ml3rc/SNA/Software/docs/hardware/README.md

# Hardware (Altium)

4-layer PCB in a milled aluminium case. Altium project: [`Altium/SNA.PrjPcb`](../../../Altium/SNA.PrjPcb) ·
BOM / netlist / STEP: [`Altium/Project Outputs for SNA/`](../../../Altium/Project%20Outputs%20for%20SNA/) ·
pin map: [PINMAP.md](../firmware/protocol/PINMAP.md). Diagrams are draw.io sources in
[`../presentation/diagrams/`](../presentation/diagrams/); animations in
[`../presentation/animations/`](../presentation/README.md#animations).

## System

System overview

## Schematic sheets

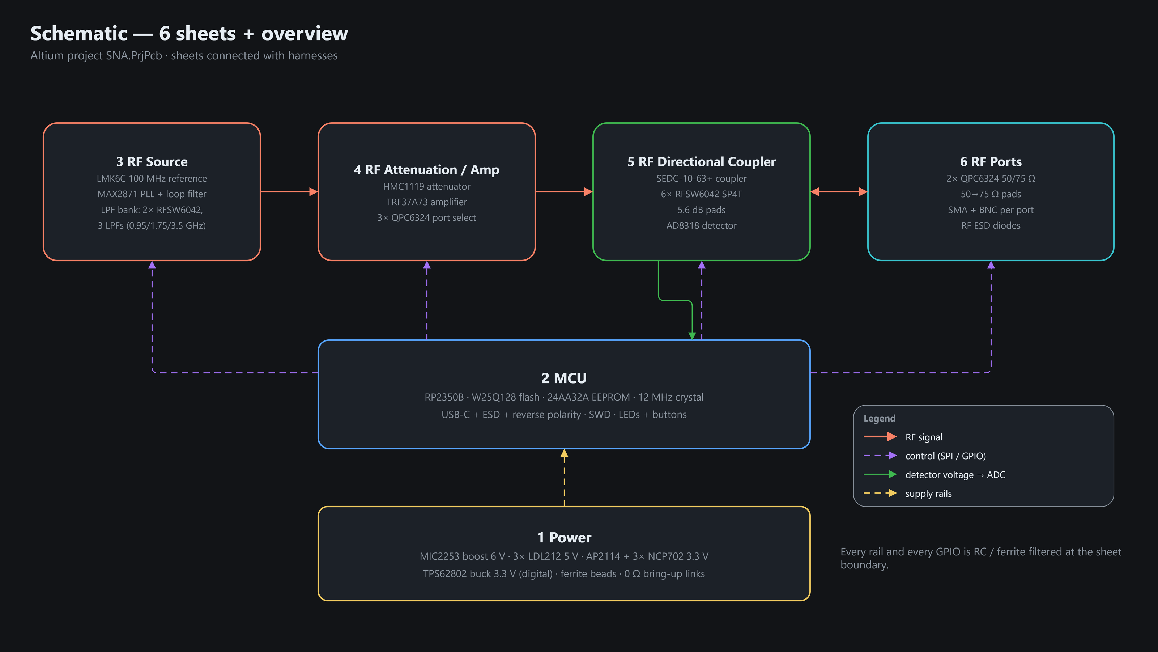
[picture p4: Software/docs/presentation/diagrams/export/hw-09-schematic-sheets.png]
Schematic sheets


| Sheet | Key parts |
|---|---|
| 1 Power | MIC2253 boost 6 V · 3× LDL212 5 V · AP2114 + 3× NCP702 3.3 V · TPS62802 buck 3.3 V |
| 2 MCU | RP2350B · W25Q128 flash · 24AA32A EEPROM · 12 MHz crystal · USB-C · SWD |
| 3 RF Source | LMK6C 100 MHz · MAX2871 · LPF bank (2× RFSW6042, 0.95 / 1.75 / 3.5 GHz LPFs) |
| 4 RF Attenuation / Amp | HMC1119 · TRF37A73 · 3× QPC6324 port select |
| 5 RF Directional Coupler | SEDC-10-63+ · 6× RFSW6042 · 5.6 dB pads · AD8318 |
| 6 RF Ports | 2× QPC6324 50/75 Ω · 50→75 Ω pads · SMA + BNC · RF ESD |

## Power

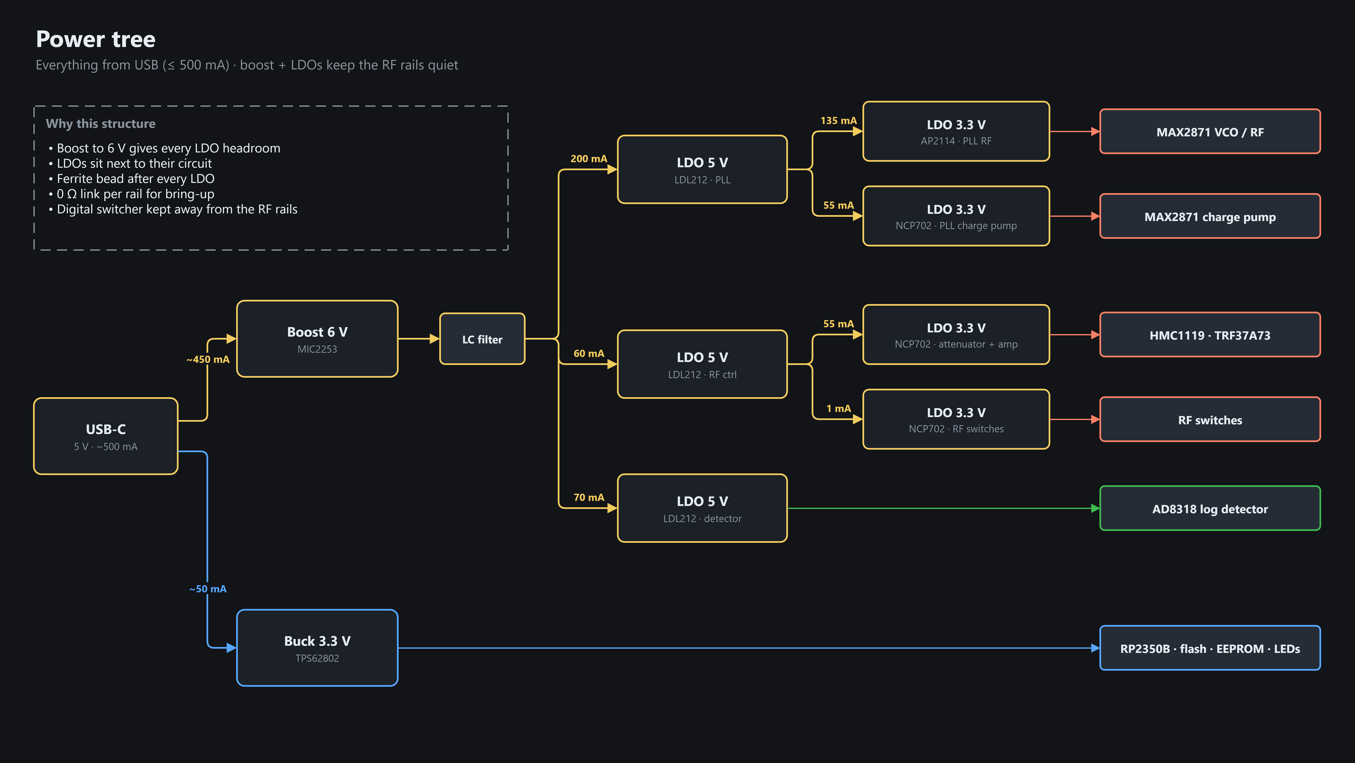
[picture p5: Software/docs/presentation/diagrams/export/hw-02-power-tree.png]
Power tree


## MCU

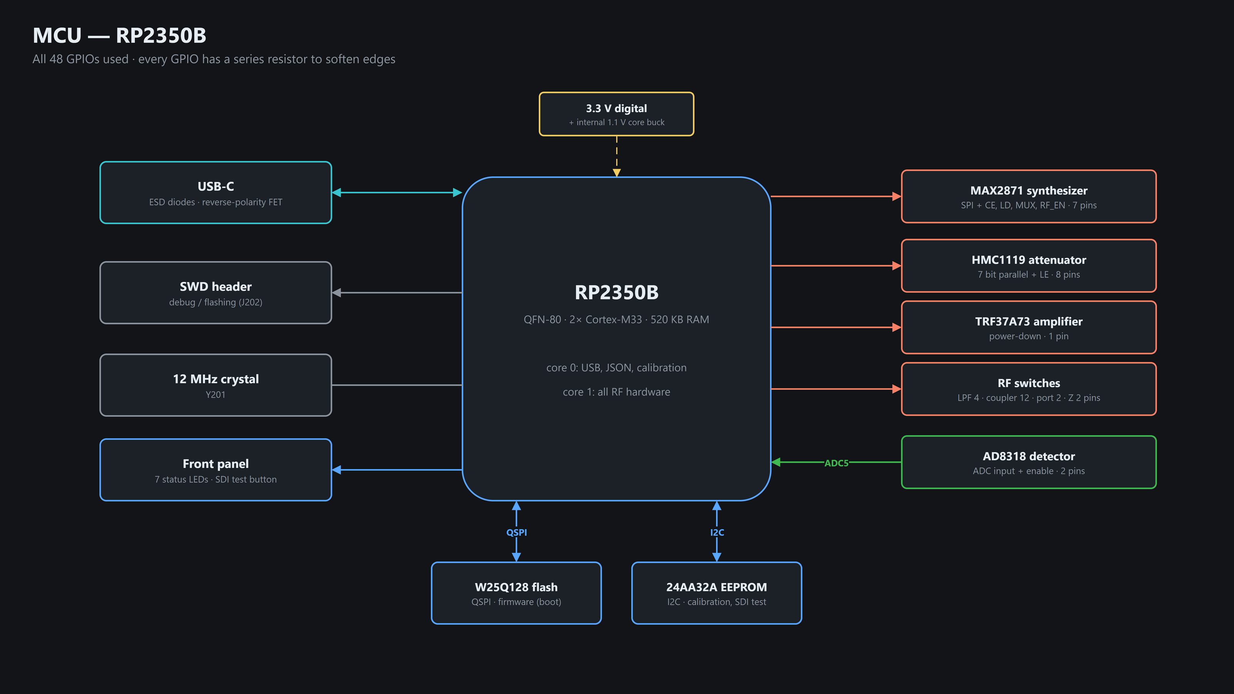
[picture p6: Software/docs/presentation/diagrams/export/hw-03-mcu.png]
MCU


## RF chain

RF chain

### Synthesizer (MAX2871)

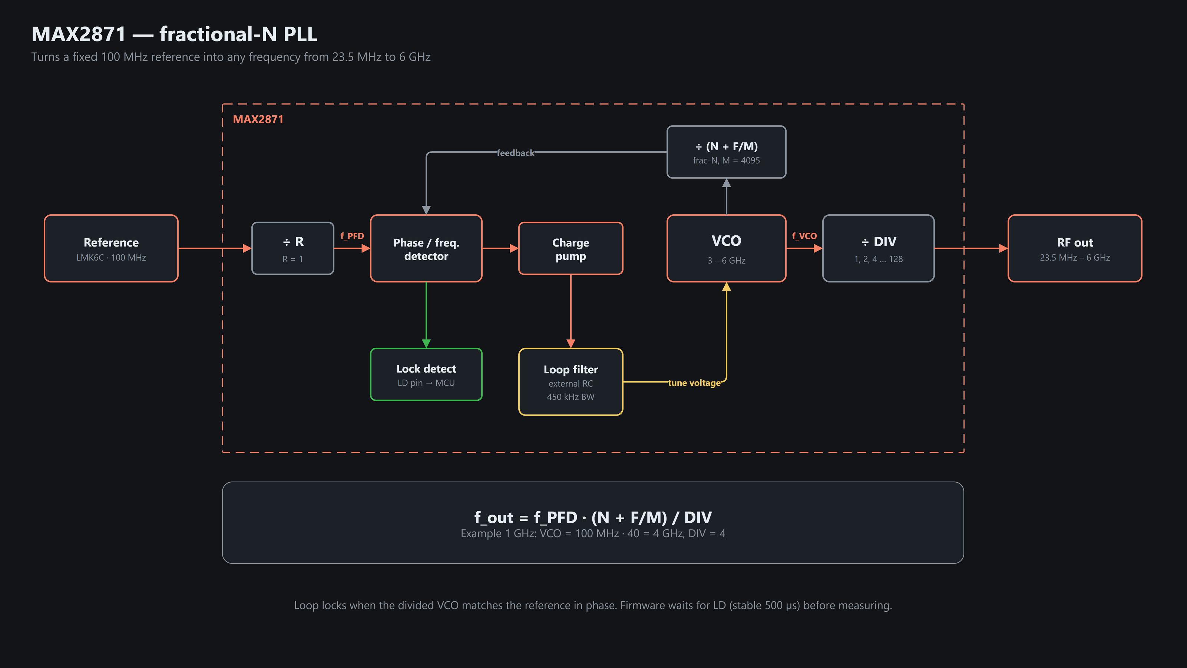
[picture p7: Software/docs/presentation/diagrams/export/hw-05-pll.png]
PLL


### Coupler bank → S-parameters

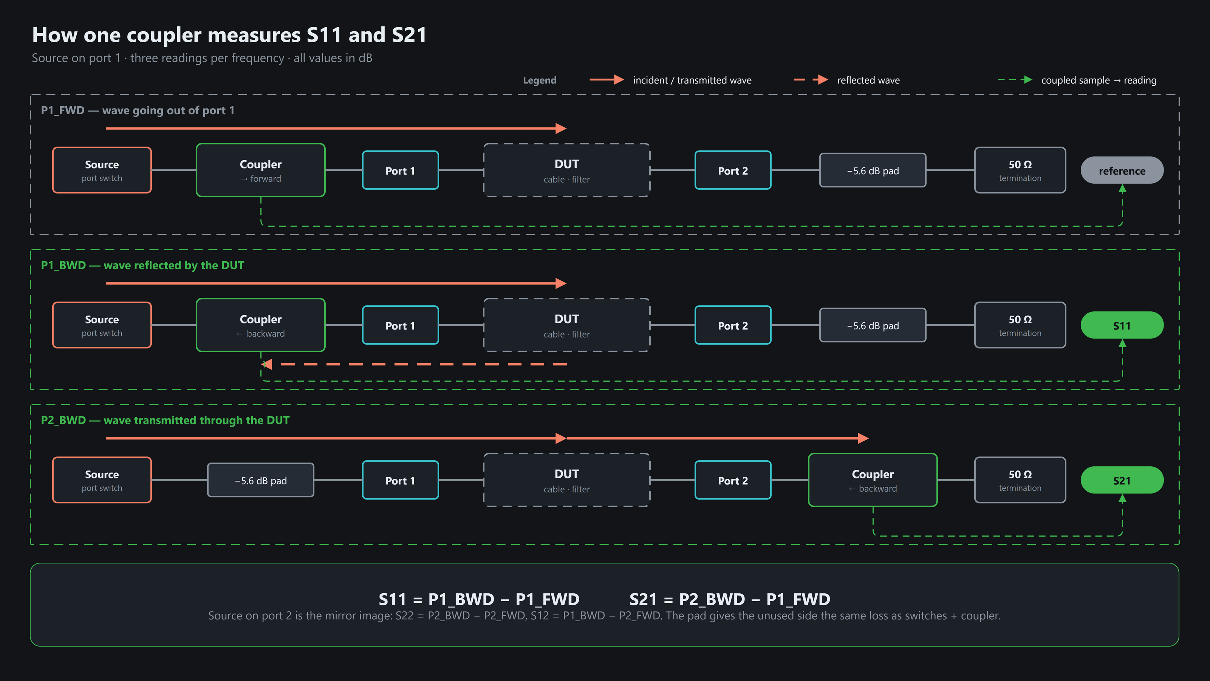
[picture p8: Software/docs/presentation/diagrams/export/hw-06-coupler-paths.png]
Coupler paths


### Pads

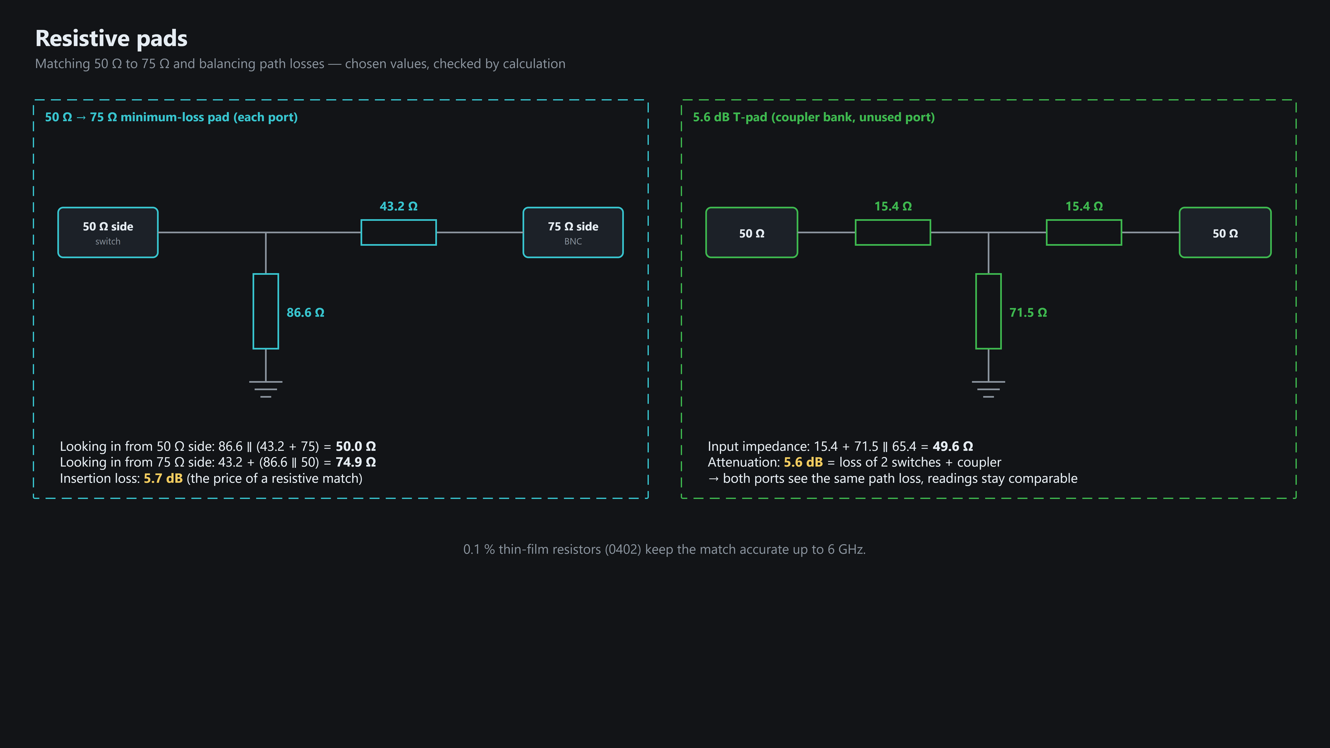
[picture p9: Software/docs/presentation/diagrams/export/hw-07-pads.png]
Pads


## PCB

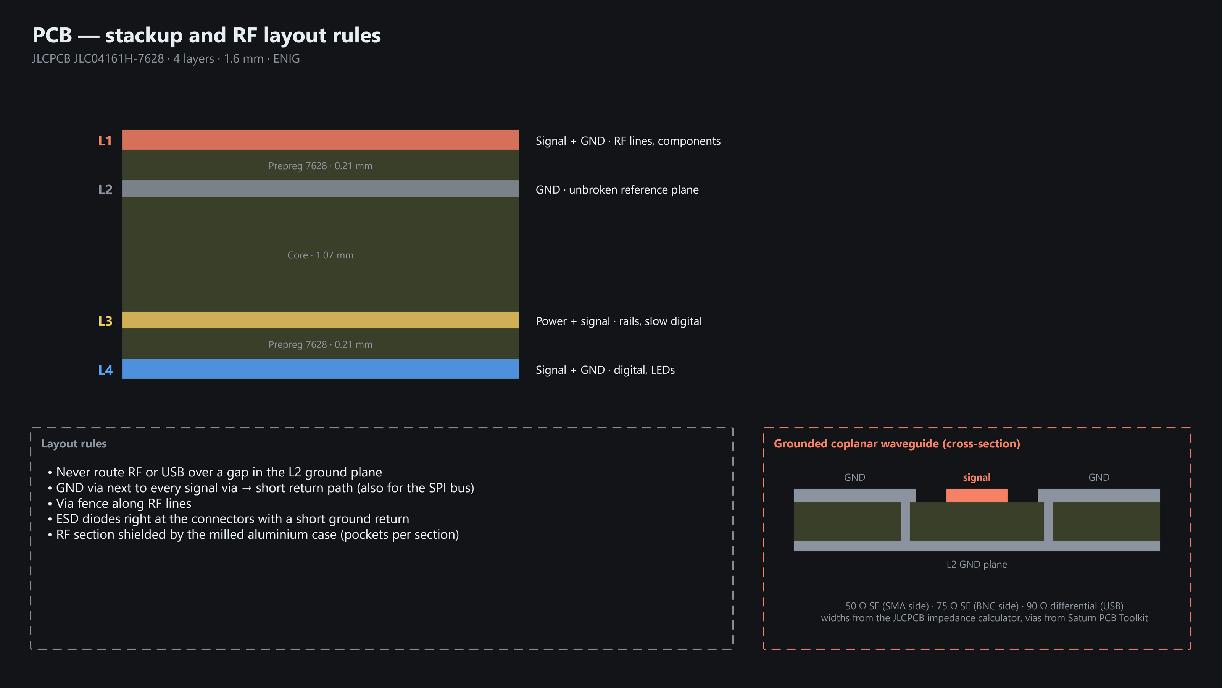
[picture p10: Software/docs/presentation/diagrams/export/hw-08-pcb-stackup.png]
Stackup


## Known erratum

Q202/Q203 (BSS84AK): footprint has drain and source swapped, so the body diode always lights the drain-side LED.
Hardware-only; fixed by rework, documented as a deviation in the report.
