ml3rc/SNA/Software/docs/presentation/README.md

# Presentation material

Dark theme, 16:9 (1600 × 900 canvas). Diagrams are English only; the animations also exist in German (see
[German animations](#german-animations)). Same palette in diagrams and animations:

| Colour | Meaning |
|---|---|
| `#F78166` | RF signal / source chain |
| `#58A6FF` | core 0, USB, digital |
| `#A371F7` | core 1, RF control firmware |
| `#3FB950` | detector, measurement, results |
| `#F2CC60` | power, warnings |
| `#39C5CF` | PC / client, ports |

## Diagrams (draw.io)

Sources: `diagrams/*.drawio` (open in draw.io desktop or diagrams.net). Exports for slides: `diagrams/export/*.png`
(2×) and `*.svg`.

| # | Diagram | Shows |
|---|---|---|
| hw-01 | [System overview](diagrams/export/hw-01-system-overview.png) | PC, board blocks, ports, DUT |
| hw-02 | [Power tree](diagrams/export/hw-02-power-tree.png) | USB → boost → LDOs, currents |
| hw-03 | [MCU](diagrams/export/hw-03-mcu.png) | RP2350B and everything on its pins |
| hw-04 | [RF chain](diagrams/export/hw-04-rf-chain.png) | Source → filters → level → port select → coupler bank → ports, detector |
| hw-05 | [PLL](diagrams/export/hw-05-pll.png) | MAX2871 fractional-N loop, formula |
| hw-06 | [Coupler paths](diagrams/export/hw-06-coupler-paths.png) | How one coupler measures S11 and S21 |
| hw-07 | [Pads](diagrams/export/hw-07-pads.png) | 50→75 Ω minimum-loss pad, 5.6 dB T-pad, with the math |
| hw-08 | [PCB stackup](diagrams/export/hw-08-pcb-stackup.png) | 4 layers, coplanar waveguide, layout rules |
| hw-09 | [Schematic sheets](diagrams/export/hw-09-schematic-sheets.png) | The 6 Altium sheets and how they connect |
| fw-01 | [Dual core](diagrams/export/fw-01-dual-core.png) | Core 0 / core 1 split, queues, cancel |
| fw-02 | [Layers](diagrams/export/fw-02-layers.png) | application → state → blocks → HAL |
| fw-03 | [Modes](diagrams/export/fw-03-modes.png) | IDLE and the four modes |
| fw-04 | [Sweep sequence](diagrams/export/fw-04-sweep-sequence.png) | Host ↔ core 0 ↔ core 1 ↔ RF, per point |
| fw-05 | [Sweep point](diagrams/export/fw-05-sweep-point.png) | Flowchart of one point |
| fw-06 | [Point timing](diagrams/export/fw-06-point-timing.png) | Where the ≈ 2 ms go, pipelining |
| fw-07 | [Source states](diagrams/export/fw-07-source-states.png) | OFF / PARKED / ON and the safe switching order |
| fw-08 | [Calibration](diagrams/export/fw-08-calibration.png) | Wizard steps → curves → EEPROM → subtraction |
| fw-09 | [EEPROM map](diagrams/export/fw-09-eeprom-map.png) | 4 KB layout to scale |
| fw-10 | [Boot](diagrams/export/fw-10-boot.png) | Boot sequence, blink codes, LEDs |
| fw-11 | [Request path](diagrams/export/fw-11-request-path.png) | JSON line → core 0 → core 1 → reply, what is allowed mid-sweep |
| fw-12 | [Raw → dB](diagrams/export/fw-12-raw-to-db.png) | Codes → ratio → calibration, the frequency grid |
| fw-13 | [SDI button + watchdog](diagrams/export/fw-13-sdi-button-watchdog.png) | On-board button test states, watchdog |
| api-01 | [Messages](diagrams/export/api-01-messages.png) | Request / reply / stream / event |
| api-02 | [Command map](diagrams/export/api-02-command-map.png) | Commands per mode |
| api-03 | [Sessions](diagrams/export/api-03-sequences.png) | Sweep session, generator → power meter session |
| api-04 | [Errors](diagrams/export/api-04-errors.png) | Validation order → error codes |
| sw-01 | [Client](diagrams/export/sw-01-client-architecture.png) | Kotlin Multiplatform client layers |

The `.drawio` files are the source: edit them directly in draw.io, then export with
`bash diagrams/src/export.sh [name …]` (needs draw.io desktop, `scoop install extras/draw.io`).
`diagrams/src/build_*.py` (helpers in `dio.py`) only produced the first version; re-running one overwrites hand
edits in the diagrams it builds. When several arrows mean the same thing, give the diagram a legend instead of
labelling one of them.

Electrical symbols are IEC everywhere (diagrams and animations): resistor = rectangle, always 90 × 30 px in the
diagrams (0.8 × 0.27 units in Manim, `resistor()` in `sna_style.py`), ground = three bars, amplifier = triangle.

## Animations (Manim)

1080p60 MP4s in `animations/videos/` (drop straight into PowerPoint / Google Slides). Sources:
`hardware_scenes.py`, `firmware_scenes.py`, shared look in `sna_style.py`.

Each video is also cut into its steps, one clip per caption: `animations/videos/steps/<Scene>/01.mp4, 02.mp4, …`
(German: `de/videos/steps/`). Stack the clips of a scene on one slide and give each one "Appear + Play" on click:
every click plays one step and the last frame stays until the next click. Step boundaries are `self.next_section()`
in the scenes (firmware scenes: every `Captions.show()` starts a step unless `step=False`).

| Video | Length | Shows |
|---|---|---|
| [PllSynthesis](animations/videos/PllSynthesis.mp4) | 30 s | PLL loop builds up, VCO locks to 4 GHz, ÷4 → 1 GHz, LD goes high |
| [DirectionalCoupler](animations/videos/DirectionalCoupler.mp4) | 41 s | Coupler principle, one coupler + 6 SP4T, three readings → S11 / S21 |
| [LogDetector](animations/videos/LogDetector.mp4) | 40 s | AD8318 curve, 16 samples → median, dB as a subtraction |
| [ImpedancePads](animations/videos/ImpedancePads.mp4) | 28 s | 50 / 75 Ω switch, minimum-loss pad, impedances both ways |
| [PowerTree](animations/videos/PowerTree.mp4) | 21 s | Rails light up from USB through boost and LDOs |
| [MeasurementFlow](animations/videos/MeasurementFlow.mp4) | 55 s | One S11 point: JSON → cores → RF → detector → dB → chart |
| [SweepPipeline](animations/videos/SweepPipeline.mp4) | 48 s | Per-point timing, two cores in a pipeline, backpressure, curve drawn |
| [Calibration](animations/videos/Calibration.mp4) | 54 s | Open / Short / Thru → curves → EEPROM → raw − curve |
| [SourceSafety](animations/videos/SourceSafety.mp4) | 46 s | Wrong vs right parking order, double register write |
| [ModesAndCommands](animations/videos/ModesAndCommands.mp4) | 30 s | Mode state machine with a live JSON log, `busy`, `mode_exit` |

Example numbers in the animations (ADC codes, levels, curve shapes) are illustrative, not measurements.

Render (from `animations/`, Python 3.12 venv with `manim==0.19.0`, no LaTeX needed):

```sh
uv venv --python 3.12 .venv && uv pip install --python .venv/Scripts/python.exe manim==0.19.0
bash render.sh                 # all scenes → videos/
bash render.sh PllSynthesis    # one scene
```

## German animations

Same videos with German labels, for the German slides. Exported only: the repo documentation links the English
files. Output: `de/videos/*.mp4` and `de/videos/steps/`. The diagrams have no German version.

All animation labels go through `i18n.py`: `SNA_LANG=de` looks each English string up in `i18n_de.py` (whole label
first, then line by line) and switches decimal points to commas; commands, JSON, part numbers and signal names stay
as they are. A new or changed English label needs its German entry; strings without one stay English and are listed
with `SNA_I18N_REPORT=<file>`.

```sh
cd animations && SNA_LANG=de bash render.sh    # → de/videos/
```
