ml3rc/SNA/Software/docs/firmware/boot-and-leds.md

# Boot, LEDs & SDI button

There is no separate front panel: the LEDs and the SDI test button sit on the PCB, and the milled aluminium case has
vertical holes above them (LEDs show through, the button is pressed through the case).

## Boot and LEDs

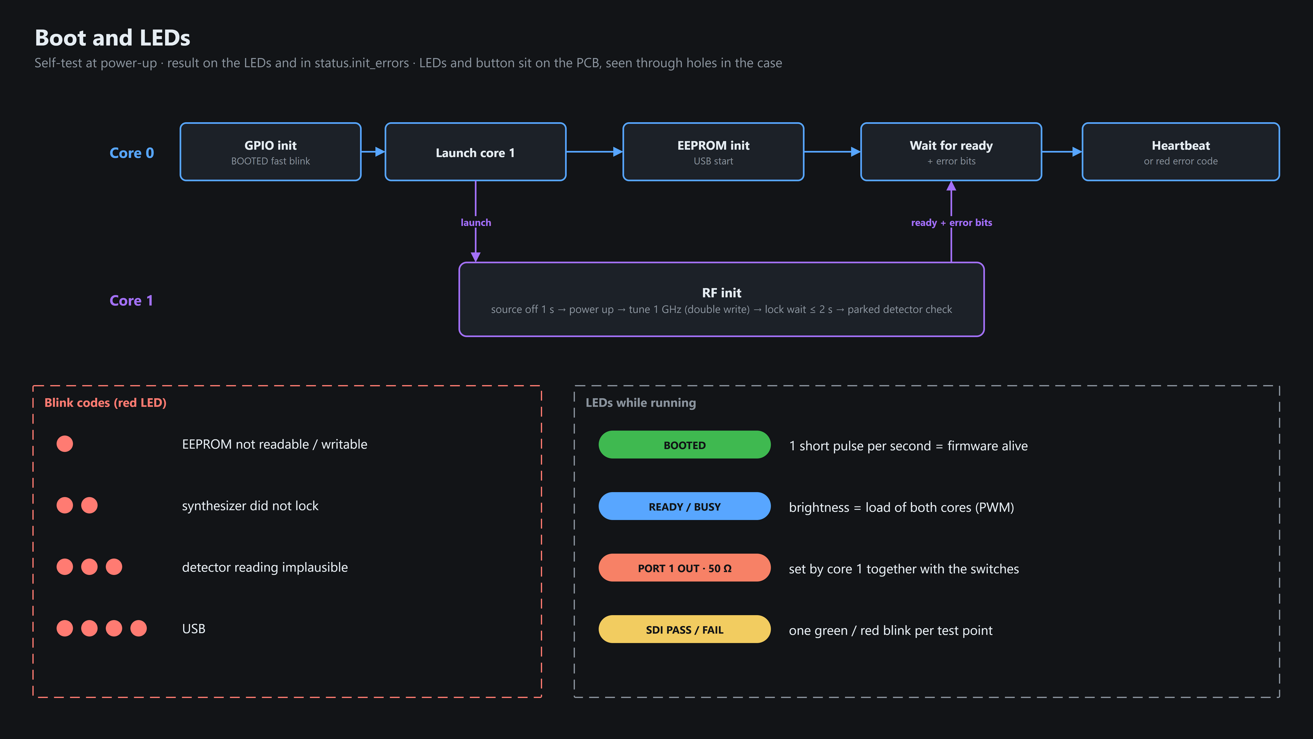
[picture p18: Software/docs/presentation/diagrams/export/fw-10-boot.png]
Boot and LEDs


## SDI test button (works without a PC) and watchdog

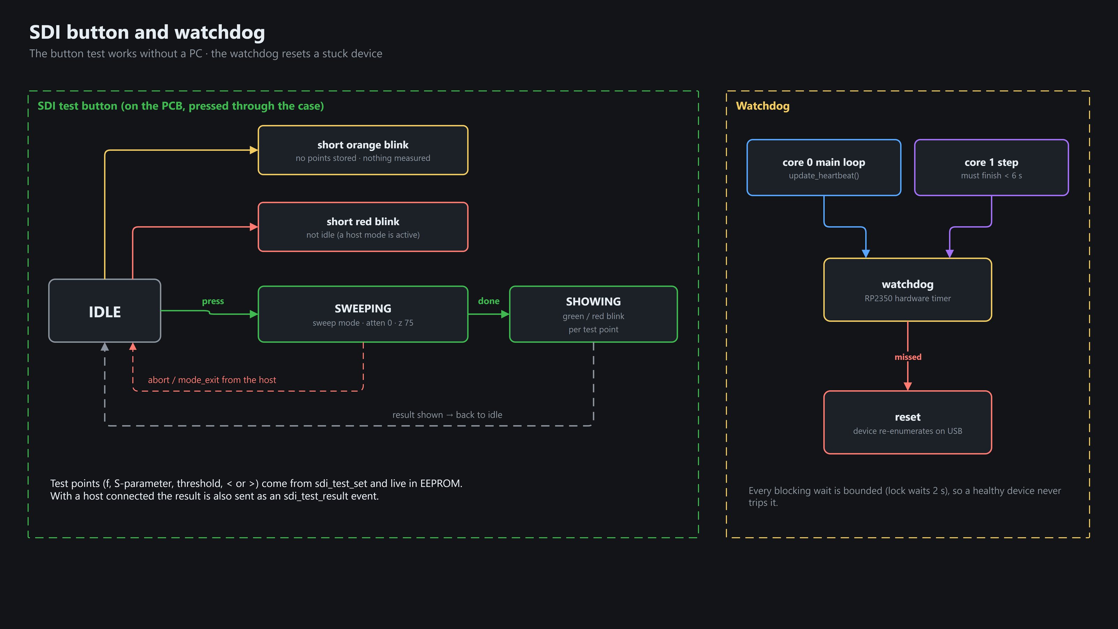
[picture p19: Software/docs/presentation/diagrams/export/fw-13-sdi-button-watchdog.png]
SDI button and watchdog
