ml3rc/SNA/Software/docs/firmware/modes.md

# Modes

One mode owns the RF hardware at a time. The host enters it, uses it, leaves it.

Modes

| Mode | Does | Output |
|---|---|---|
| IDLE | nothing | parked |
| SWEEP | S-parameter / raw-path sweeps (also entered by the SDI button) | routed per point |
| GENERATOR | CW signal at port 1/2 | on |
| PWR_DETECTOR | measure external power at a port | terminated |
| MANUAL | drive single blocks (bench diagnostics) | as set |

Settings (`set` z / atten) work in every mode, even mid-sweep. Only requests that endanger hardware are refused.

## Request path

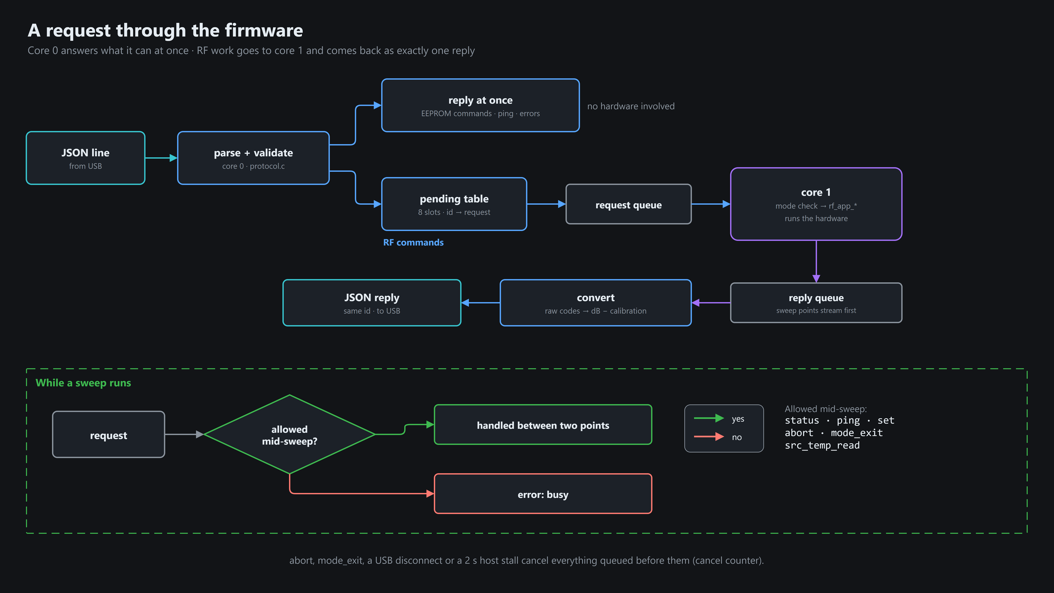
[picture p20: Software/docs/presentation/diagrams/export/fw-11-request-path.png]
Request path
