ml3rc/SNA/Software/docs/firmware/sweep.md

# Sweep

## End to end

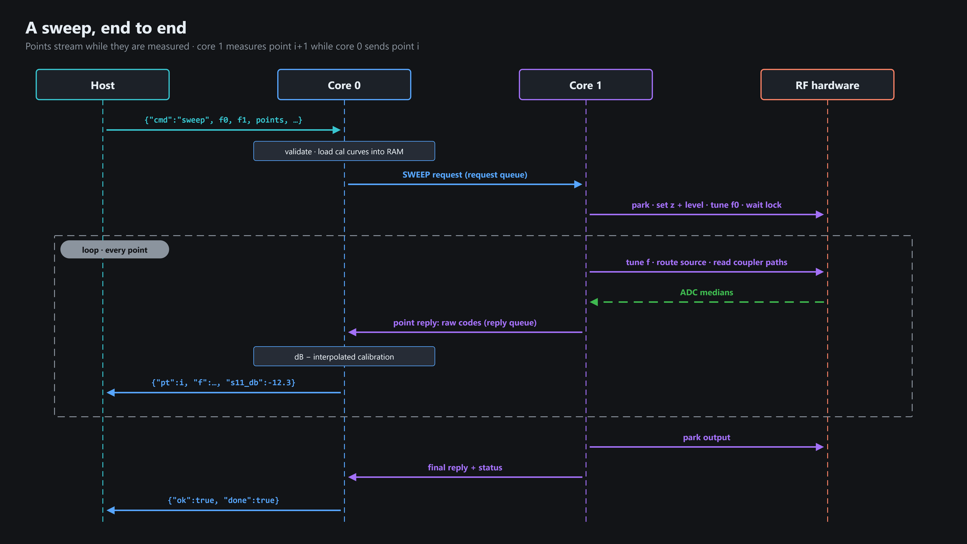
[picture p23: Software/docs/presentation/diagrams/export/fw-04-sweep-sequence.png]
Sweep sequence


Points are pipelined: core 1 measures point N+1 while core 0 sends point N.

## One point (core 1)

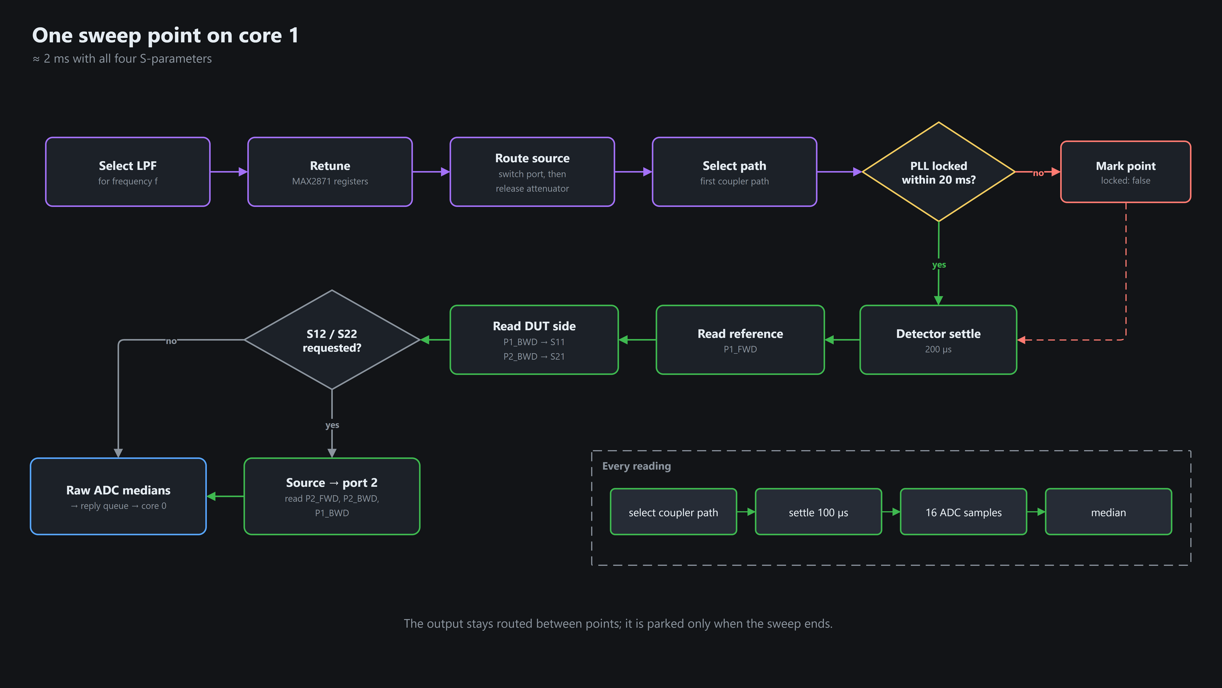
[picture p24: Software/docs/presentation/diagrams/export/fw-05-sweep-point.png]
Sweep point


## Time per point (all 4 S-parameters, ≈ 2 ms)

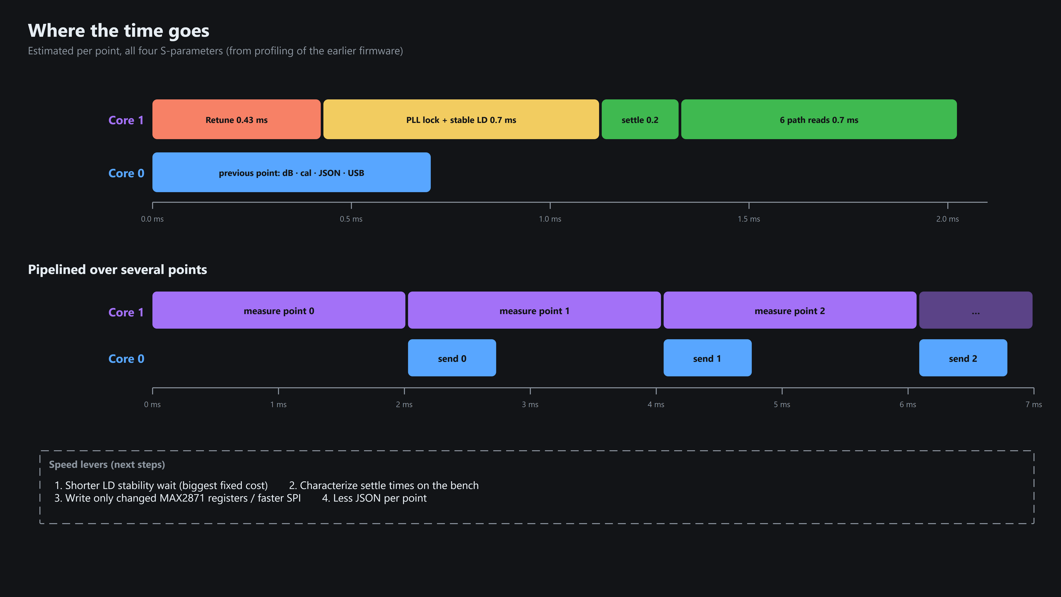
[picture p25: Software/docs/presentation/diagrams/export/fw-06-point-timing.png]
Point timing


## Raw codes → calibrated dB (core 0) and the frequency grid

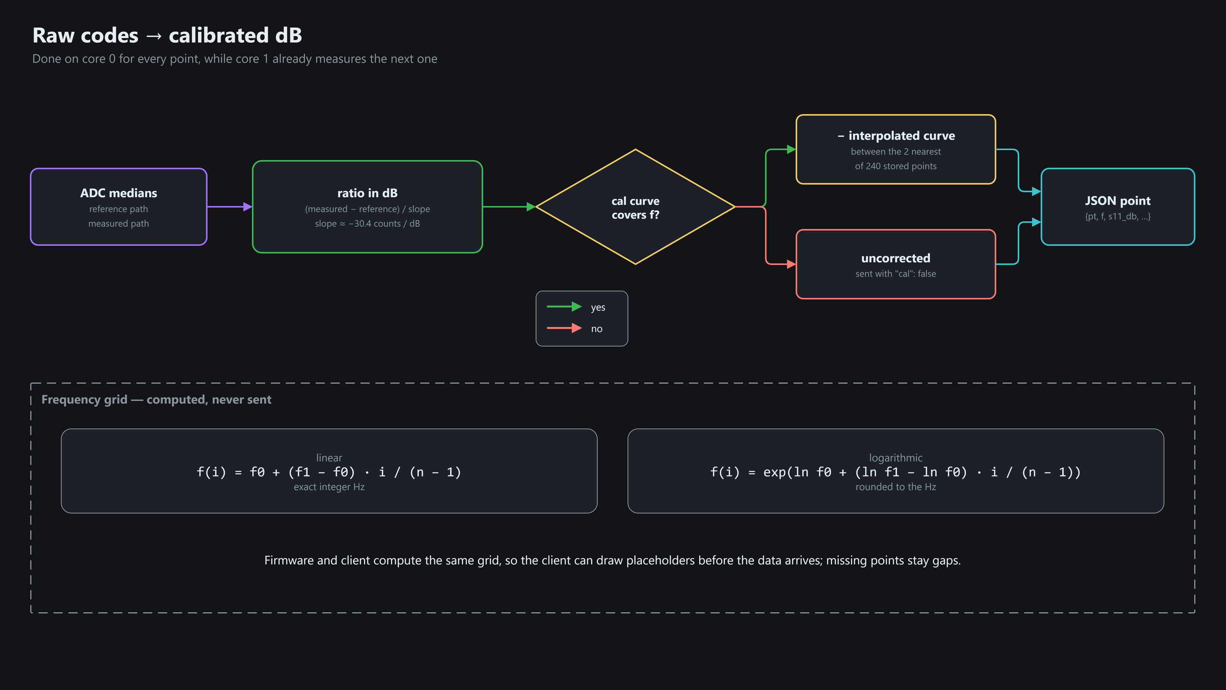
[picture p26: Software/docs/presentation/diagrams/export/fw-12-raw-to-db.png]
Raw to dB
