ml3rc/SNA/Software/docs/presentation/de/diagrams/api-01-messages.png

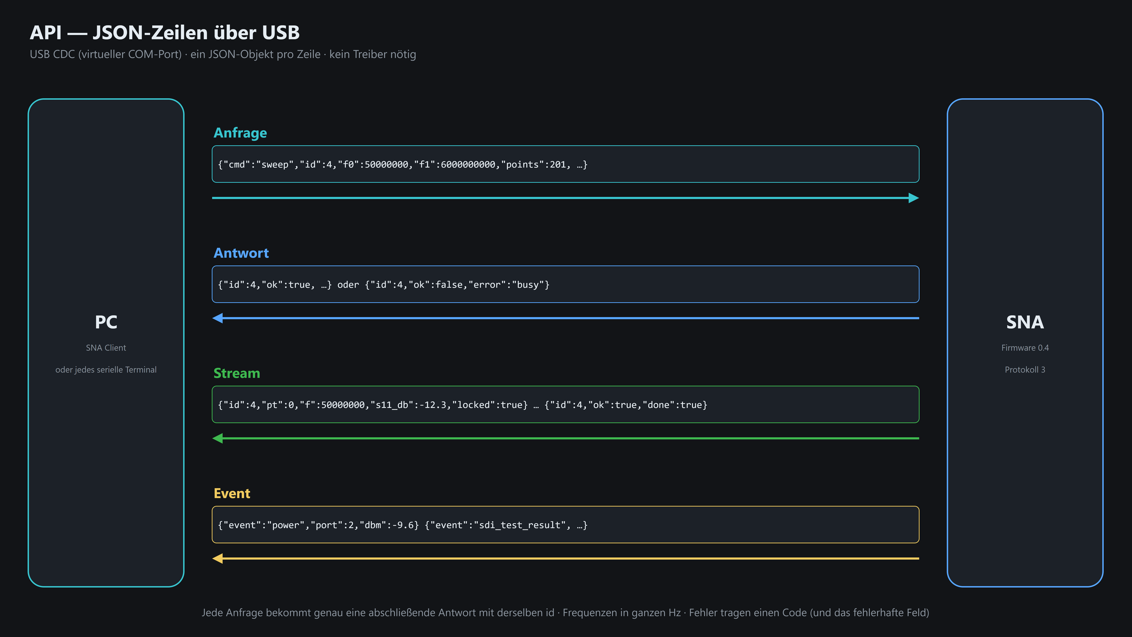
Software/docs/presentation/de/diagrams/api-01-messages.png
