ml3rc/SNA/Software/docs/presentation/de/diagrams/api-04-errors.png

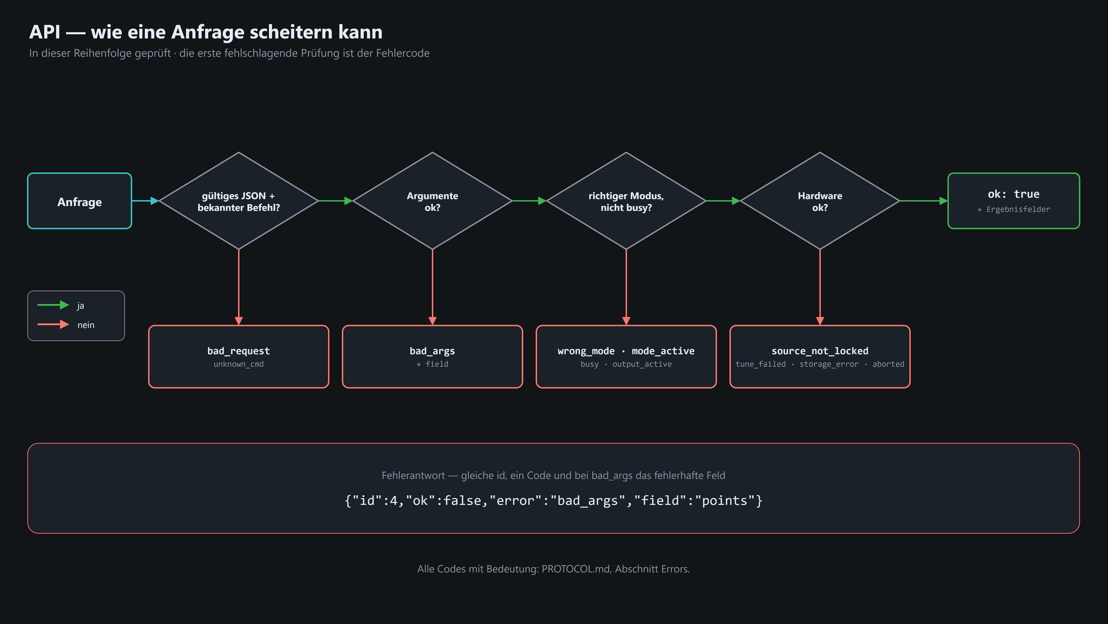
Software/docs/presentation/de/diagrams/api-04-errors.png
