ml3rc/SNA/Software/docs/presentation/de/diagrams/fw-03-modes.png

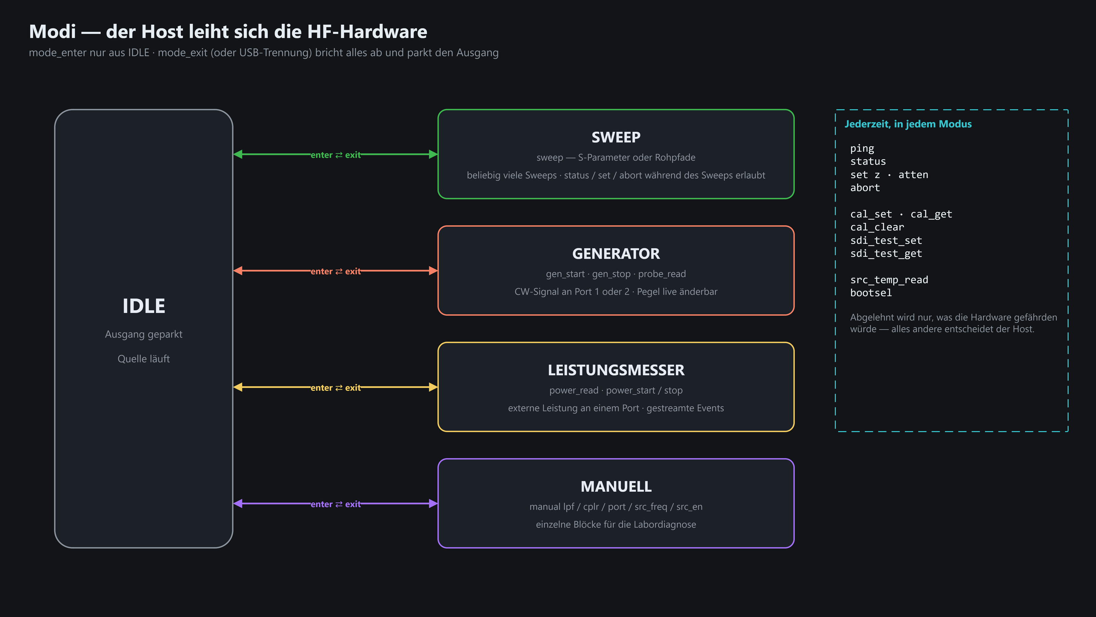
Software/docs/presentation/de/diagrams/fw-03-modes.png
