ml3rc/SNA/Software/docs/presentation/de/diagrams/fw-09-eeprom-map.png

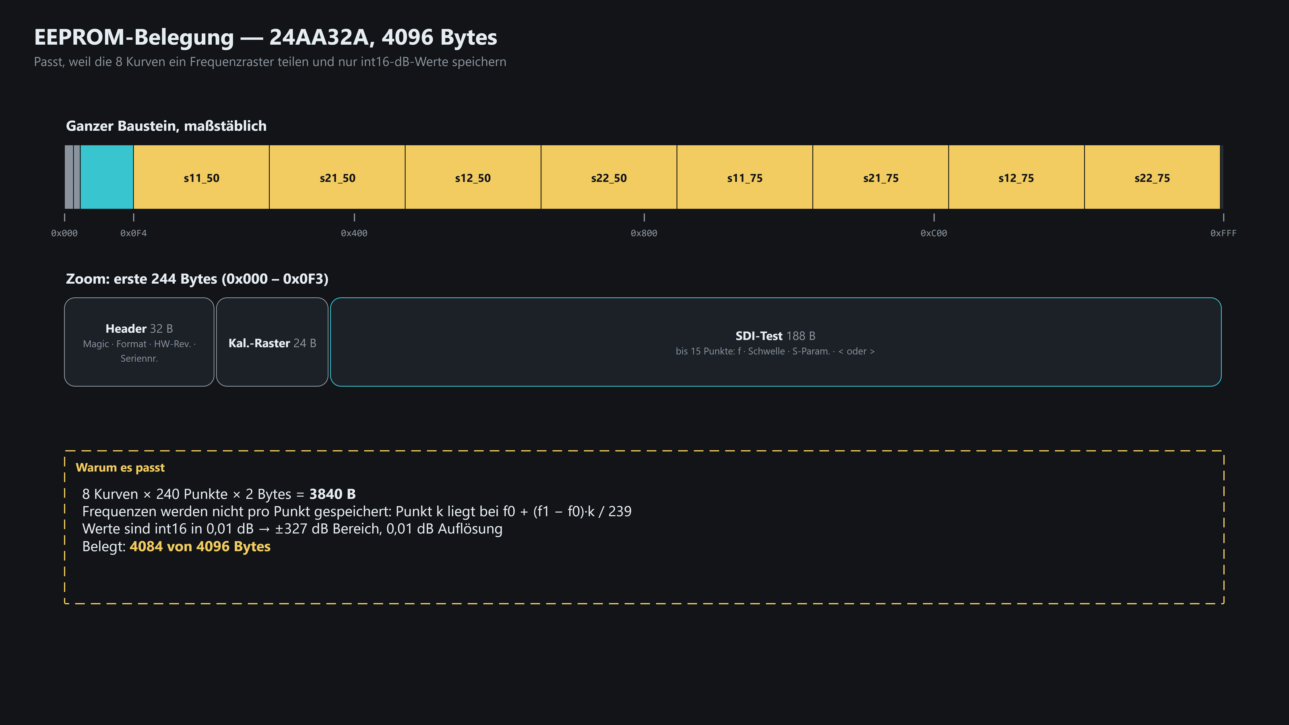
Software/docs/presentation/de/diagrams/fw-09-eeprom-map.png
