ml3rc/SNA/Altium/SNAPCBVersion-INT/BOM/SNAPCBVersion_SNA-Var_EMS_BOM_Rev.PCBVersion1.0.pdf

Name | Description | Designator | Quantity | Manufacturer 1 | Manufacturer Part Number 1
4.7u | Capacitor ceramic 4.7u 25V 10% X7R SMD--0805 | C101, C102, C103, C113, C114, C115, C122, C126 | 8 | Samsung Electro-Mechanics | CL21B475KAFNNNE
10n | Capacitor ceramic 10n 50V 5% C0G/NPO SMD--0603 | C104 | 1 | Murata | GRM1885C1H103JA01D
100p | Capacitor ceramic 100p 50V 5% C0G AEC-Q200 SMD--0402 | C105, C301, C302, C303, C305, C323, C324, C326, C327, C330, C331, C401, C402, C403, C404, C405, C406, C407, C408, C409, C410, C411, C412, C413, C414, C415, C416, C419, C421, C423, C424, C427, C428, C432, C433, C503, C504, C507, C508, C510, C511, C512, C513, C515, C516, C517, C518, C523, C524, C527, C528, C603, C604, C605, C606, C607, C608 | 57 | Samsung Electro-Mechanics | CL05C101JB51PND
10u | Capacitor ceramic 10u 25V 20% X5R SMD--0603 | C106 | 1 | Murata | GRM188R61E106MA73D
22u | Capacitor ceramic 22u 25V 20% X5R SMD--0805 | C107, C108, C109 | 3 | TAIYO YUDEN | MSAST21GBB5226MTNC12
1u | CAP CER 1UF 35V X7R 0603 10% | C110, C111, C112, C116, C117, C118, C119, C120, C121, C123, C124, C125, C312, C313, C316 | 15 | TDK | C1608X7R1V105K080AC
100n | Capacitor ceramic 100n 16V 10% X7R SMD--0402 | C127, C128, C129, C130, C131, C203, C209, C210, C211, C212, C213, C214, C215, C216, C217, C218, C219, C222, C306, C307, C308, C309, C310, C311, C315, C319, C322, C325, C328, C417, C420, C422, C425, C429, C434, C435, C505, C506, C509, C514, C519, C520, C525, C526, C529, C530, C609, C610 | 48 | Samsung Electro-Mechanics | CL05B104KO5NNNC
15p | Capacitor ceramic 15p 50V 1% C0G SMD--0402 | C201, C202 | 2 | Yageo Group | CQ0402FRNPO9BN150
10n | Capacitor ceramic 10n 35V 2% C0G SMD--0402 | C204, C531, C532 | 3 | Murata | GRM1555CYA103GE01D
4.7u | Capacitor ceramic 4.7u 6.3V 20% X5R SMD--0402 | C205, C206, C207, C208 | 4 | Murata | GRM155R60J475ME47D
470p | Capacitor ceramic 470p 50V 5% C0G SMD--0402 | C304, C314, C320, C329, C418, C426, C501, C502, C521, C522, C533, C534, C611, C612, C613, C614 | 16 | TDK | CGA2B2C0G1H471J050BA
180p | Capacitor ceramic 180p 50V 5% C0G SMD--0402 | C317 | 1 | Samsung Electro-Mechanics | CL05C181JB5NNNC
3.3n | Capacitor ceramic 3.3n 50V 10% X7R AEC-Q200 SMD--0402 | C318 | 1 | Samsung Electro-Mechanics | CL05B332KB5VPNC
18p | Capacitor ceramic 18p 50V 5% C0G SMD--0402 | C321 | 1 | Samsung Electro-Mechanics | CL05C180JB5NNNC
SSA24-E3/61T | Schottky Diode SSA24-E3/61T 40V 2A | D101 | 1 | Vishay | SSA24-E3/61T
ESD9R3.3S | TVS Diode ESD9R3.3ST5G 3V3 0.5pF, 1nA SMD--SOD-923 | D201, D202, D203, D204, D205 | 5 | onsemi | ESD9R3.3ST5G
150060RS75000 | LED 150060RS75000 2V 30mA Red 630nm 250mcd 140° SMD--0603 | D206 | 1 | Wuert Elektronik | 150060RS75000
150060GS75000 | LED 150060GS75000 3.2V 30mA Green 515nm 430 mcd 140° SMD--0603D207, D208, D209, D210, D211, D212, D213, D214, D215 | | 9 | Wuert Elektronik | 150060GS75000
SESD0402X1BN-0010-098 | TVS Diode, 7V, 0.1pF | D216, D601, D602, D603, D604 | 5 | Littelfuse | RF2945-000
LP0805A3500AWTR | Low Pass Filter 3500MHz 50 Ohms | FL301 | 1 | KYOCERA AVX | LP0805A3500AWTR
LP0603A1747ANTR | Low Pass Filter 1747MHz 50 Ohms | FL302 | 1 | KYOCERA AVX | LP0603A1747ANTR
LP0603A0947ANTR | Low Pass Filter 947MHz 50 Ohms | FL303 | 1 | KYOCERA AVX | LP0603A0947ANTR
SEDC-10-63+ | Directional Coupler, 50 MHz to 6 GHz, 50 Ohms, SMD | FL501 | 1 | Mini-Circuits | SEDC-10-63+
Type C f | Connector USB 2171790001 Type C f MOL--CO--2171790001 | J201 | 1 | Molex | 217179-0001
SM03B-SRSS-TB | Connector SM03B-SRSS-TB SMD, 90°, Raspberry JST Debug | J202 | 1 | JST | SM03B-SRSS-TB(LF)(SN)
SMA f | Connector Coaxial 142-0701-871 SMA f Edge--142-0701-871 | J601, J603 | 2 | Chinch Connectivity Solutions Johnson 142-0701-871
BNC jack | Connector Coaxial BNC7T-J-P-GN-RA-BM1D BNC jack right angle 75OhmJ602, J604 | | 2 | Samtec | BNC7T-J-P-GN-RA-BM1D
2.2u | Inductor SRP4020FA-2R2M 2.2u 3.1A 21.35mR 38MHz SMD--SRP4020FAL101, L103, L104 | | 3 | Bourns | SRP4020FA-2R2M
470n | Inductor DFE252012F-R47M=P2 470n 7.4A 17mR SMD--2520 | L102 | 1 | Murata | DFE252012F-R47M=P2
33E | Ferrit Bead MPZ1005S330HT000 33E 3A 22mE SMD--0402 | L105, L106, L107, L108, L109, L110, L111, L201, L202, L205, L301, L302, L303, L304, L305, L306, L401, L402, L404, L405, L406, L407, L501, L502, L503, L504, L505, L506, L507, L508, L601, L602 | 32 | TDK Group | MPZ1005S330HT000
3.3u | Inductor AOTA-B201610S3R3-101-T 3.3u 2.1A 140mOhm | L203 | 1 | Abracon | AOTA-B201610S3R3-101-T
100nH | Inductor 100nH 290mA AEC-Q200 SMD--0603 | L403 | 1 | Coilcraft | 0603DC-R10XJRW
DMP6050SFG | MOSFET, P-channel, 60 V, -4.8 A | Q201 | 1 | Diodes Inc. | DMP6050SFG-13
BSS84AK,215 | MOSFET P-CH 50V 180MA TO236AB | Q202, Q203 | 2 | Nexperia | BSS84AK,215
249k | Resistor 249k 75V 0.1W 0.1% SMD--0603 | R101 | 1 | Yageo Group | RT0603BRD07249KL
620E | Resistor 620E 75V 0.1W 0.1% ±25ppm/°C SMD--0603 | R102 | 1 | Yageo Group | RT0603FRE07620RL
10k | Resistor 10k 75V 0.1W 0.1% 25ppm SMD--0603 | R103, R105 | 2 | Susumu | RG1608P-103-B-T5
38.3k | Resistor 38.3k 75V 0.1W 0.1% SMD--0603 | R104 | 1 | Yageo Group | RT0603BRD0738K3L
4.7k | Resistor 4.7k 75V 0.1W 1% SMD--0603 | R106 | 1 | Yageo Group | RC0603FR-074K7L
0E | Resistor 0E 75V 0.125W SMD--0603 | R107, R108, R109, R110, R111, R112, R113, R114, R115 | 9 | Vishay | MCT06030Z0000ZP500
1k | Resistor 1k 50V 0.063W 1% SMD--0402 | R201, R202, R203, R260, R263, R537, R538 | 7 | Panasonic | ERJ2RKF1001X

Name | Description | Designator | Quantity | Manufacturer 1 | Manufacturer Part Number 1
10k | Resistor 10k 50V 0.063W 1% SMD--0402 | R204, R206, R228, R261, R264, R301, R302, R303, R304, R312, R313, R315, R316, R317, R318, R319, R320, R401, R402, R403, R404, R405, R406, R407, R408, R409, R410, R411, R412, R413, R501, R502, R503, R504, R505, R506, R507, R508, R511, R512, R513, R514, R517, R518, R521, R522, R525, R526, R527, R528, R531, R532, R533, R534, R536, R601, R602, R603, R604 | 59 | Panasonic | ERJ-2RKF1002X
5.1k | Resistor 5.1k 50V 0.063W 1% SMD--0402 | R205, R207, R305 | 3 | Panasonic | ERJ-2RKF5101X
33E | Resistor 33E 50V 0.063W 0.5% SMD--0402 | R208 | 1 | Panasonic | ERA-2AKD330X
71.5E | Resistor 71.5E 50V 0.0625W 0.1% SMD--0402 | R209, R223, R224, R225, R226, R227, R258, R259, R262, R519, R520 | 11 | Panasonic | ERA-2AEB71R5X
100E | Resistor 100E 50V 0.063W 0.01 SMD--0402 | R210, R211, R212, R213, R214, R215, R216, R217, R218, R219, R220, R221, R231, R232, R233, R234, R235, R236, R237, R238, R239, R240, R241, R242, R243, R244, R245, R246, R247, R248, R249, R250, R251, R252, R253, R254, R255, R265, R266, R314 | 40 | Vishay | CRCW0402100RFKEDC
200E | Resistor 200E 50V 0.063W 1% SMD--0402 | R222 | 1 | Panasonic | ERJ-2RKF2000X
4.7k | Resistor 4.7k 50V 0.063W 1% SMD--0402 | R229, R230 | 2 | Panasonic | ERJ-2RKF4701X
27E | Resistor 27E 50V 0.063W 1% SMD--0402 | R256, R257 | 2 | Vishay | CRCW040227R0FKED
49.9E | Resistor 49.9E 50V 0.1W 1% SMD--0402 | R306, R307, R308, R509, R510, R529, R530 | 7 | Stackpole Electronics | RNCP0402FTD49R9
1.8k | Resistor 1.8k 50V 0.063W 1% SMD--0402 | R309 | 1 | Stackpole Electronics | RMCF0402FT1K80
82E | Resistor 85E 25V 0.063W 0.5% SMD--0402 | R310 | 1 | Susumu | RR0510R-820-D
330E | Resistor 330E 50V 0.063W 1% SMD--0402 | R311 | 1 | Panasonic | ERJ-2RKF3300X
15.4E | Resistor 15.4E 50V 0.1W 0.1% SMD--0402 | R515, R516, R523, R524 | 4 | TE Connectivity / AMP | 1-2176309-9
52.3E | Resistor 52.3E 50V 0.1W 0.1% SMD--0402 | R535 | 1 | TE Connectivity / AMP | 7-2176304-0
499E | Resistor 499E 50V 0.063W 1% SMD--0402 | R539 | 1 | Yageo Group | RC0402FR-07499RL
86.6E | Resistor 86.6E 50V 0.1W 0.1% SMD--0402 | R605, R606 | 2 | TE Connectivity | RP73PF1E86R6BTD
43.2E | Resistor 43.2E 50V 0.1W 0.1% SMD--0402 | R607, R608 | 2 | TE Connectivity / AMP | 6-2176304-2
PTS845 | Pushbutton PTS845 90° SMD | S201, S202 | 2 | C&K Components | PTS845VM20PSMTR4 LFS
FSMRA4JH | Pushbutton 1-1825027-1 24V 50mA 90° THT-4pin | S203 | 1 | TE Connectivity | 1-1825027-1
TPS62802YKA | DCDC Buck Converter 1.75-V to 5.5-V input 1-A ultra-low IQ | U101 | 1 | Texas Instruments | TPS62802YKAT
MIC2253-06YML | Switching Voltage Regulators 3.5A 1MHz High Efficiency Boost Regulator with OVP & Softstart U102 | | 1 | Microchip | MIC2253-06YML-TR
LDL212PU50R | LDO 1.2A Low Drop Linear Regulator IC | U103, U104, U105 | 3 | STMicroelectronics | LDL212PU50R
AP2114H-3.3TRG1 | LDO 3.3V Fixed 1A Low Noise CMOS LDO Regulator With Enable | U106 | 1 | Diodes Inc. | AP2114H-3.3TRG1
NCP702SN33T1G | LDO 3.3V Fixed 200 mA | U107, U108, U109 | 3 | onsemi | NCP702SN33T1G
W25Q128JVSIQ TR | NOR-Flash Memory W25Q128JVSIQ TR SPI SMD--SOIC8 | U201 | 1 | Winbond | W25Q128JVSIQ TR
SC1510(13)-A4 | MCU RP2350B 150MHz clock Dual Arm Cortex-M33 cores 520KB RAM 8KB on-chip QFN-80 U202 | | 1 | Raspberry Pi | SC1510(13)-A4
24AA32A-I/MC | EEPROM 24AA32AT 32K SMD--DFN | U203 | 1 | Microchip | 24AA32AT-I/MC
MAX2871ETJ+T | MAX2871ETJ+T PLL 23.5MHz to 6000MHz | U301 | 1 | Analog Devices | MAX2871ETJ+T
LMK6CE10000CDLFR | LMK6CE10000CDLFR low jitter 100MHz 3.3V LVCMOS, no load max.: 62mAU302 | | 1 | Texas Instruments | LMK6CE10000CDLFR
RFSW6042TR7 | RF Switch RFSW6042TR7 5-6000MHz SP4T Iso 36dB @925MHz | U303, U304, U501, U502, U503, U504, U505, U506 | 8 | Qorvo | RFSW6042TR7
HMC1119LP4ME | Attenuator HMC1119LP4ME, -2...-32dBm, 0.1-6Ghz | U401 | 1 | Analog Devices | HMC1119LP4METR
TRF37A73IDSGR | Amp TRF37A73IDSGR, +12dB, 0.1-6Ghz | U402 | 1 | Texas Instruments | TRF37A73IDSGR
QPC6324TR13 | RF Switch QPC6324TR13 5-6000MHz SPDT | U403, U404, U405, U601, U602 | 5 | Qorvo | QPC6324TR13
AD8318SCPZ-EP-RL7 | HF-Detector 1MHz to 8GHz | U507 | 1 | Analog Devices | AD8318SCPZ-EP-RL7
ABM8-272-T3 | Crystal ABM8-272-T3 12.0000MHZ 10PF SMD--ABSL2 | Y201 | 1 | Abracon | ABM8-272-T3
