ml3rc/SNA/Altium/SNAPCBVersion-INT/BOM/SNAPCBVersion_SNA-Var_EMS_BOM_Rev.PCBVersion1.0.xlsx

Name | Description | Designator | Footprint | LibRef | Quantity | Manufacturer 1 | Manufacturer Part Number 1 | Supplier 1 | Supplier Part Number 1 | Supplier Unit Price 1 | Remark | Value
4.7u | Capacitor ceramic 4.7u 25V 10% X7R SMD--0805 | C101, C102, C103, C113, C114, C115, C122, C126 | STT--CC--0805 | 200017-1 | 8 | Samsung Electro-Mechanics | CL21B475KAFNNNE | DigiKey | 1276-2969-1-ND | 0.40477 |  | 4.7u
10n | Capacitor ceramic 10n 50V 5% C0G/NPO SMD--0603 | C104 | STT--CC--0603 | CMP-010-000027-1 | 1 | Murata | GRM1885C1H103JA01D | RS | 1449032 |  |  | 10n
100p | Capacitor ceramic 100p 50V 5% C0G AEC-Q200 SMD--0402 | C105, C301, C302, C303, C305, C323, C324, C326, C327, C330, C331, C401, C402, C403, C404, C405, C406, C407, C408, C409, C410, C411, C412, C413, C414, C415, C416, C419, C421, C423, C424, C427, C428, C432, C433, C503, C504, C507, C508, C510, C511, C512, C513, C515, C516, C517, C518, C523, C524, C527, C528, C603, C604, C605, C606, C607, C608 | STT--CC--0402 | CMP-010-000109-1 | 57 | Samsung Electro-Mechanics | CL05C101JB51PND | DigiKey | 1276-CL05C101JB51PNDCT-ND | 0.08472 |  | 100p
10u | Capacitor ceramic 10u 25V 20% X5R SMD--0603 | C106 | STT--CC--0603 | CMP-010-000008-3 | 1 | Murata | GRM188R61E106MA73D | RS | 1449030 |  |  | 10u
22u | Capacitor ceramic 22u 25V 20% X5R SMD--0805 | C107, C108, C109 | STT--CC--0805 | CMP-010-000114-1 | 3 | TAIYO YUDEN | MSAST21GBB5226MTNC12 | DigiKey | 587-MSAST21GBB5226MTNC12CT-ND | 0.58362 |  | 22u
1u | CAP CER 1UF 35V X7R 0603 10% | C110, C111, C112, C116, C117, C118, C119, C120, C121, C123, C124, C125, C312, C313, C316 | STT--CC--0603 | CMP-010-000042-2 | 15 | TDK | C1608X7R1V105K080AC | RS | 2427383 |  |  | 1u
100n | Capacitor ceramic 100n 16V 10% X7R SMD--0402 | C127, C128, C129, C130, C131, C203, C209, C210, C211, C212, C213, C214, C215, C216, C217, C218, C219, C222, C306, C307, C308, C309, C310, C311, C315, C319, C322, C325, C328, C417, C420, C422, C425, C429, C434, C435, C505, C506, C509, C514, C519, C520, C525, C526, C529, C530, C609, C610 | STT--CC--0402 | 200032-3 | 48 | Samsung Electro-Mechanics | CL05B104KO5NNNC | DigiKey | 1276-1001-1-ND | 0.01694 |  | 100n
15p | Capacitor ceramic 15p 50V 1% C0G SMD--0402 | C201, C202 | STT--CC--0402 | CMP-010-000103-1 | 2 | Yageo Group | CQ0402FRNPO9BN150 | DigiKey | 13-CQ0402FRNPO9BN150CT-ND | 0.19768 |  | 15p
10n | Capacitor ceramic 10n 35V 2% C0G SMD--0402 | C204, C531, C532 | STT--CC--0402 | CMP-010-000007-3 | 3 | Murata | GRM1555CYA103GE01D | RS | 2763734 |  |  | 10n
4.7u | Capacitor ceramic 4.7u 6.3V 20% X5R SMD--0402 | C205, C206, C207, C208 | STT--CC--0402 | 200037-1 | 4 | Murata | GRM155R60J475ME47D | RS | 1448528 |  |  | 4.7u
470p | Capacitor ceramic 470p 50V 5% C0G SMD--0402 | C304, C314, C320, C329, C418, C426, C501, C502, C521, C522, C533, C534, C611, C612, C613, C614 | STT--CC--0402 | CMP-010-000105-1 | 16 | TDK | CGA2B2C0G1H471J050BA | DigiKey | 445-5604-1-ND | 0.03859 |  | 470p
180p | Capacitor ceramic 180p 50V 5% C0G SMD--0402 | C317 | STT--CC--0402 | CMP-010-000104-2 | 1 | Samsung Electro-Mechanics | CL05C181JB5NNNC | DigiKey | 1276-1651-1-ND | 0.08472 |  | 180p
3.3n | Capacitor ceramic 3.3n 50V 10% X7R AEC-Q200 SMD--0402 | C318 | STT--CC--0402 | CMP-010-000108-1 | 1 | Samsung Electro-Mechanics | CL05B332KB5VPNC | DigiKey | 1276-6718-1-ND | 0.08472 |  | 3.3n
18p | Capacitor ceramic 18p 50V 5% C0G SMD--0402 | C321 | STT--CC--0402 | 200042-1 | 1 | Samsung Electro-Mechanics | CL05C180JB5NNNC | DigiKey | 1276-1140-1-ND | 0.08472 |  | 18p
SSA24-E3/61T | Schottky Diode SSA24-E3/61T 40V 2A | D101 | STT--SD--SMA-DO-214AC | CMP-039-000054-1 | 1 | Vishay | SSA24-E3/61T | RS | 1777544 |  |  | SSA24-E3/61T
ESD9R3.3S | TVS Diode ESD9R3.3ST5G 3V3 0.5pF, 1nA SMD--SOD-923 | D201, D202, D203, D204, D205 | ONS--SD--SOD-923 | 400052-1 | 5 | onsemi | ESD9R3.3ST5G | RS | 1216448 |  |  | ESD9R3.3S
150060RS75000 | LED 150060RS75000 2V 30mA Red 630nm 250mcd 140° SMD--0603 | D206 | STT--LD--0603-red | 400015-1 | 1 | Wuert Elektronik | 150060RS75000 |  |  |  |  | 150060RS75000
150060GS75000 | LED 150060GS75000 3.2V 30mA Green 515nm 430 mcd 140° SMD--0603 | D207, D208, D209, D210, D211, D212, D213, D214, D215 | STT--LD--0603-green | 400014-1 | 9 | Wuert Elektronik | 150060GS75000 |  |  |  |  | 150060GS75000
SESD0402X1BN-0010-098 | TVS Diode, 7V, 0.1pF | D216, D601, D602, D603, D604 | LF--SD--0402R | CMP-039-000055-1 | 5 | Littelfuse | RF2945-000 | Mouser | 650-SESD0402X1BN0010 | 0.67216 |  | SESD0402X1BN-0010-098
LP0805A3500AWTR | Low Pass Filter 3500MHz 50 Ohms | FL301 | KA--LP0805A | CMP-011-000006-1 | 1 | KYOCERA AVX | LP0805A3500AWTR | Mouser | 581-LP0805A3500AWTR | 1.73 |  | LP0805A3500AWTR
LP0603A1747ANTR | Low Pass Filter 1747MHz 50 Ohms | FL302 | KA--LP0603A | CMP-011-000005-2 | 1 | KYOCERA AVX | LP0603A1747ANTR | DigiKey | 478-2910-2-ND |  |  | LP0603A1747ANTR
LP0603A0947ANTR | Low Pass Filter 947MHz 50 Ohms | FL303 | KA--LP0603A | CMP-011-000007-1 | 1 | KYOCERA AVX | LP0603A0947ANTR | DigiKey | 478-2909-1-ND | 0.86602 |  | LP0603A0947ANTR
SEDC-10-63+ | Directional Coupler, 50 MHz to 6 GHz, 50 Ohms, SMD | FL501 | MC--SEDC-10-63+ | CMP-042-000029-3 | 1 | Mini-Circuits | SEDC-10-63+ | Mouser | 139-SEDC-10-63 | 74.5 |  | SEDC-10-63+
Type C f | Connector USB 2171790001 Type C f MOL--CO--2171790001 | J201 | MOL--CO--2171790001 | CMP-205-000000-4 | 1 | Molex | 217179-0001 | Farnell | 217179-0001 | 0.84719 |  | Type C f
SM03B-SRSS-TB | Connector SM03B-SRSS-TB SMD, 90°, Raspberry JST Debug | J202 | JST--CO--SM03B-SRSS-TB | CMP-023-000161-3 | 1 | JST | SM03B-SRSS-TB(LF)(SN) | Mouser | 306-SM03BSRSSTBLFSNP | 0.36442 |  | SM03B-SRSS-TB
SMA f | Connector Coaxial 142-0701-871 SMA f Edge--142-0701-871 | J601, J603 | STT--CO--142-0701-871 | 600000-2 | 2 | Chinch Connectivity Solutions Johnson | 142-0701-871 |  |  |  |  | SMA f
BNC jack | Connector Coaxial BNC7T-J-P-GN-RA-BM1D BNC jack right angle 75Ohm | J602, J604 | SAM--CO--BNC7T-J-P-GN-RA-BM1D | CMP-023-000176-1 | 2 | Samtec | BNC7T-J-P-GN-RA-BM1D | Mouser | 200-BNC7T-JPGNRABM1D | 8.64 |  | BNC jack
2.2u | Inductor SRP4020FA-2R2M 2.2u 3.1A 21.35mR 38MHz SMD--SRP4020FA | L101, L103, L104 | BOU--LF--SRP4020FA | 300008-1 | 3 | Bourns | SRP4020FA-2R2M | RS | 466262 | 0.96485 |  | 2.2u
470n | Inductor DFE252012F-R47M=P2 470n 7.4A 17mR SMD--2520 | L102 | MUR--FB--DFE252012F | 300013-1 | 1 | Murata | DFE252012F-R47M=P2 | DigiKey | 490-13049-1-ND | 0.2165 |  | 470n
33E | Ferrit Bead MPZ1005S330HT000 33E 3A 22mE SMD--0402 | L105, L106, L107, L108, L109, L110, L111, L201, L202, L205, L301, L302, L303, L304, L305, L306, L401, L402, L404, L405, L406, L407, L501, L502, L503, L504, L505, L506, L507, L508, L601, L602 | STT--FB--0402 | 300015-1 | 32 | TDK Group | MPZ1005S330HT000 |  |  |  |  | 33E
3.3u | Inductor AOTA-B201610S3R3-101-T 3.3u 2.1A 140mOhm | L203 | ABR--LF--0806 | CMP-012-000029-1 | 1 | Abracon | AOTA-B201610S3R3-101-T | DigiKey | 535-AOTA-B201610S3R3-101-TCT-ND | 0.16944 |  | 3.3u
100nH | Inductor 100nH 290mA AEC-Q200 SMD--0603 | L403 | STT--RC--0603 | CMP-012-000031-2 | 1 | Coilcraft | 0603DC-R10XJRW | Farnell | 0603DC-R10XJRW |  |  | 100nH
DMP6050SFG | MOSFET, P-channel, 60 V, -4.8 A | Q201 | DIO--TR--POWERDI3333-8 | CMP-054-000007-3 | 1 | Diodes Inc. | DMP6050SFG-13 | Mouser | 621-DMP6050SFG-13 | 1.17 |  | DMP6050SFG
BSS84AK,215 | MOSFET P-CH 50V 180MA TO236AB | Q202, Q203 | ONS--IC--SOT-23 | CMP-054-000009-3 | 2 | Nexperia | BSS84AK,215 | DigiKey | 1727-1144-1-ND | 0.1412 |  | BSS84AK
249k | Resistor 249k 75V 0.1W 0.1% SMD--0603 | R101 | STT--RC--0603 | CMP-009-000253-1 | 1 | Yageo Group | RT0603BRD07249KL | Mouser | 603-RT0603BRD07249KL | 0.09718 |  | 249k
620E | Resistor 620E 75V 0.1W 0.1% ±25ppm/°C SMD--0603 | R102 | STT--RC--0603 | CMP-009-000254-1 | 1 | Yageo Group | RT0603FRE07620RL | DigiKey | 13-RT0603FRE07620RLCT-ND | 0.08472 |  | 620E
10k | Resistor 10k 75V 0.1W 0.1% 25ppm SMD--0603 | R103, R105 | STT--RC--0603 | 100072-3 | 2 | Susumu | RG1608P-103-B-T5 | Mouser | 754-RG1608P-103-B-T5 | 0.08098 |  | 10k
38.3k | Resistor 38.3k 75V 0.1W 0.1% SMD--0603 | R104 | STT--RC--0603 | CMP-009-000255-1 | 1 | Yageo Group | RT0603BRD0738K3L | RS | 1991516 |  |  | 38.3k
4.7k | Resistor 4.7k 75V 0.1W 1% SMD--0603 | R106 | STT--RC--0603 | 100023-3 | 1 | Yageo Group | RC0603FR-074K7L | RS | 1995593 |  |  | 4.7k
0E | Resistor 0E 75V 0.125W SMD--0603 | R107, R108, R109, R110, R111, R112, R113, R114, R115 | STT--RC--0603 | 100055-3 | 9 | Vishay | MCT06030Z0000ZP500 | RS | 1885956 |  |  | 0E
1k | Resistor 1k 50V 0.063W 1% SMD--0402 | R201, R202, R203, R260, R263, R537, R538 | STT--RC--0402 | 100077-2 | 7 | Panasonic | ERJ2RKF1001X | RS | 287582 |  |  | 1k
10k | Resistor 10k 50V 0.063W 1% SMD--0402 | R204, R206, R228, R261, R264, R301, R302, R303, R304, R312, R313, R315, R316, R317, R318, R319, R320, R401, R402, R403, R404, R405, R406, R407, R408, R409, R410, R411, R412, R413, R501, R502, R503, R504, R505, R506, R507, R508, R511, R512, R513, R514, R517, R518, R521, R522, R525, R526, R527, R528, R531, R532, R533, R534, R536, R601, R602, R603, R604 | STT--RC--0402 | 100086-1 | 59 | Panasonic | ERJ-2RKF1002X | RS | 287583 | 0.00659 |  | 10k
5.1k | Resistor 5.1k 50V 0.063W 1% SMD--0402 | R205, R207, R305 | STT--RC--0402 | CMP-009-000042-2 | 3 | Panasonic | ERJ-2RKF5101X |  |  |  |  | 5.1k
33E | Resistor 33E 50V 0.063W 0.5% SMD--0402 | R208 | STT--RC--0402 | 100061-1 | 1 | Panasonic | ERA-2AKD330X | Mouser | 667-ERA-2AKD330X | 0.08098 |  | 33E
71.5E | Resistor 71.5E 50V 0.0625W 0.1% SMD--0402 | R209, R223, R224, R225, R226, R227, R258, R259, R262, R519, R520 | STT--RC--0402 | CMP-009-000263-1 | 11 | Panasonic | ERA-2AEB71R5X | Mouser | 667-ERA-2AEB71R5X | 0.06641 |  | 71.5E
100E | Resistor 100E 50V 0.063W 0.01 SMD--0402 | R210, R211, R212, R213, R214, R215, R216, R217, R218, R219, R220, R221, R231, R232, R233, R234, R235, R236, R237, R238, R239, R240, R241, R242, R243, R244, R245, R246, R247, R248, R249, R250, R251, R252, R253, R254, R255, R265, R266, R314 | STT--RC--0402 | 100068-1 | 40 | Vishay | CRCW0402100RFKEDC | DigiKey | 541-3962-1-ND | 0.08472 |  | 100E
200E | Resistor 200E 50V 0.063W 1% SMD--0402 | R222 | STT--RC--0402 | 100075-2 | 1 | Panasonic | ERJ-2RKF2000X |  |  |  |  | 200E
4.7k | Resistor 4.7k 50V 0.063W 1% SMD--0402 | R229, R230 | STT--RC--0402 | 100078-1 | 2 | Panasonic | ERJ-2RKF4701X | RS | 277912 |  |  | 4.7k
27E | Resistor 27E 50V 0.063W 1% SMD--0402 | R256, R257 | STT--RC--0402 | 100092-3 | 2 | Vishay | CRCW040227R0FKED | RS | 1819287 |  |  | 27E
49.9E | Resistor 49.9E 50V 0.1W 1% SMD--0402 | R306, R307, R308, R509, R510, R529, R530 | STT--RC--0402 | CMP-009-000262-1 | 7 | Stackpole Electronics | RNCP0402FTD49R9 | Mouser | 708-RNCP0402FTD49R9 | 0.09718 |  | 49.9E
1.8k | Resistor 1.8k 50V 0.063W 1% SMD--0402 | R309 | STT--RC--0402 | CMP-009-000258-1 | 1 | Stackpole Electronics | RMCF0402FT1K80 | Mouser | 708-RMCF0402FT1K80 | 0.08098 |  | 1.8k
82E | Resistor 85E 25V 0.063W 0.5% SMD--0402 | R310 | STT--RC--0402 | CMP-009-000257-1 | 1 | Susumu | RR0510R-820-D | Mouser | 754-RR0510R-820D | 0.08098 |  | 82E
330E | Resistor 330E 50V 0.063W 1% SMD--0402 | R311 | STT--RC--0402 | 100076-2 | 1 | Panasonic | ERJ-2RKF3300X |  |  |  |  | 330E
15.4E | Resistor 15.4E 50V 0.1W 0.1% SMD--0402 | R515, R516, R523, R524 | STT--RC--0402 | CMP-009-000261-1 | 4 | TE Connectivity / AMP | 1-2176309-9 | Mouser | 279-RP73PF1E15R4BTDF | 0.35632 |  | 15.4E
52.3E | Resistor 52.3E 50V 0.1W 0.1% SMD--0402 | R535 | STT--RC--0402 | CMP-009-000265-1 | 1 | TE Connectivity / AMP | 7-2176304-0 | Mouser | 279-RP73PF1E52R3BTD | 0.17006 |  | 52.3E
499E | Resistor 499E 50V 0.063W 1% SMD--0402 | R539 | STT--RC--0402 | 100089-1 | 1 | Yageo Group | RC0402FR-07499RL | DigiKey | 311-499LRCT-ND | 0.08472 |  | 499E
86.6E | Resistor 86.6E 50V 0.1W 0.1% SMD--0402 | R605, R606 | STT--RC--0402 | CMP-009-000267-1 | 2 | TE Connectivity | RP73PF1E86R6BTD | Mouser | 279-RP73PF1E86R6BTD | 0.17006 |  | 86.6E
43.2E | Resistor 43.2E 50V 0.1W 0.1% SMD--0402 | R607, R608 | STT--RC--0402 | CMP-009-000266-1 | 2 | TE Connectivity / AMP | 6-2176304-2 | Mouser | 279-RP73PF1E43R2BTD | 0.17006 |  | 43.2E
PTS845 | Pushbutton PTS845 90° SMD | S201, S202 | CAK--PB--PTS485 | CMP-033-000000-2 | 2 | C&K Components | PTS845VM20PSMTR4 LFS | DigiKey | 108-PTS845VM20PSMTR4LFSCT-ND | 0.50831 |  | PTS845
FSMRA4JH | Pushbutton 1-1825027-1 24V 50mA 90° THT-4pin | S203 | TEC--PB--1-1825027-1 | 700081-1 | 1 | TE Connectivity | 1-1825027-1 | Future Electronics | 1-1825027-1 |  |  | FSMRA4JH
TPS62802YKA | DCDC Buck Converter 1.75-V to 5.5-V input 1-A ultra-low IQ | U101 | TEI--IC--BGA6 | CMP-091-000047-3 | 1 | Texas Instruments | TPS62802YKAT | DigiKey | 296-TPS62802YKATCT-ND | 1.69 |  | TPS62802YKA
MIC2253-06YML | Switching Voltage Regulators 3.5A 1MHz High Efficiency Boost Regulator with OVP & Softstart | U102 | MC--IC--SON50P300X300X90-13N-D | CMP-091-000046-2 | 1 | Microchip | MIC2253-06YML-TR | RS | 333030 |  |  | MIC2253-06YML
LDL212PU50R | LDO 1.2A Low Drop Linear Regulator IC | U103, U104, U105 | STM--IC--DFN-6 | CMP-091-000048-1 | 3 | STMicroelectronics | LDL212PU50R | RS | 1920660 |  |  | LDL212PU50R
AP2114H-3.3TRG1 | LDO 3.3V Fixed 1A Low Noise CMOS LDO Regulator With Enable | U106 | DI--IC--SOT-223-3 | CMP-091-000049-1 | 1 | Diodes Inc. | AP2114H-3.3TRG1 | RS | 1223351 |  |  | AP2114H-3.3TRG1
NCP702SN33T1G | LDO 3.3V Fixed 200 mA | U107, U108, U109 | ON--IC--SOT-23-5 | CMP-091-000050-1 | 3 | onsemi | NCP702SN33T1G | Mouser | 863-NCP702SN33T1G | 0.38062 |  | NCP702SN33T1G
W25Q128JVSIQ TR | NOR-Flash Memory W25Q128JVSIQ TR SPI SMD--SOIC8 | U201 | WIB--IC--SOIC8 | CMP-117-000001-2 | 1 | Winbond | W25Q128JVSIQ TR | DigiKey | 256-W25Q128JVSIQTR-ND |  |  | W25Q128JVSIQ TR
SC1510(13)-A4 | MCU RP2350B 150MHz clock Dual Arm Cortex-M33 cores 520KB RAM 8KB on-chip QFN-80 | U202 | IC--RASPI--QFN-80 | CMP-023-000160-3 | 1 | Raspberry Pi | SC1510(13)-A4 | Mouser | 358-SC151013 | 0.72885 |  | SC1510(13)-A4
24AA32A-I/MC | EEPROM 24AA32AT 32K SMD--DFN | U203 | MIC--IC--QFN50P200X300X100_HS-9N-8 | CMP-117-000000-2 | 1 | Microchip | 24AA32AT-I/MC | Farnell | 24AA32AT-I/MC | 0.72988 |  | 24AA32A
MAX2871ETJ+T | MAX2871ETJ+T PLL 23.5MHz to 6000MHz | U301 | AD-IC-MAX2871ETJ+T | CMP-038-000007-2 | 1 | Analog Devices | MAX2871ETJ+T | Mouser | 700-MAX2871ETJ+T | 14.6 |  | 23.5MHz to 6000MHz
LMK6CE10000CDLFR | LMK6CE10000CDLFR low jitter 100MHz 3.3V LVCMOS, no load max.: 62mA | U302 | TXI-IC-LMK6CE10000CDLFR | CMP-038-000005-2 | 1 | Texas Instruments | LMK6CE10000CDLFR | DigiKey | 296-LMK6CE10000CDLFRCT-ND | 2.69 |  | 100 MHz
RFSW6042TR7 | RF Switch RFSW6042TR7 5-6000MHz SP4T Iso 36dB @925MHz | U303, U304, U501, U502, U503, U504, U505, U506 | QV--IC--QFN-12 | CMP-081-000011-1 | 8 | Qorvo | RFSW6042TR7 | DigiKey | 2312-RFSW6042TR7CT-ND | 1.84 |  | RFSW6042TR7
HMC1119LP4ME | Attenuator HMC1119LP4ME, -2...-32dBm, 0.1-6Ghz | U401 | ADI--IC--LFCSP-24 | CMP-153-000013-1 | 1 | Analog Devices | HMC1119LP4METR | DigiKey | 1127-3659-1-ND | 12.47 |  | HMC1119LP4ME
TRF37A73IDSGR | Amp TRF37A73IDSGR, +12dB, 0.1-6Ghz | U402 | TI--IC--WSON-8 | CMP-153-000014-1 | 1 | Texas Instruments | TRF37A73IDSGR | DigiKey | 296-48786-1-ND | 1.23 |  | TRF37A73IDSGR
QPC6324TR13 | RF Switch QPC6324TR13 5-6000MHz SPDT | U403, U404, U405, U601, U602 | QV--IC--QFN-20 | CMP-081-000012-1 | 5 | Qorvo | QPC6324TR13 | DigiKey | 2312-QPC6324TR13CT-ND | 2.44 |  | QPC6324TR13
AD8318SCPZ-EP-RL7 | HF-Detector 1MHz to 8GHz | U507 | ADI--AD8318SCPZ-EP-RL7 | CMP-042-000030-1 | 1 | Analog Devices | AD8318SCPZ-EP-RL7 | DigiKey | 505-AD8318SCPZ-EP-RL7CT-ND | 22.01 |  | AD8318SCPZ-EP-RL7
ABM8-272-T3 | Crystal ABM8-272-T3 12.0000MHZ 10PF SMD--ABSL2 | Y201 | ABR--CR--ABM8 | CMP-038-000006-1 | 1 | Abracon | ABM8-272-T3 | DigiKey | 535-ABM8-272-T3CT-ND | 0.57421 |  | ABM8-272-T3
