ml3rc/SNA/Altium/SNAPCBVersion-FAB/Gerber_Seperate-RF-Solder-Mask/SNAPCBVersion_SNA-SNA_Gerber_Rev.PCBVersion.GBT_iso.dxf

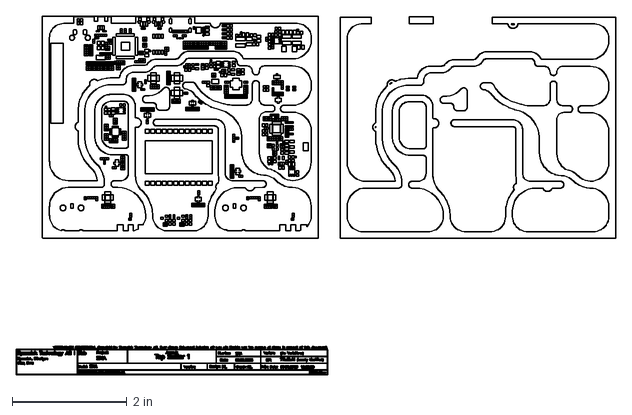
[picture p31: CAD file, 2026-09-03]
Altium/SNAPCBVersion-FAB/Gerber_Seperate-RF-Solder-Mask/SNAPCBVersion_SNA-SNA_Gerber_Rev.PCBVersion.GBT_iso.dxf
10.5 x 6.25 in
