ml3rc/SNA/Fusion360/exp/Laser Print.dxf

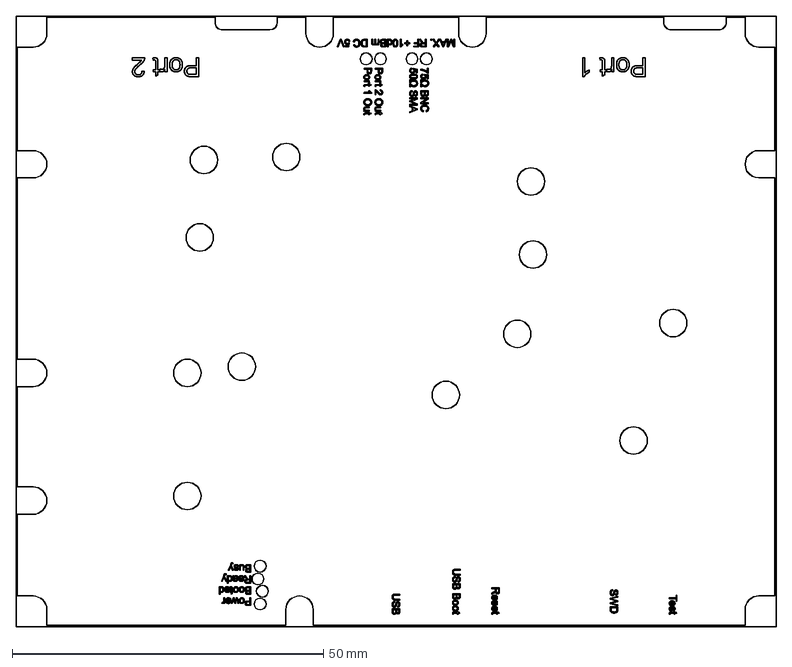
[picture p32: CAD file, 2026-09-05]
Fusion360/exp/Laser Print.dxf
122.0 x 98.0 mm
