ml3rc/SNA/Altium/SNAPCBVersion-FAB/Gerber_Seperate-RF-Solder-Mask/SNAPCBVersion_SNA-SNA_Gerber_Rev.PCBVersion.GBT_Fusion_FINAL_122x98_arcs.dxf

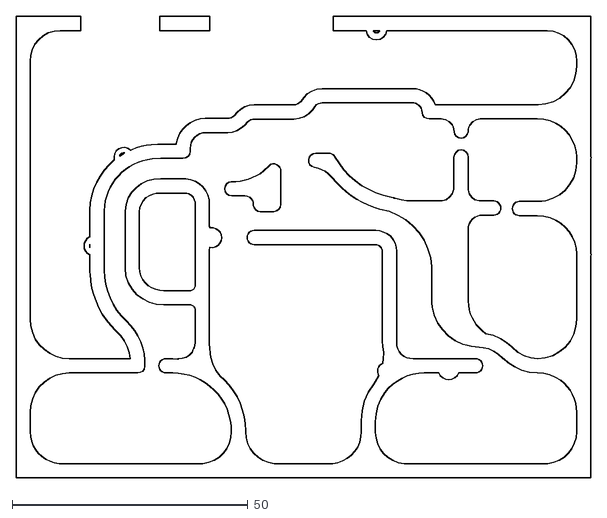
[picture p33: CAD file, 2026-09-03]
Altium/SNAPCBVersion-FAB/Gerber_Seperate-RF-Solder-Mask/SNAPCBVersion_SNA-SNA_Gerber_Rev.PCBVersion.GBT_Fusion_FINAL_122x98_arcs.dxf
122.0 x 98.0
