ml3rc/SNA/Fusion360/exp/SNA_Top.step

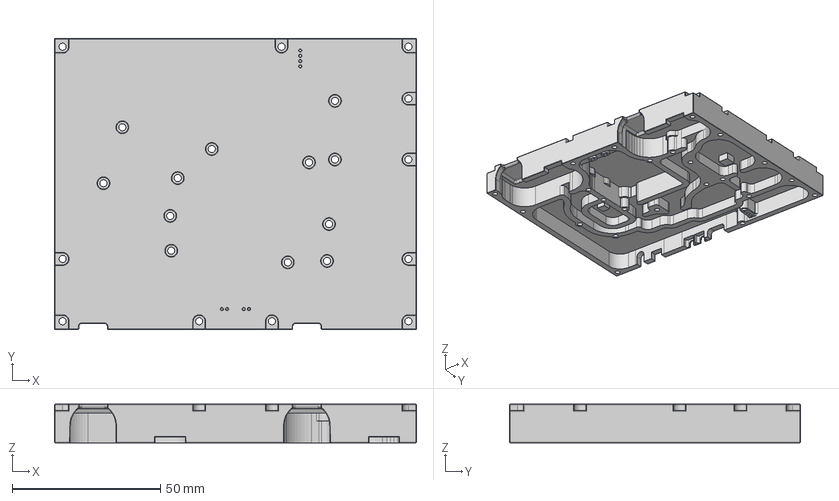
[picture p34: CAD file, 2026-09-04]
Fusion360/exp/SNA_Top.step
122.0 x 98.0 x 13.0 mm
