ml3rc/SNA/Fusion360/exp/SNA_Bottom.step

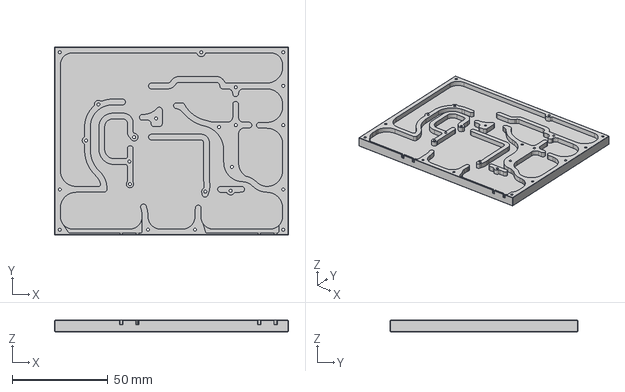
[picture p35: CAD file, 2026-09-04]
Fusion360/exp/SNA_Bottom.step
122.0 x 98.0 x 6.00 mm
