ml3rc/SNA/(list of files, cad)

Other CAD files:
Fusion360/exp/SNA.f3z
