ml3rc/SNA/Measurements/LibreVNA Comparison/LibreVNA LPF 1G.jpeg

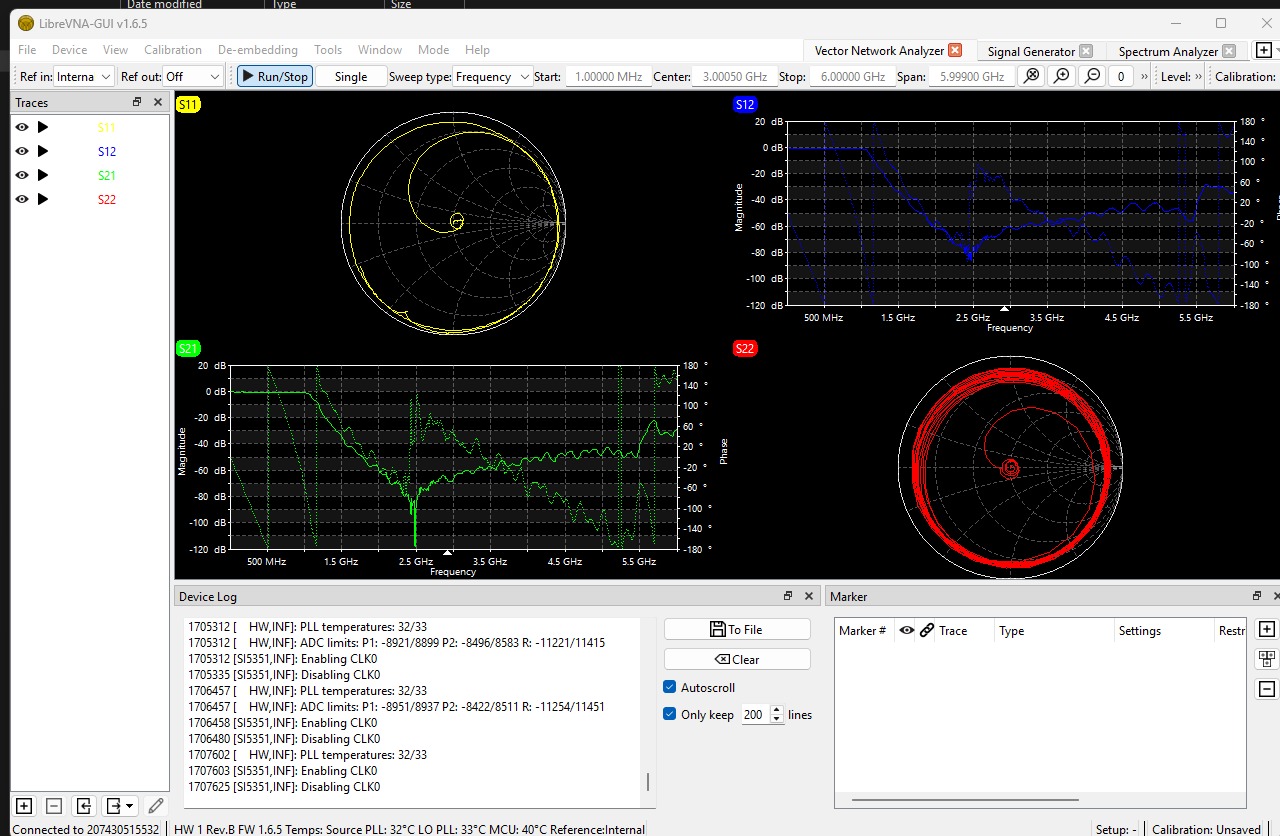
Measurements/LibreVNA Comparison/LibreVNA LPF 1G.jpeg
