ml3rc/SNA/Measurements/LibreVNA Comparison/LibreVNA THRU (NON Reference cable).jpeg

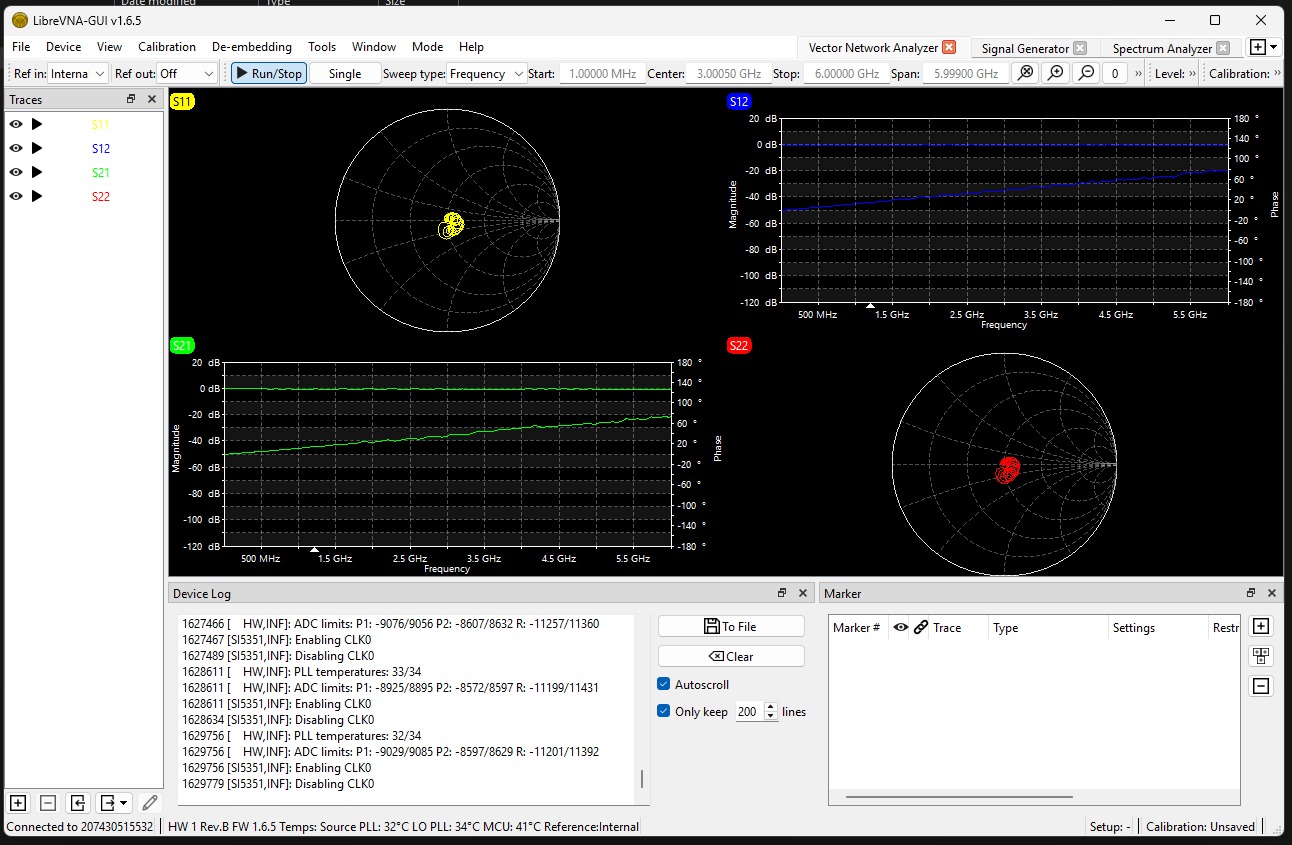
Measurements/LibreVNA Comparison/LibreVNA THRU (NON Reference cable).jpeg
