ml3rc/SNA/Measurements/LibreVNA Comparison/SNA COLD BPF 175-237M.png

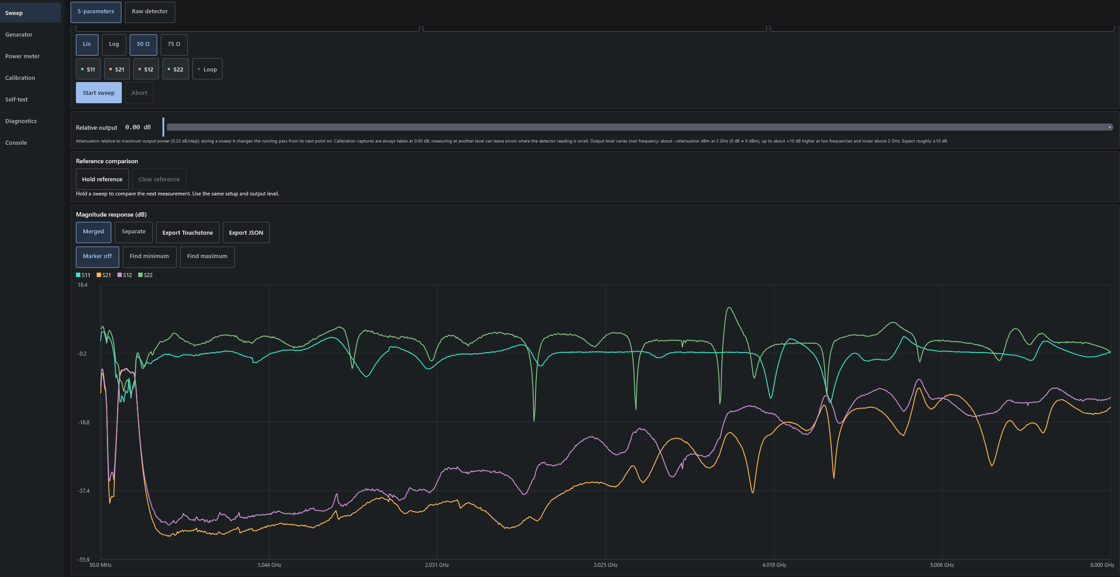
Measurements/LibreVNA Comparison/SNA COLD BPF 175-237M.png
