ml3rc/SNA/Measurements/LibreVNA Comparison/SNA COLD LPF 1G.png

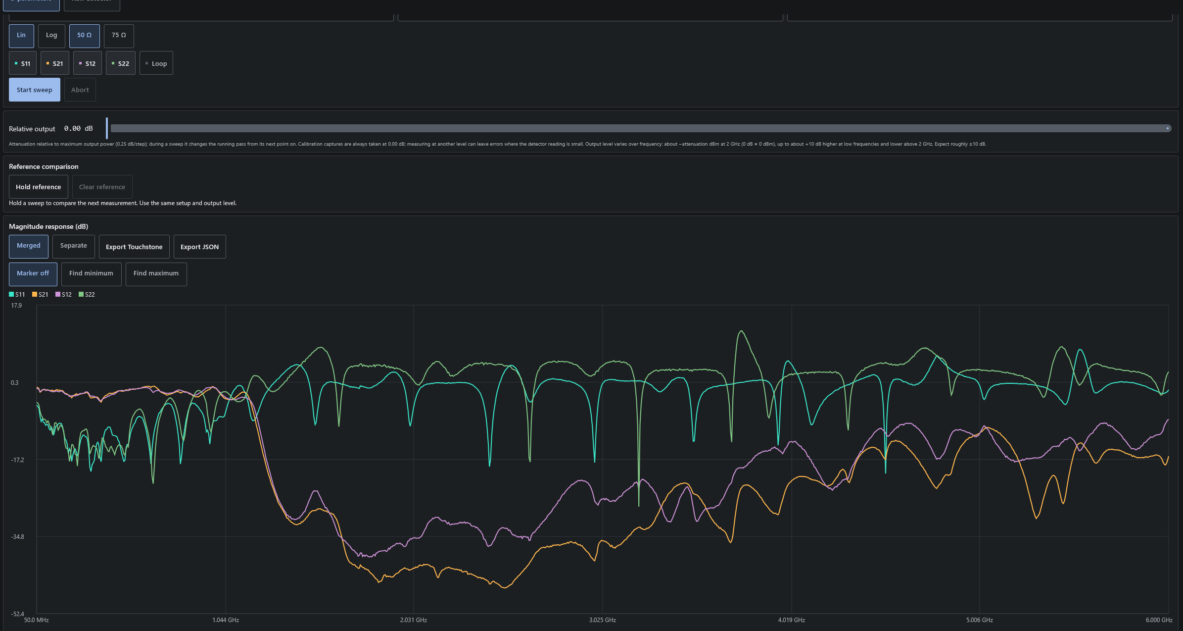
Measurements/LibreVNA Comparison/SNA COLD LPF 1G.png
