ml3rc/SNA/Measurements/LibreVNA Comparison/SNA COLD OPEN.png

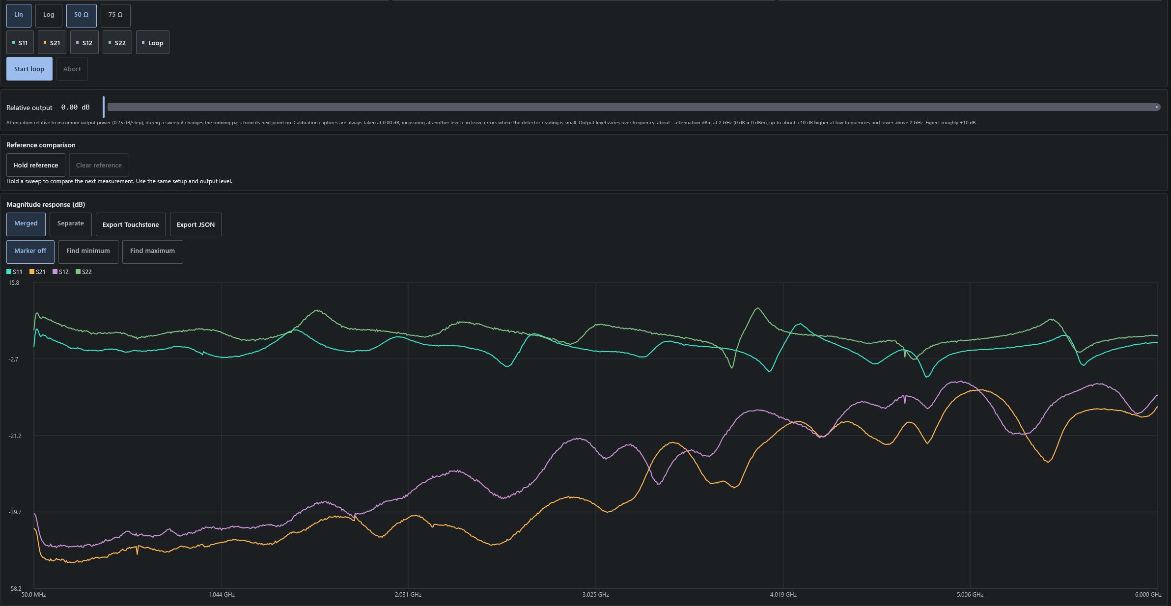
Measurements/LibreVNA Comparison/SNA COLD OPEN.png
