ml3rc/SNA/Measurements/LibreVNA Comparison/SNA COLD THRU (NON Reference cable).png

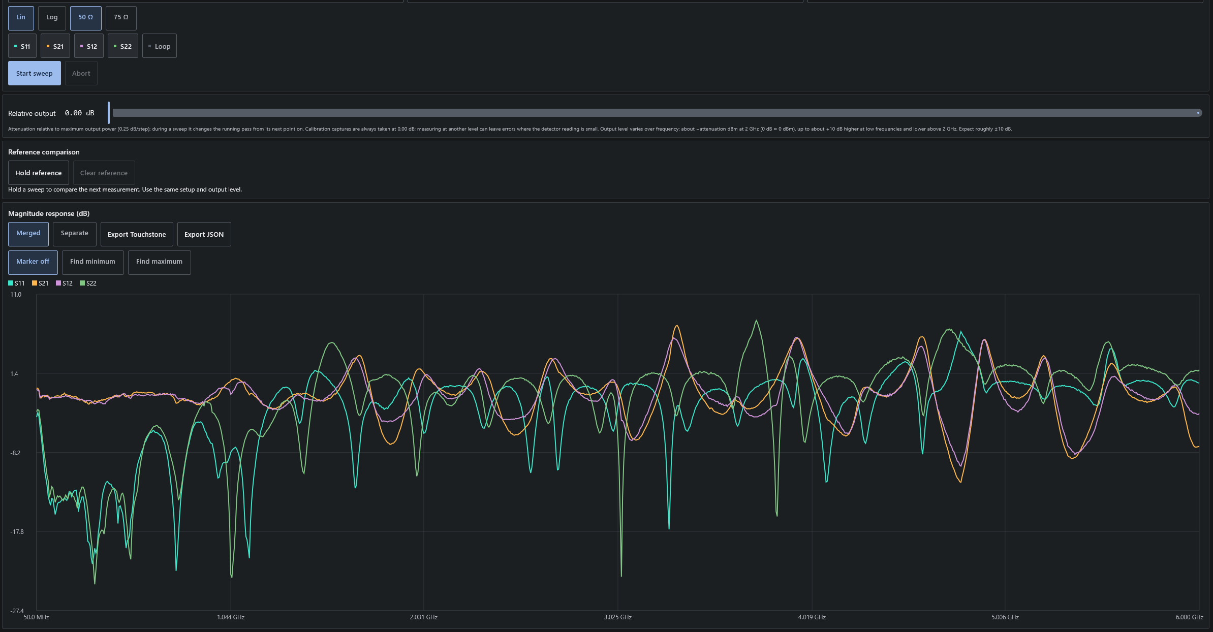
Measurements/LibreVNA Comparison/SNA COLD THRU (NON Reference cable).png
