ml3rc/SNA/Measurements/LibreVNA Comparison/SNA COLD THRU.png

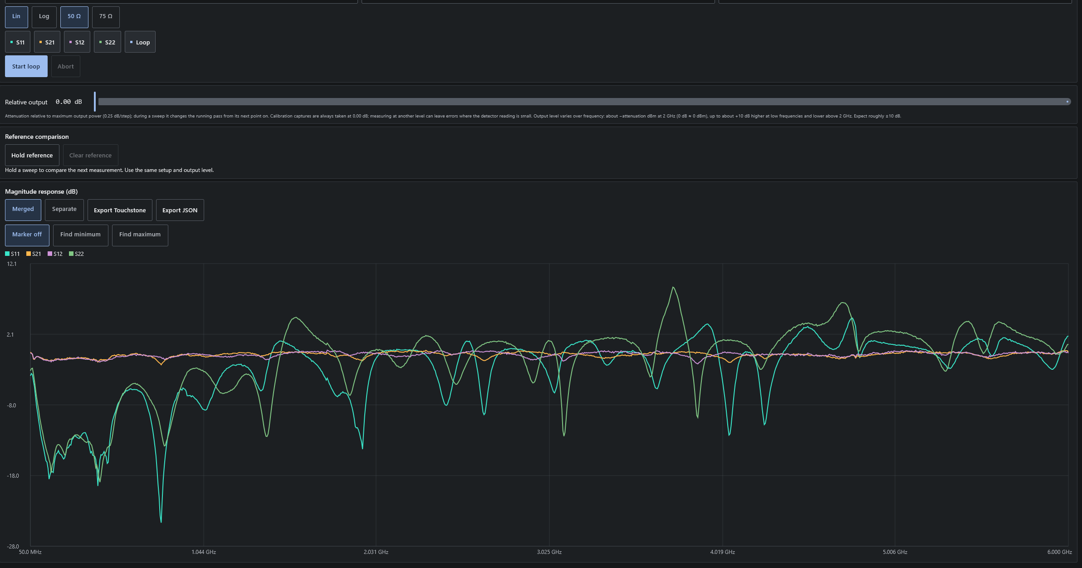
Measurements/LibreVNA Comparison/SNA COLD THRU.png
