ml3rc/SNA/Measurements/LibreVNA Comparison/SNA WARM BPF 175-237M.png

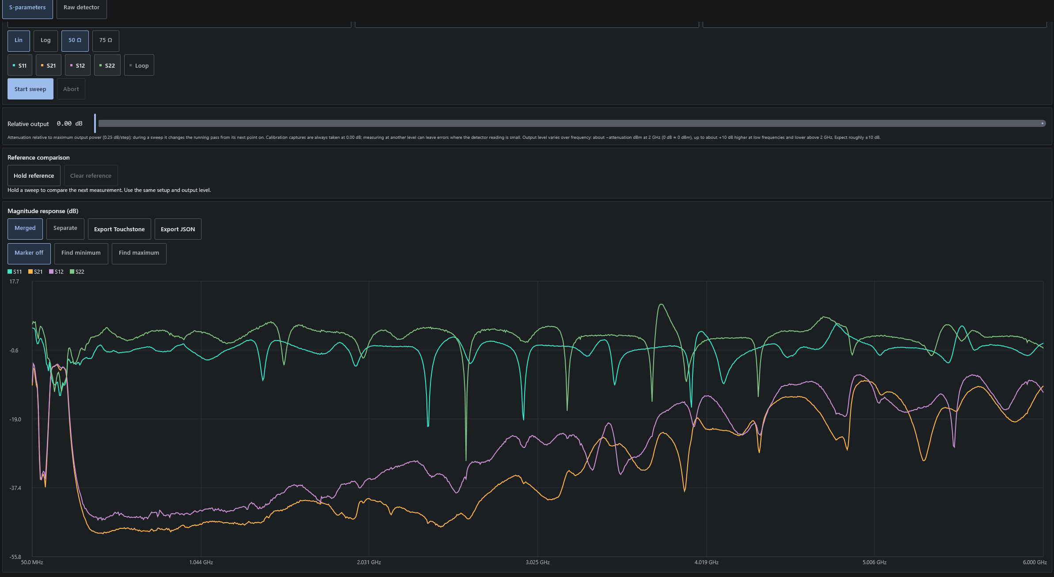
Measurements/LibreVNA Comparison/SNA WARM BPF 175-237M.png
