ml3rc/SNA/Measurements/LibreVNA Comparison/SNA WARM OPEN.png

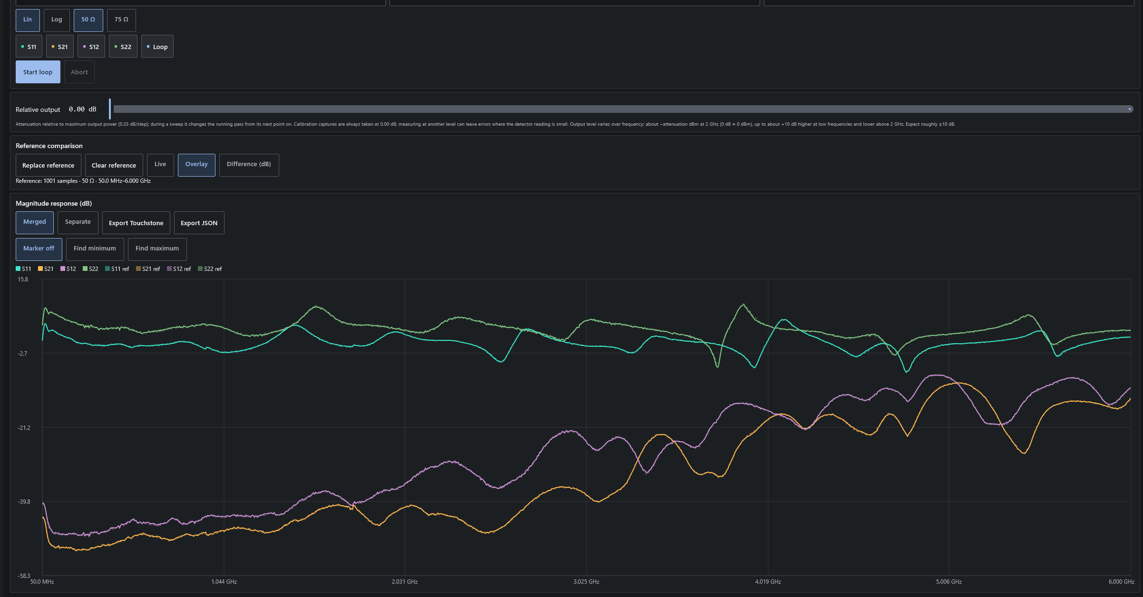
Measurements/LibreVNA Comparison/SNA WARM OPEN.png
