ml3rc/SNA/Measurements/LibreVNA Comperason/LibreVNA BPF 175-237M.jpeg

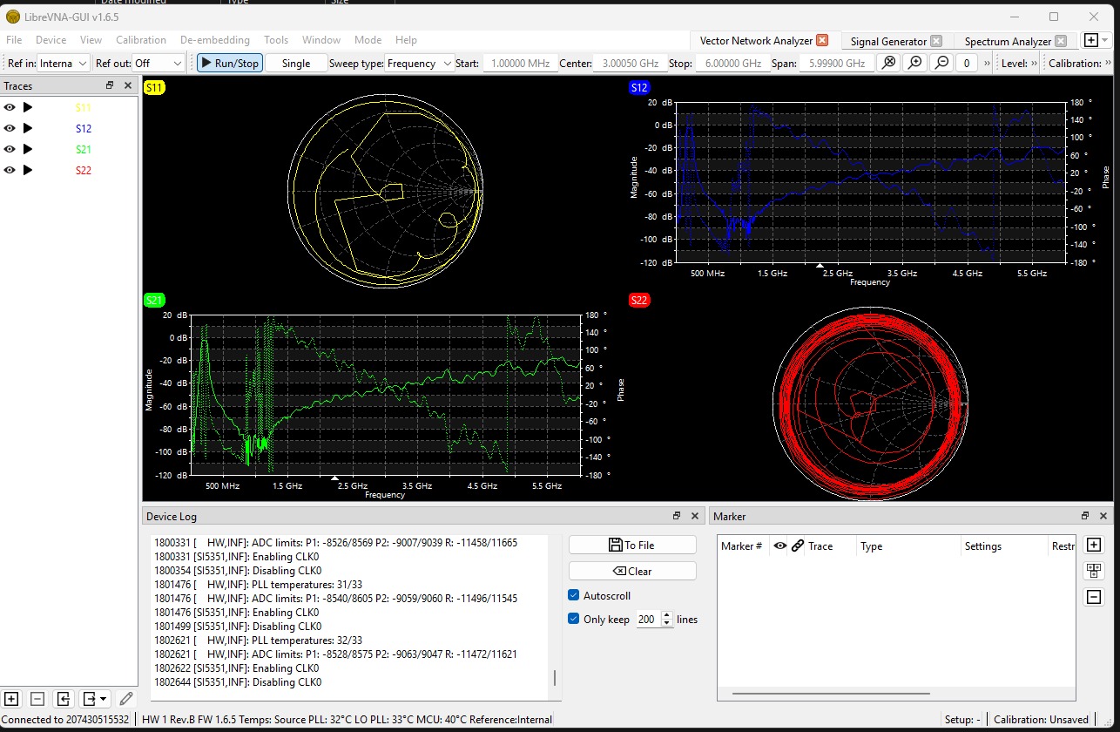
Measurements/LibreVNA Comperason/LibreVNA BPF 175-237M.jpeg
