ml3rc/SNA/Measurements/LibreVNA Comperason/SNA WARM THRU.png

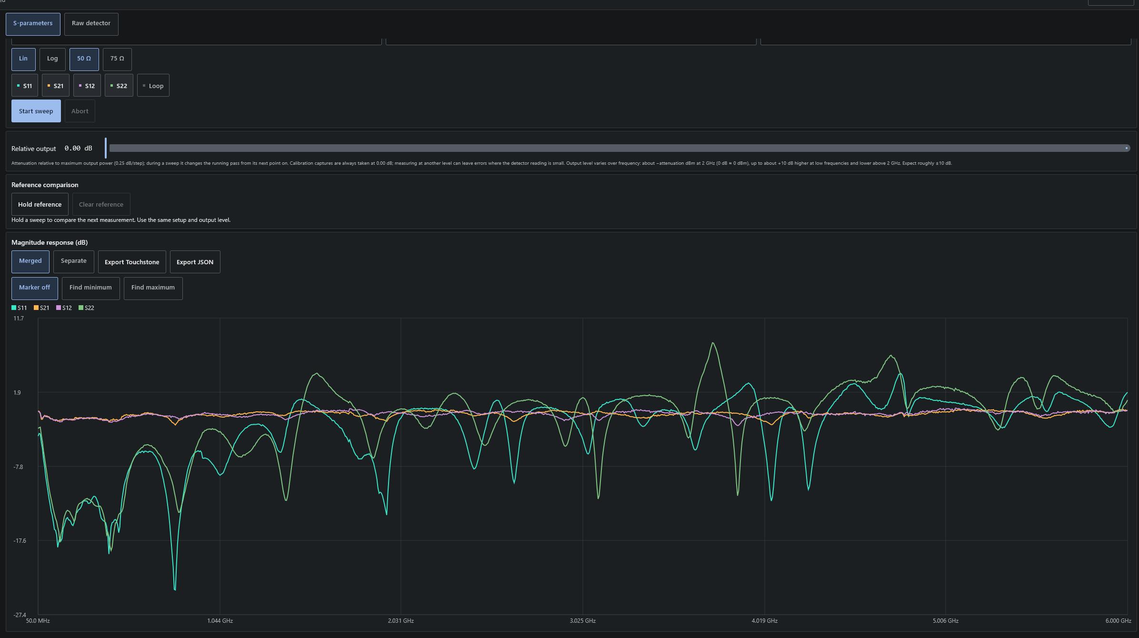
Measurements/LibreVNA Comperason/SNA WARM THRU.png
