ml3rc/SNA/Measurements/Output Signals/PORT1_50M_0dB.jpeg

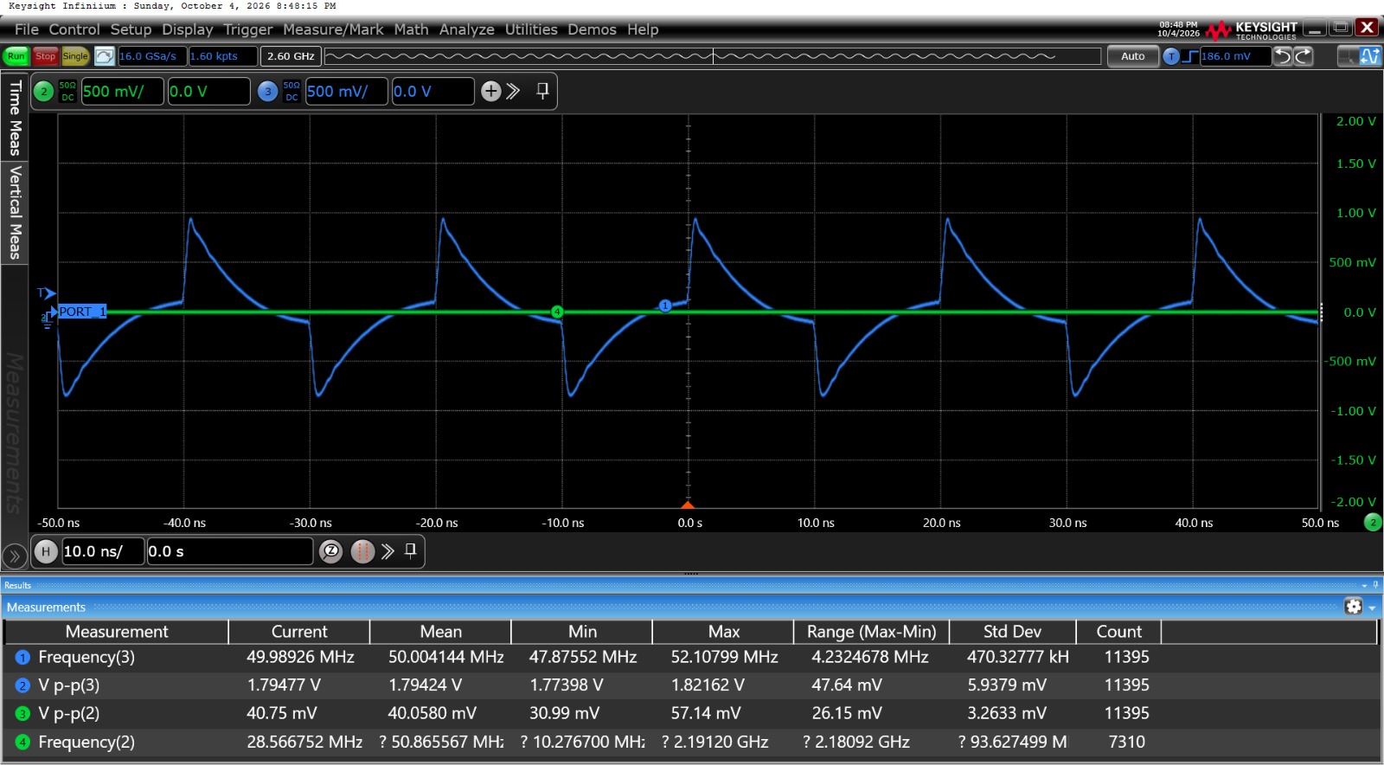
Measurements/Output Signals/PORT1_50M_0dB.jpeg
