ml3rc/SNA/Measurements/Output Signals/PORT1_2000M_0dB.jpeg

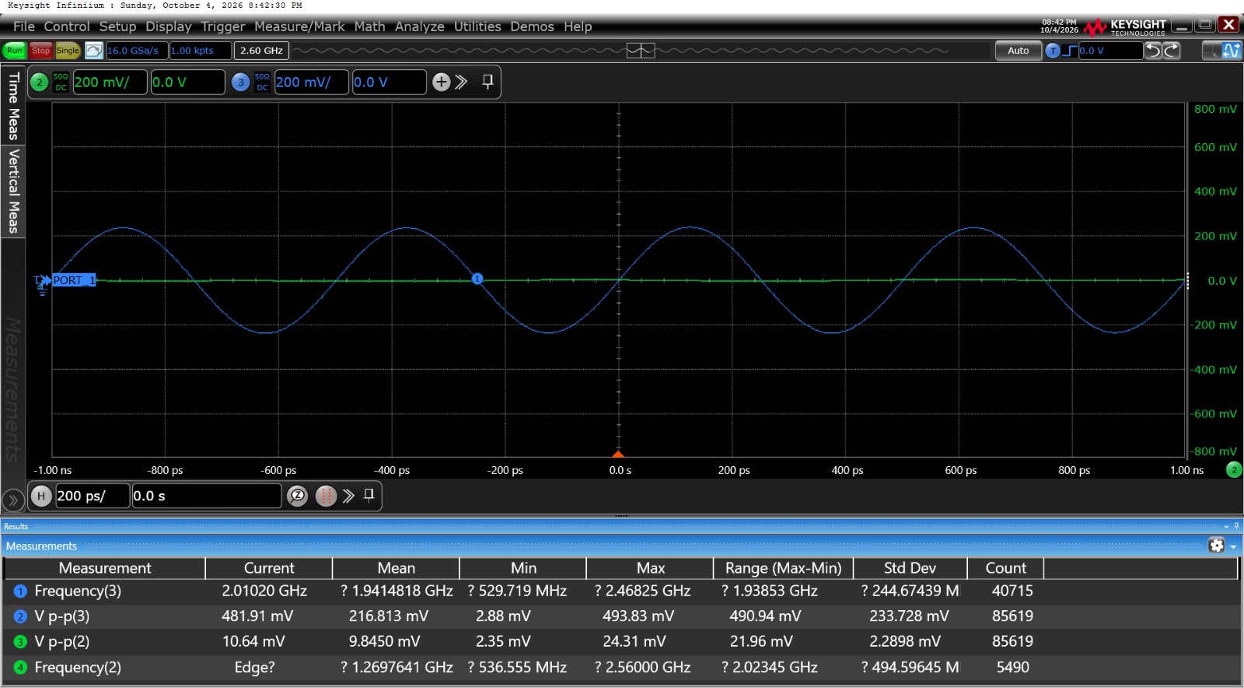
Measurements/Output Signals/PORT1_2000M_0dB.jpeg
