ml3rc/SNA/Measurements/Output Signals/PORT1_2000M_-31-75dB.jpeg

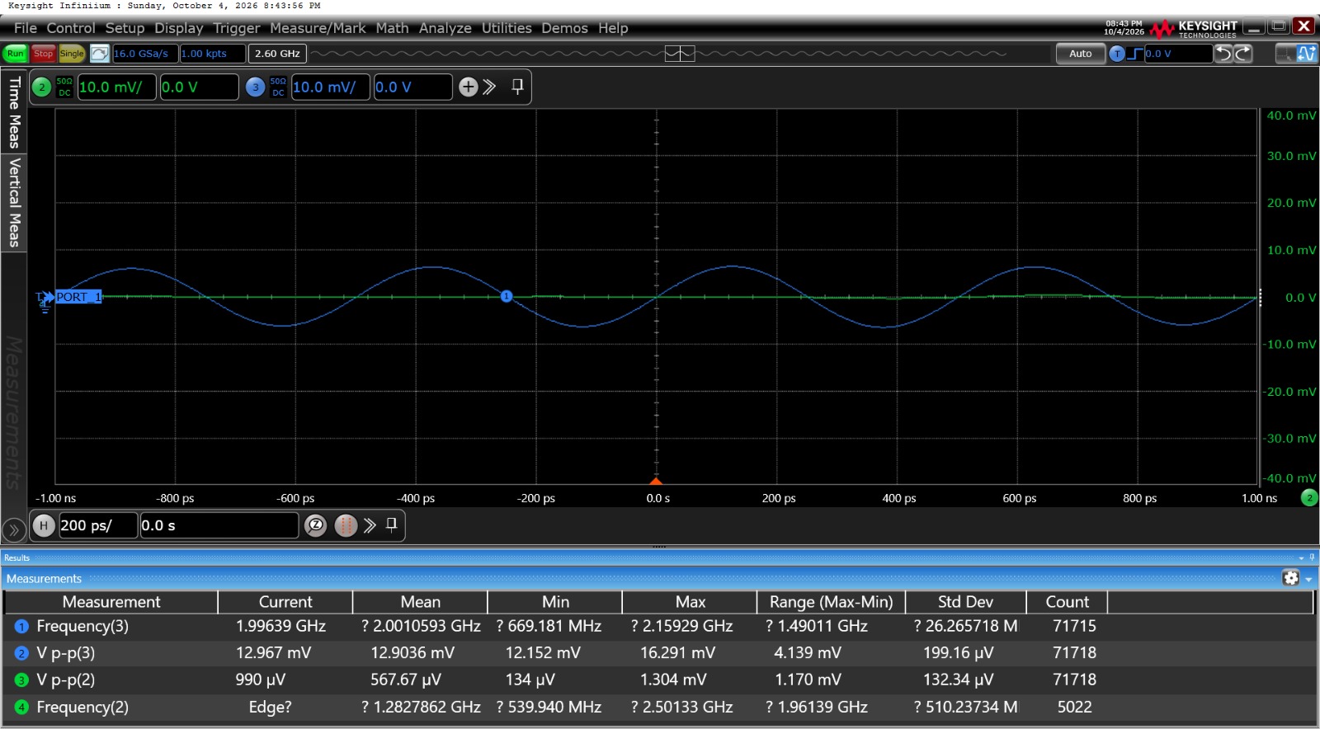
Measurements/Output Signals/PORT1_2000M_-31-75dB.jpeg
