ml3rc/SNA/Measurements/Output Signals/PORT2_500M_0dB.jpeg

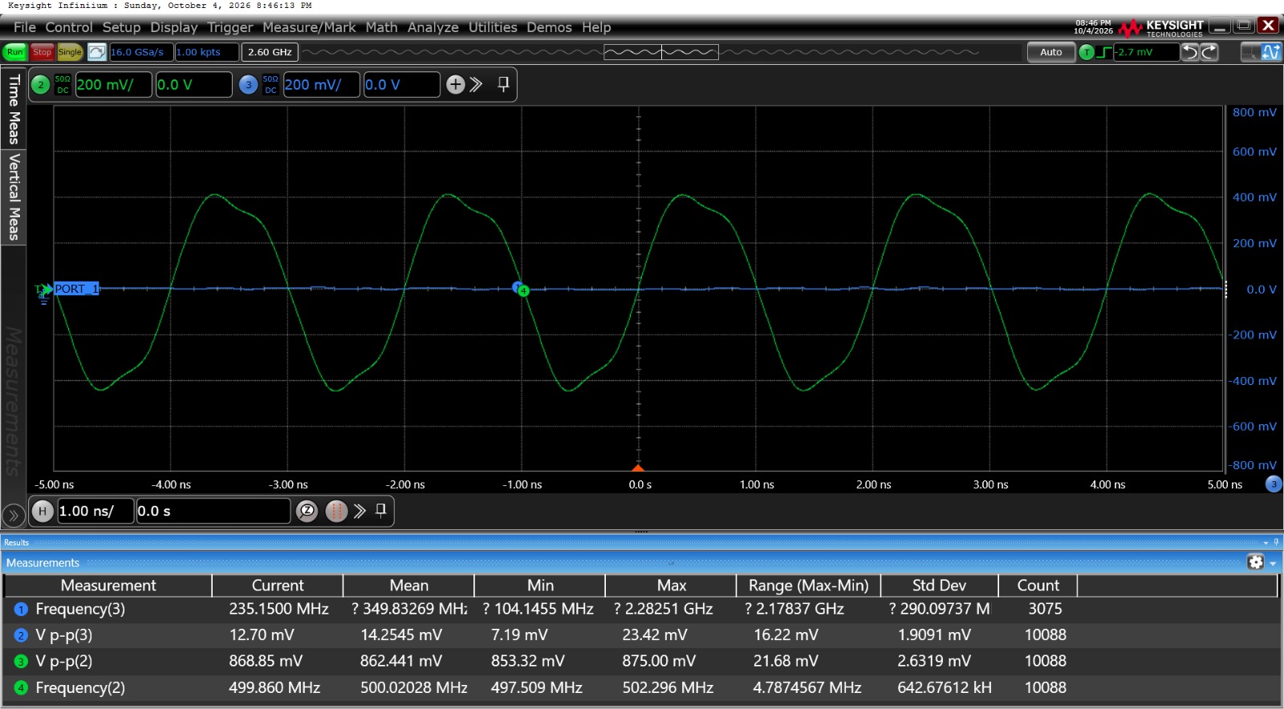
Measurements/Output Signals/PORT2_500M_0dB.jpeg
