ml3rc/SNA/Measurements/Output Signals/PORT2_2000M_0dB.jpeg

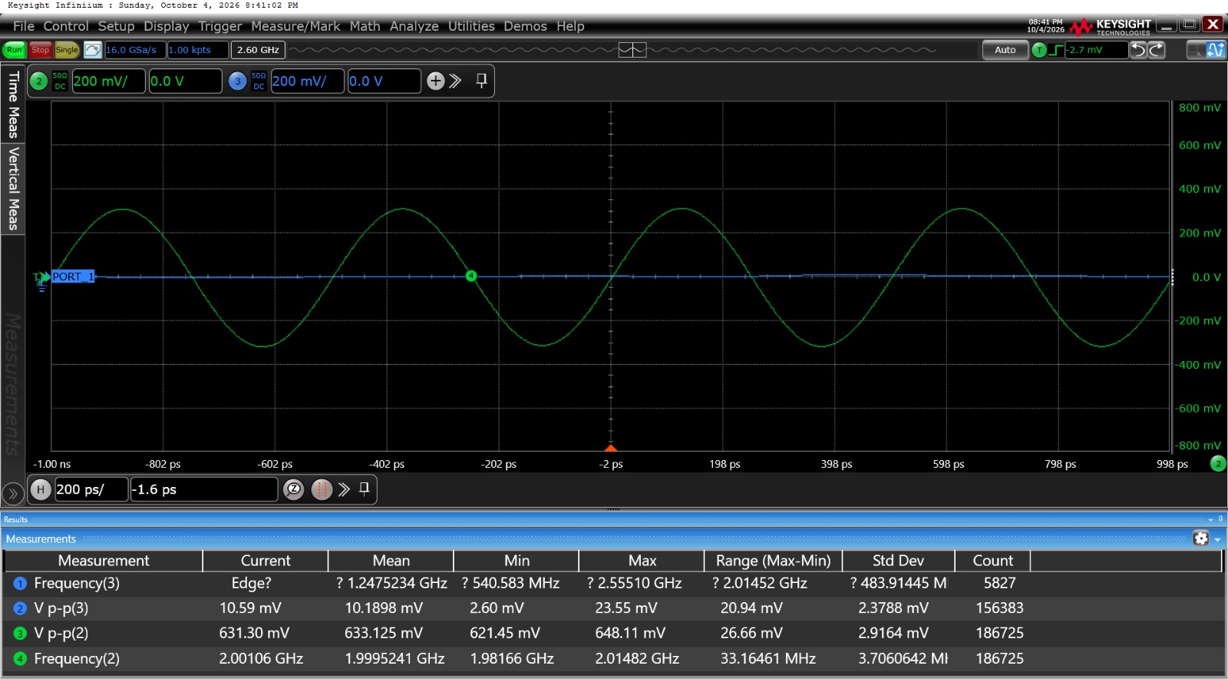
Measurements/Output Signals/PORT2_2000M_0dB.jpeg
