ml3rc/SNA/Measurements/Output Signals/PORT2_2000M_-31-75dB.jpeg

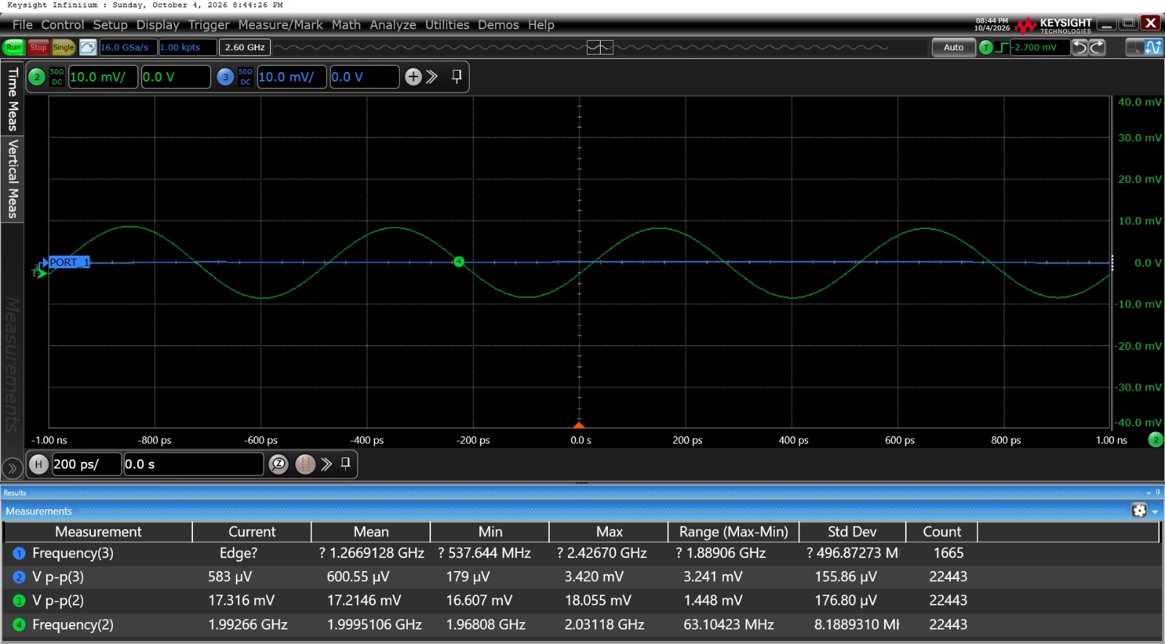
Measurements/Output Signals/PORT2_2000M_-31-75dB.jpeg
