ml3rc/SNA/Altium/SNAPCBVersion-INT/SNAPCBVersion_SNA-Var_EMS_Schematic_Rev.PCBVersion1.0.PDF

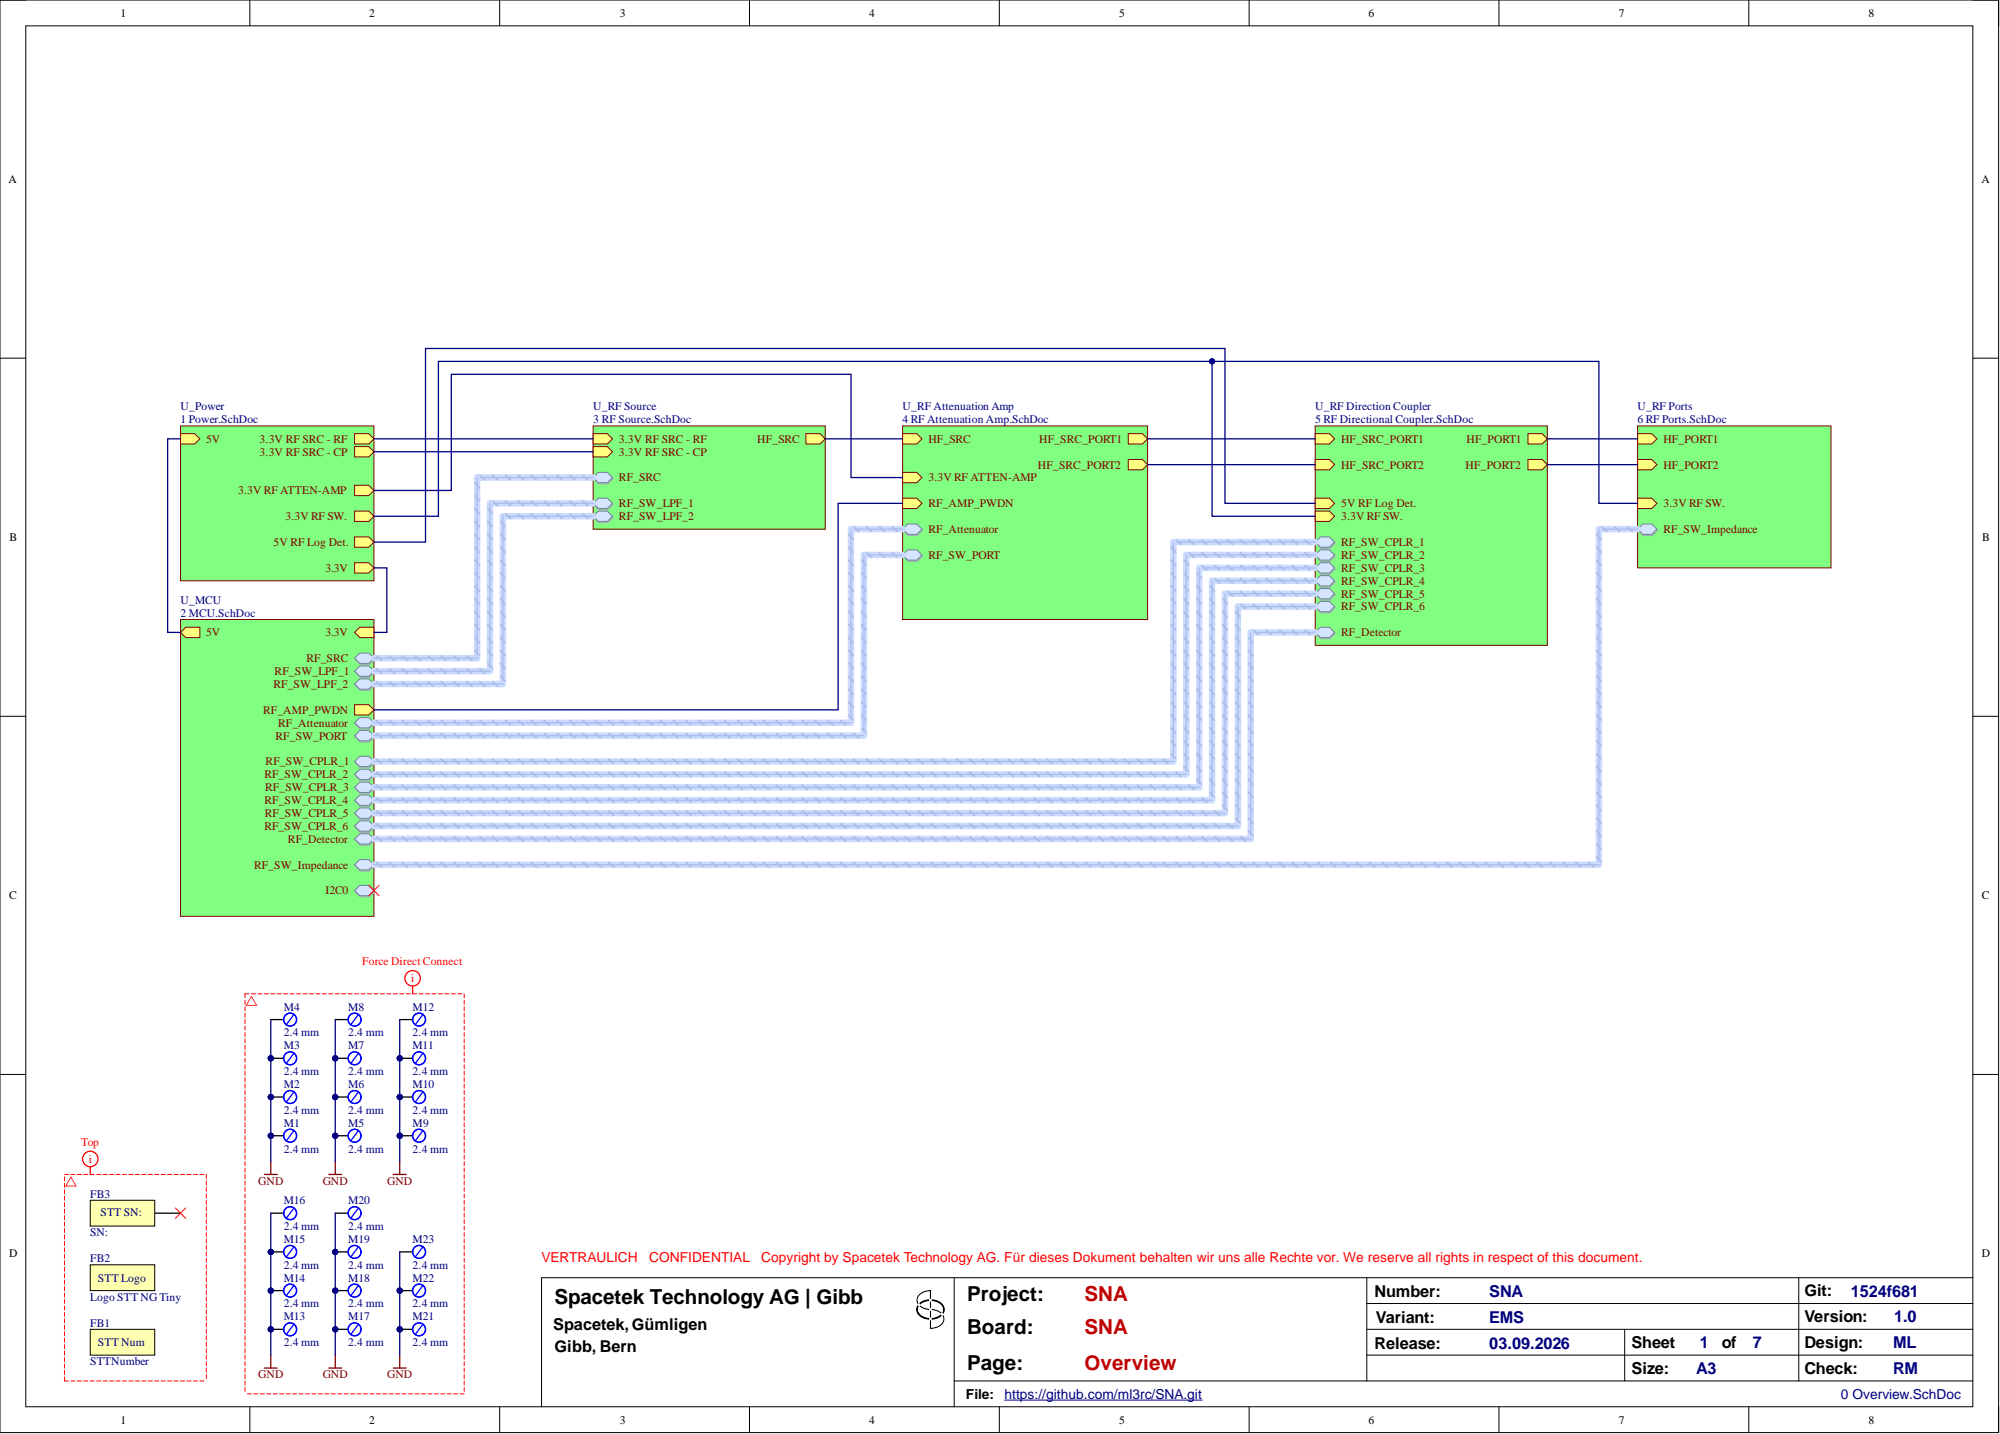
[picture p59: page 1]

U_RF Attenuation Amp
4 RF Attenuation Amp.SchDoc
HF_SRC

U_RF Direction Coupler
5 RF Directional Coupler.SchDoc
HF_SRC_PORT1

STT Logo
Logo STT NG Tiny

VERTRAULICH CONFIDENTIAL Copyright by Spacetek Technology AG. Für dieses Dokument behalten wir uns alle Rechte vor. We reserve all rights in respect of this document.

Spacetek Technology AG | Gibb
Spacetek, Gümligen

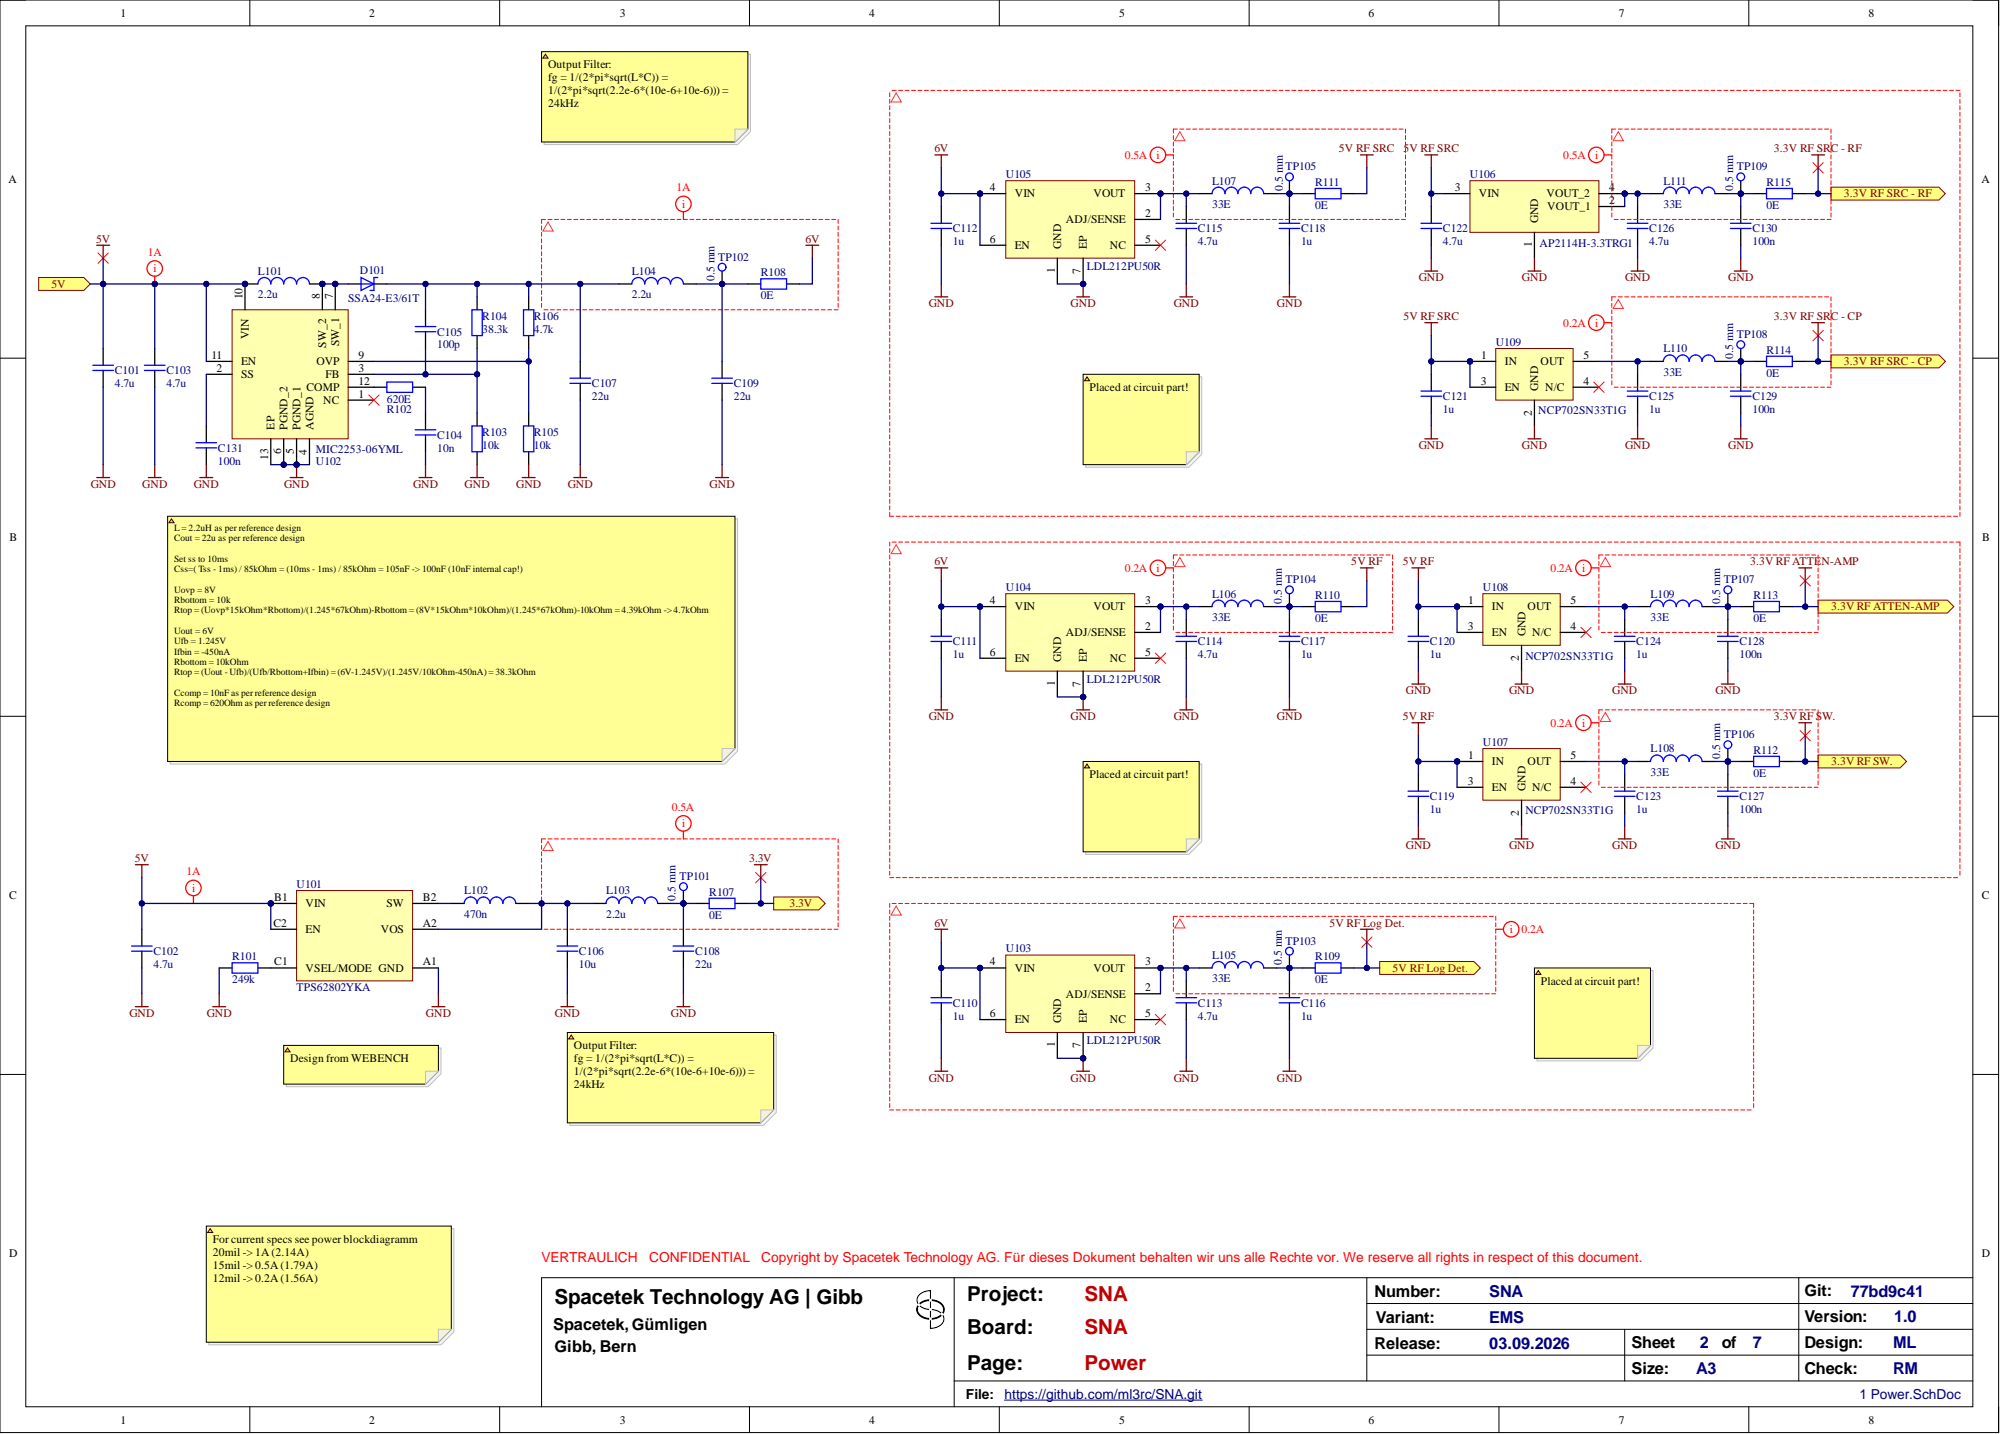
[picture p60: page 2]

5V RF SRC

EN 11 | FB
SS 2 | 3

Placed at circuit part!

L = 2.2uH as per reference design
Cout = 22u as per reference design

Set ss to 10ms
Css=( Tss - 1ms) / 85kOhm = (10ms - 1ms) / 85kOhm = 105nF -> 100nF (10nF internal cap!)

Uovp = 8V
Rbottom = 10k
Rtop = (Uovp*15kOhm*Rbottom)/(1.245*67kOhm)-Rbottom = (8V*15kOhm*10kOhm)/(1.245*67kOhm)-10kOhm = 4.39kOhm -> 4.7kOhm

Uout = 6V
Ufb = 1.245V
Ifbin = -450nA
Rbottom = 10kOhm
Rtop = (Uout - Ufb)/(Ufb/Rbottom+Ifbin) = (6V-1.245V)/(1.245V/10kOhm-450nA) = 38.3kOhm

Ccomp = 10nF as per reference design
Rcomp = 620Ohm as per reference design

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

Spacetek Technology AG | Gibb

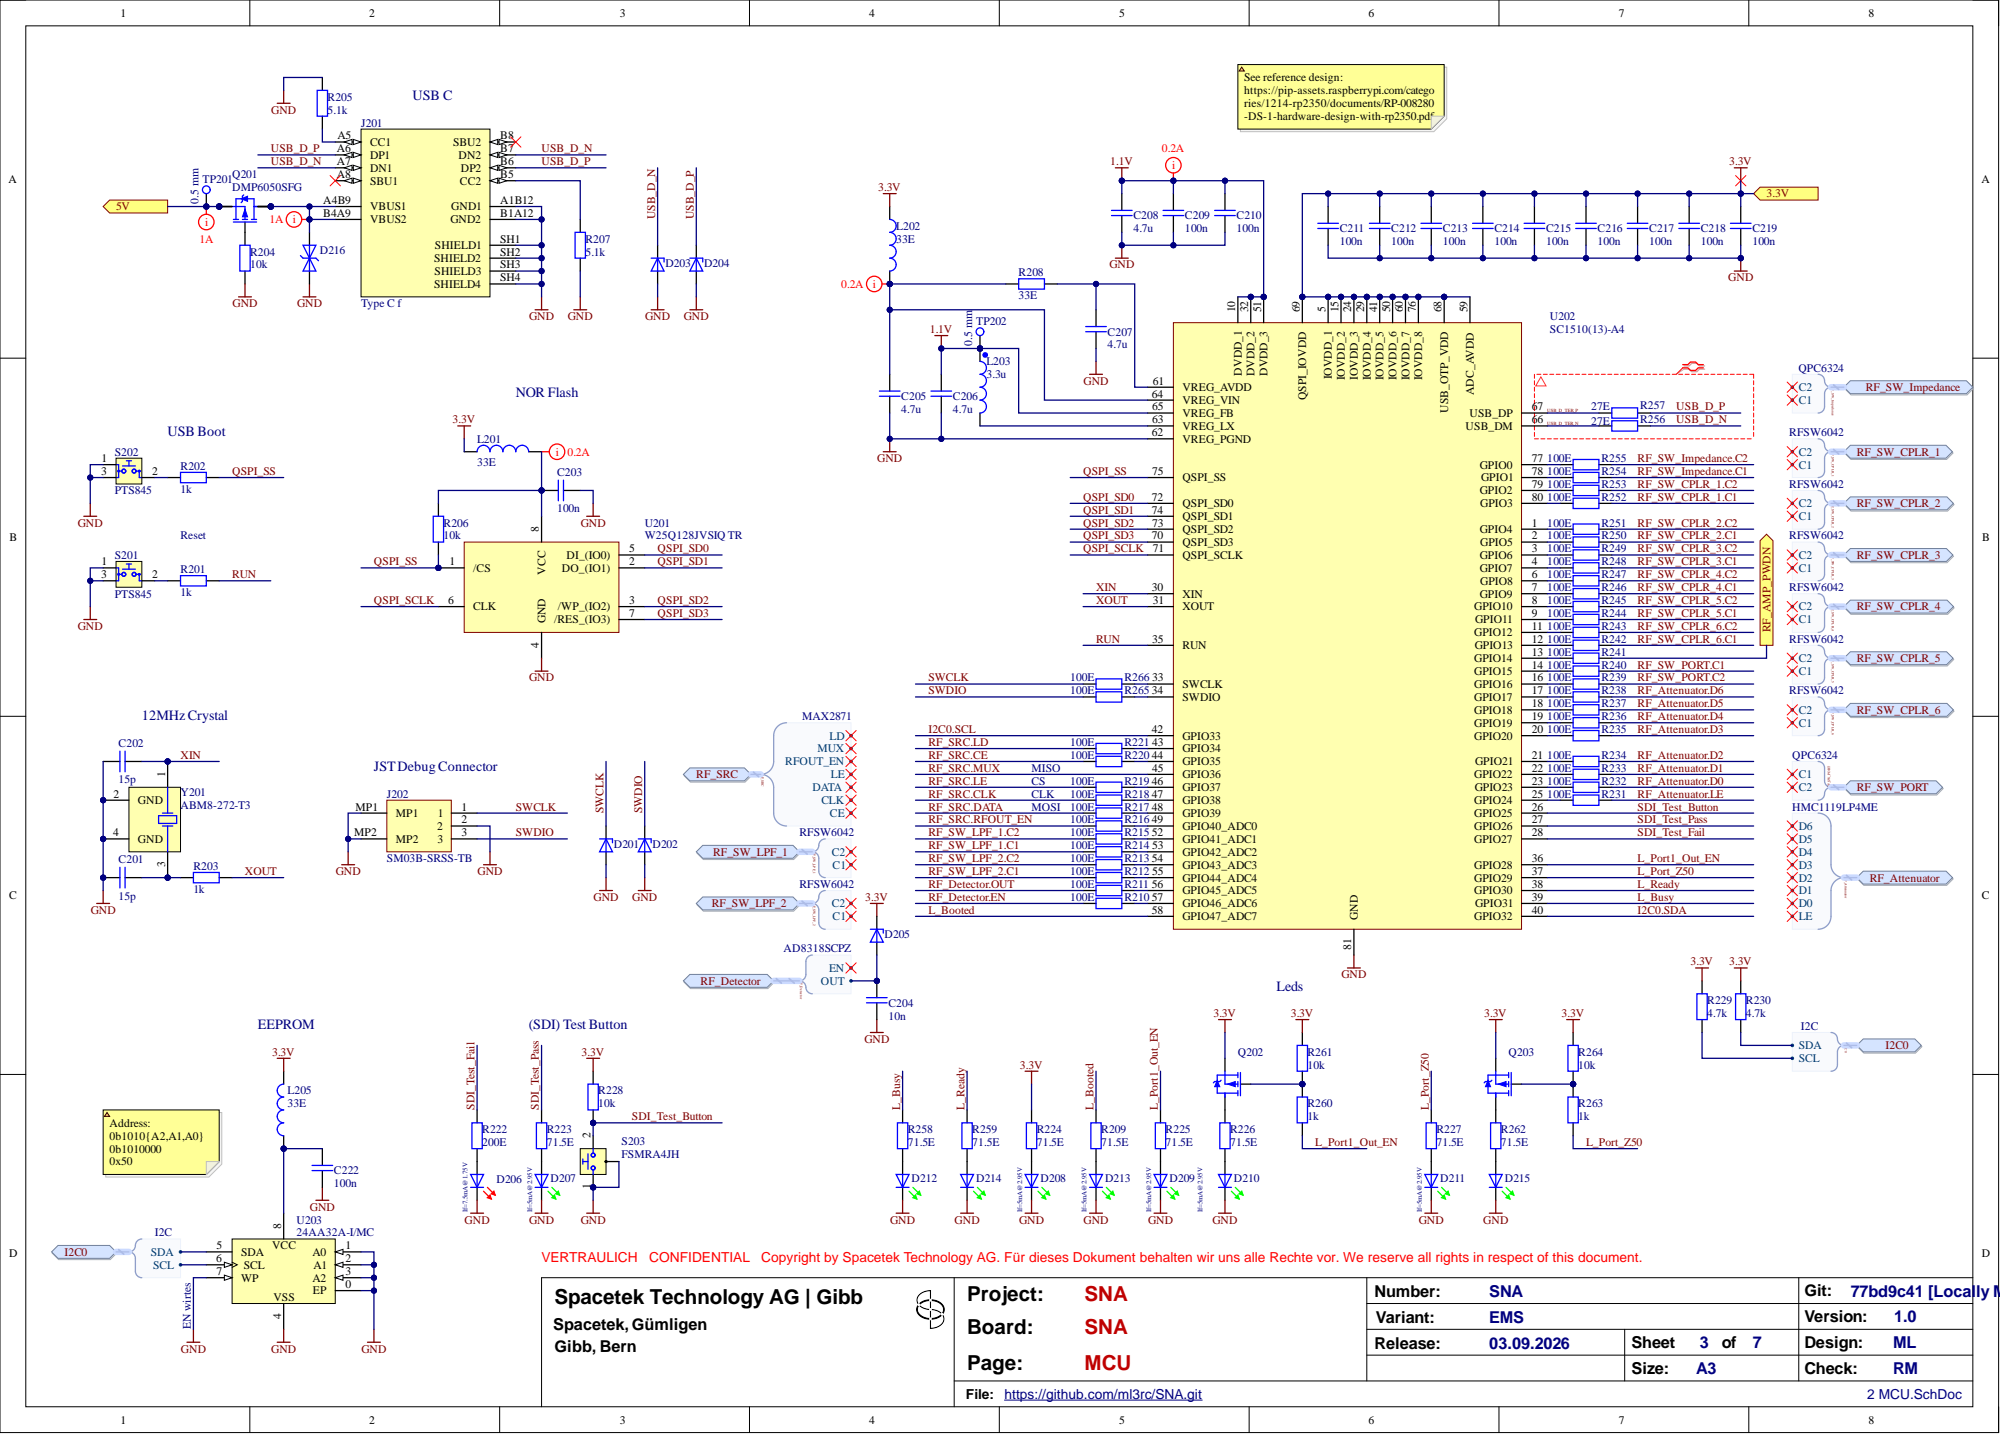
[picture p61: page 3]

See reference design:
https://pip-assets.raspberrypi.com/catego
ries/1214-rp2350/documents/RP-008280
-DS-1-hardware-design-with-rp2350.pdf

VREG_LX 63 | USB_D_TER_N

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

Spacetek Technology AG | Gibb

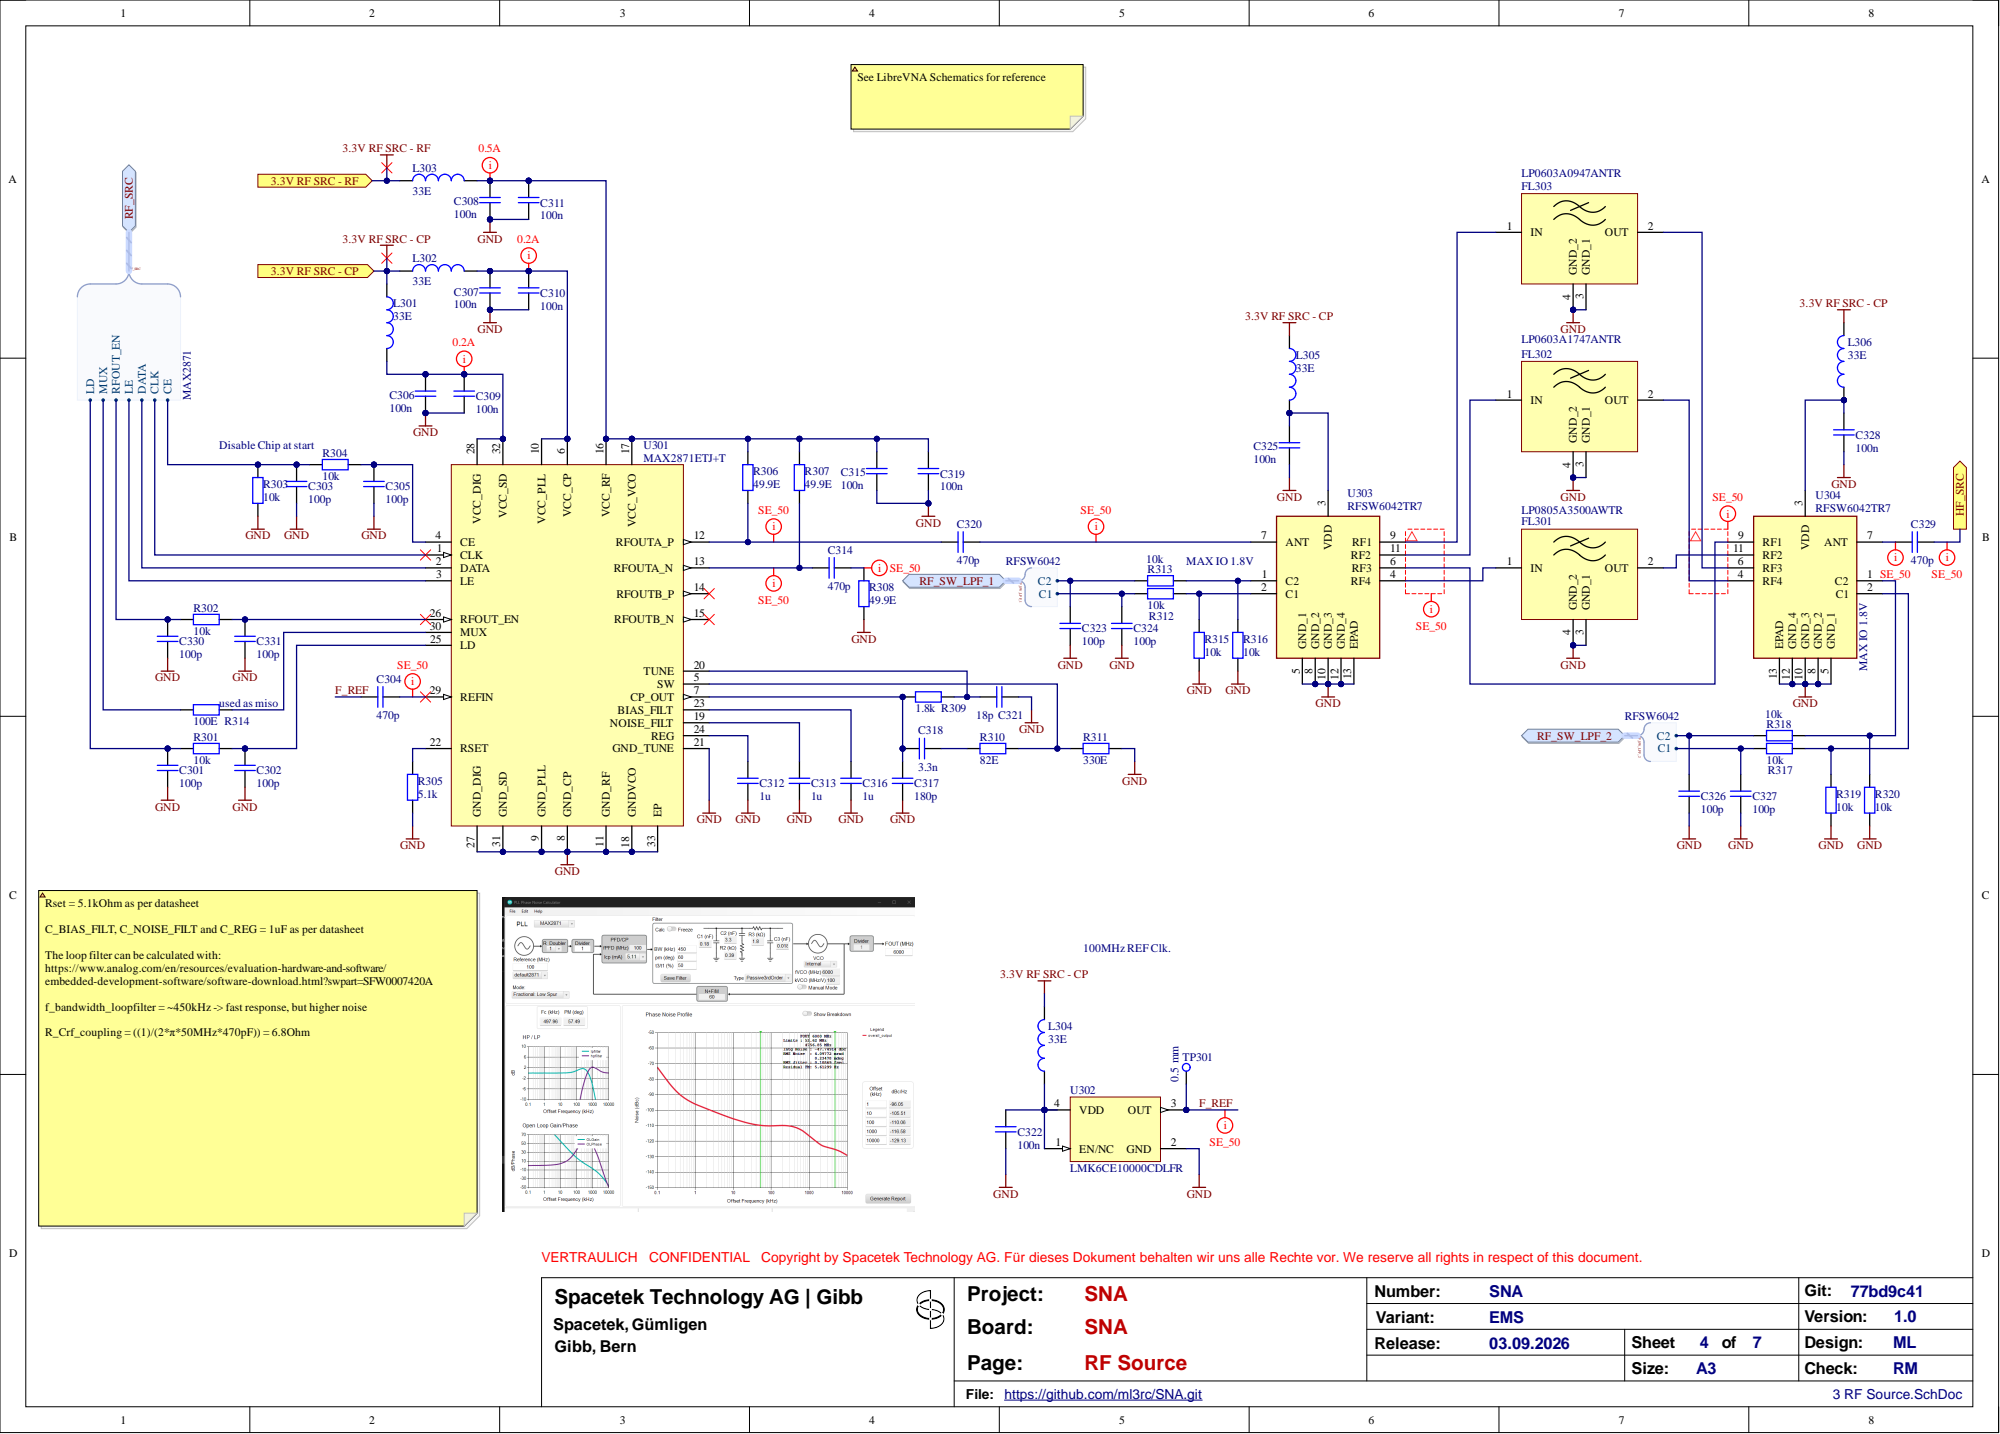
[picture p62: page 4]

See LibreVNA Schematics for reference

Disable Chip at start

U301 MAX2871ETJ+T

MUX 30
LD 25

Rset = 5.1kOhm as per datasheet

C_BIAS_FILT, C_NOISE_FILT and C_REG = 1uF as per datasheet

The loop filter can be calculated with:
https://www.analog.com/en/resources/evaluation-hardware-and-software/
embedded-development-software/software-download.html?swpart=SFW0007420A

f_bandwidth_loopfilter = ~450kHz -> fast response, but higher noise

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

Spacetek Technology AG | Gibb

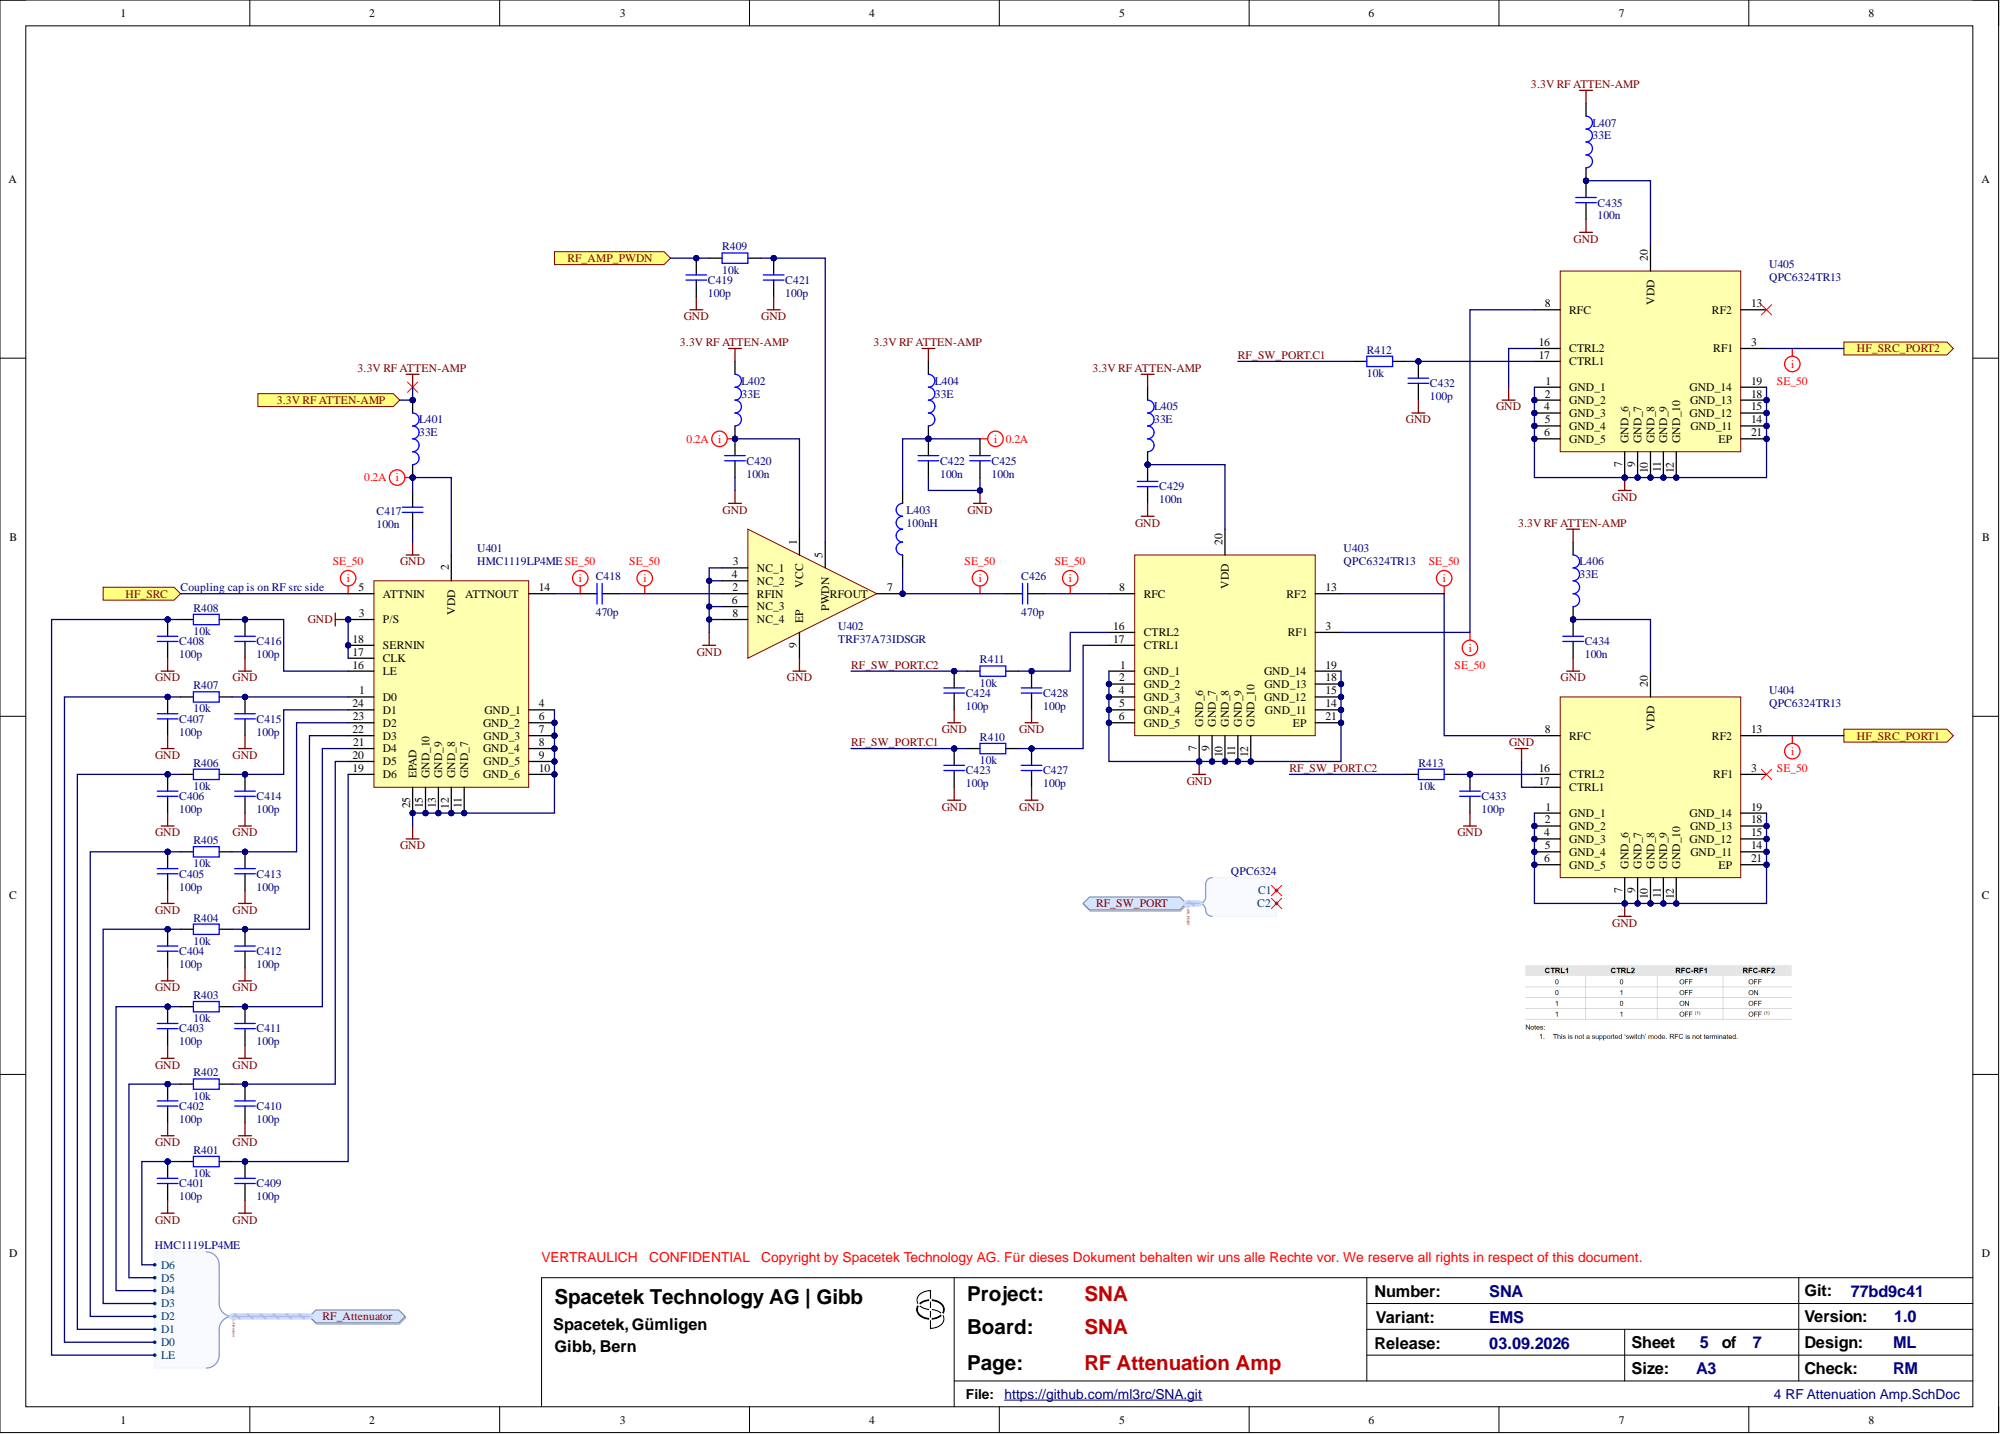
[picture p63: page 5]

CTRL1 17 CTRL2 16

GND U403 SE_50 i | | GND_1 1

GND | 10k C405 100p GND R404 | C413 100p

GND | 100p GND | C412 100p

GND | 100p GND | C411 100p

GND | 100p GND | C410 100p

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

Spacetek Technology AG | Gibb

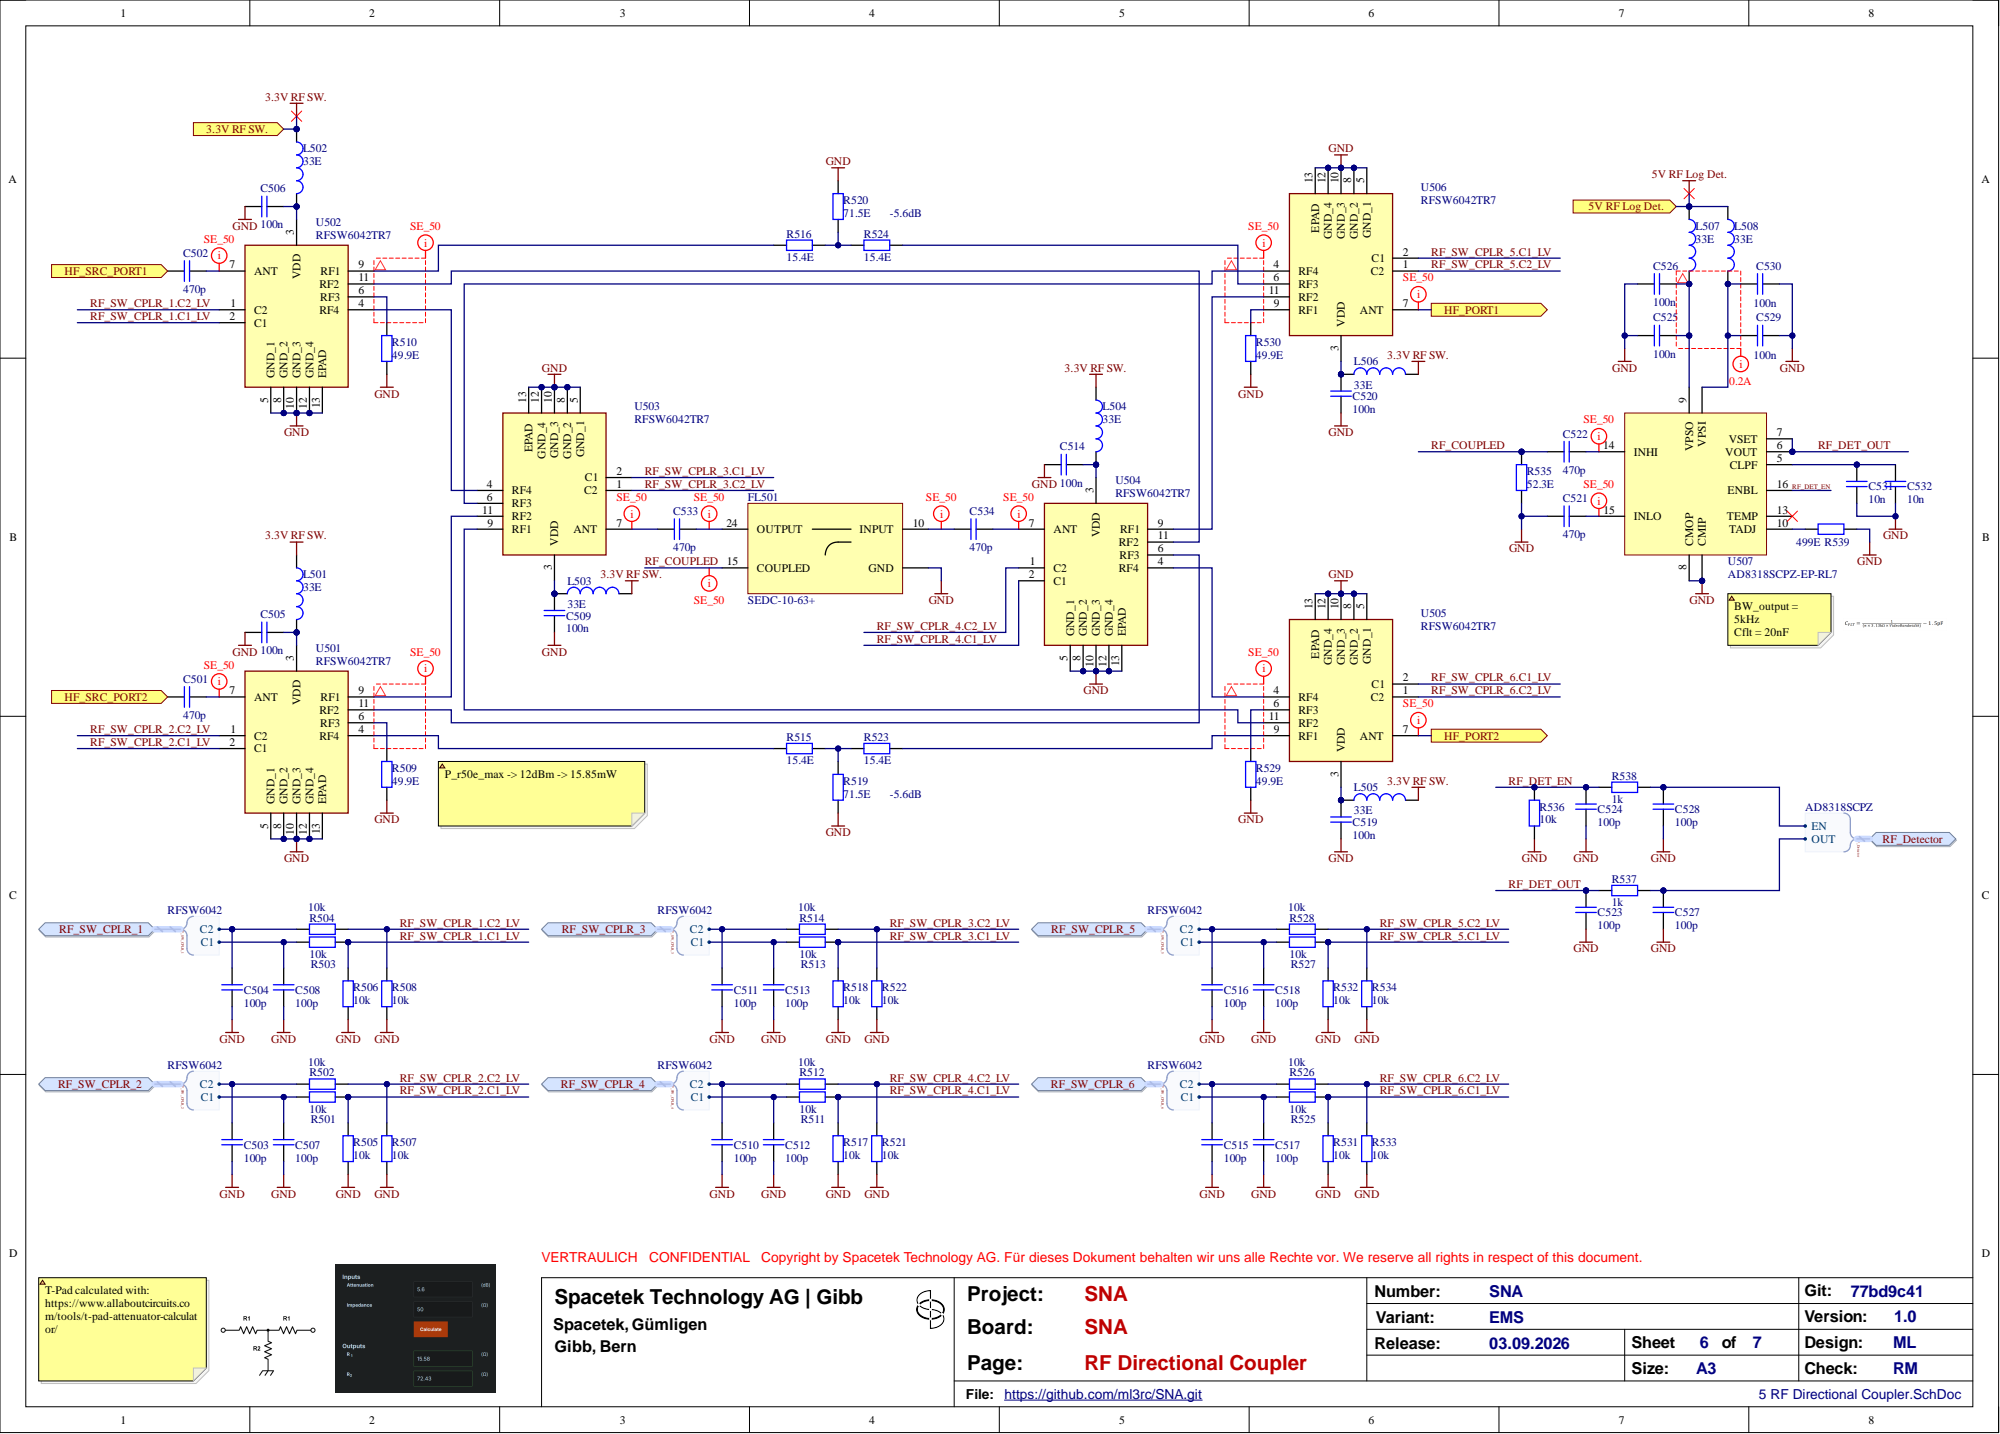
[picture p64: page 6]

GND | C1 2 | i

GND RF_SW_CPLR_4.C2_LV

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

T-Pad calculated with:
https://www.allaboutcircuits.co
m/tools/t-pad-attenuator-calculat

Spacetek Technology AG | Gibb

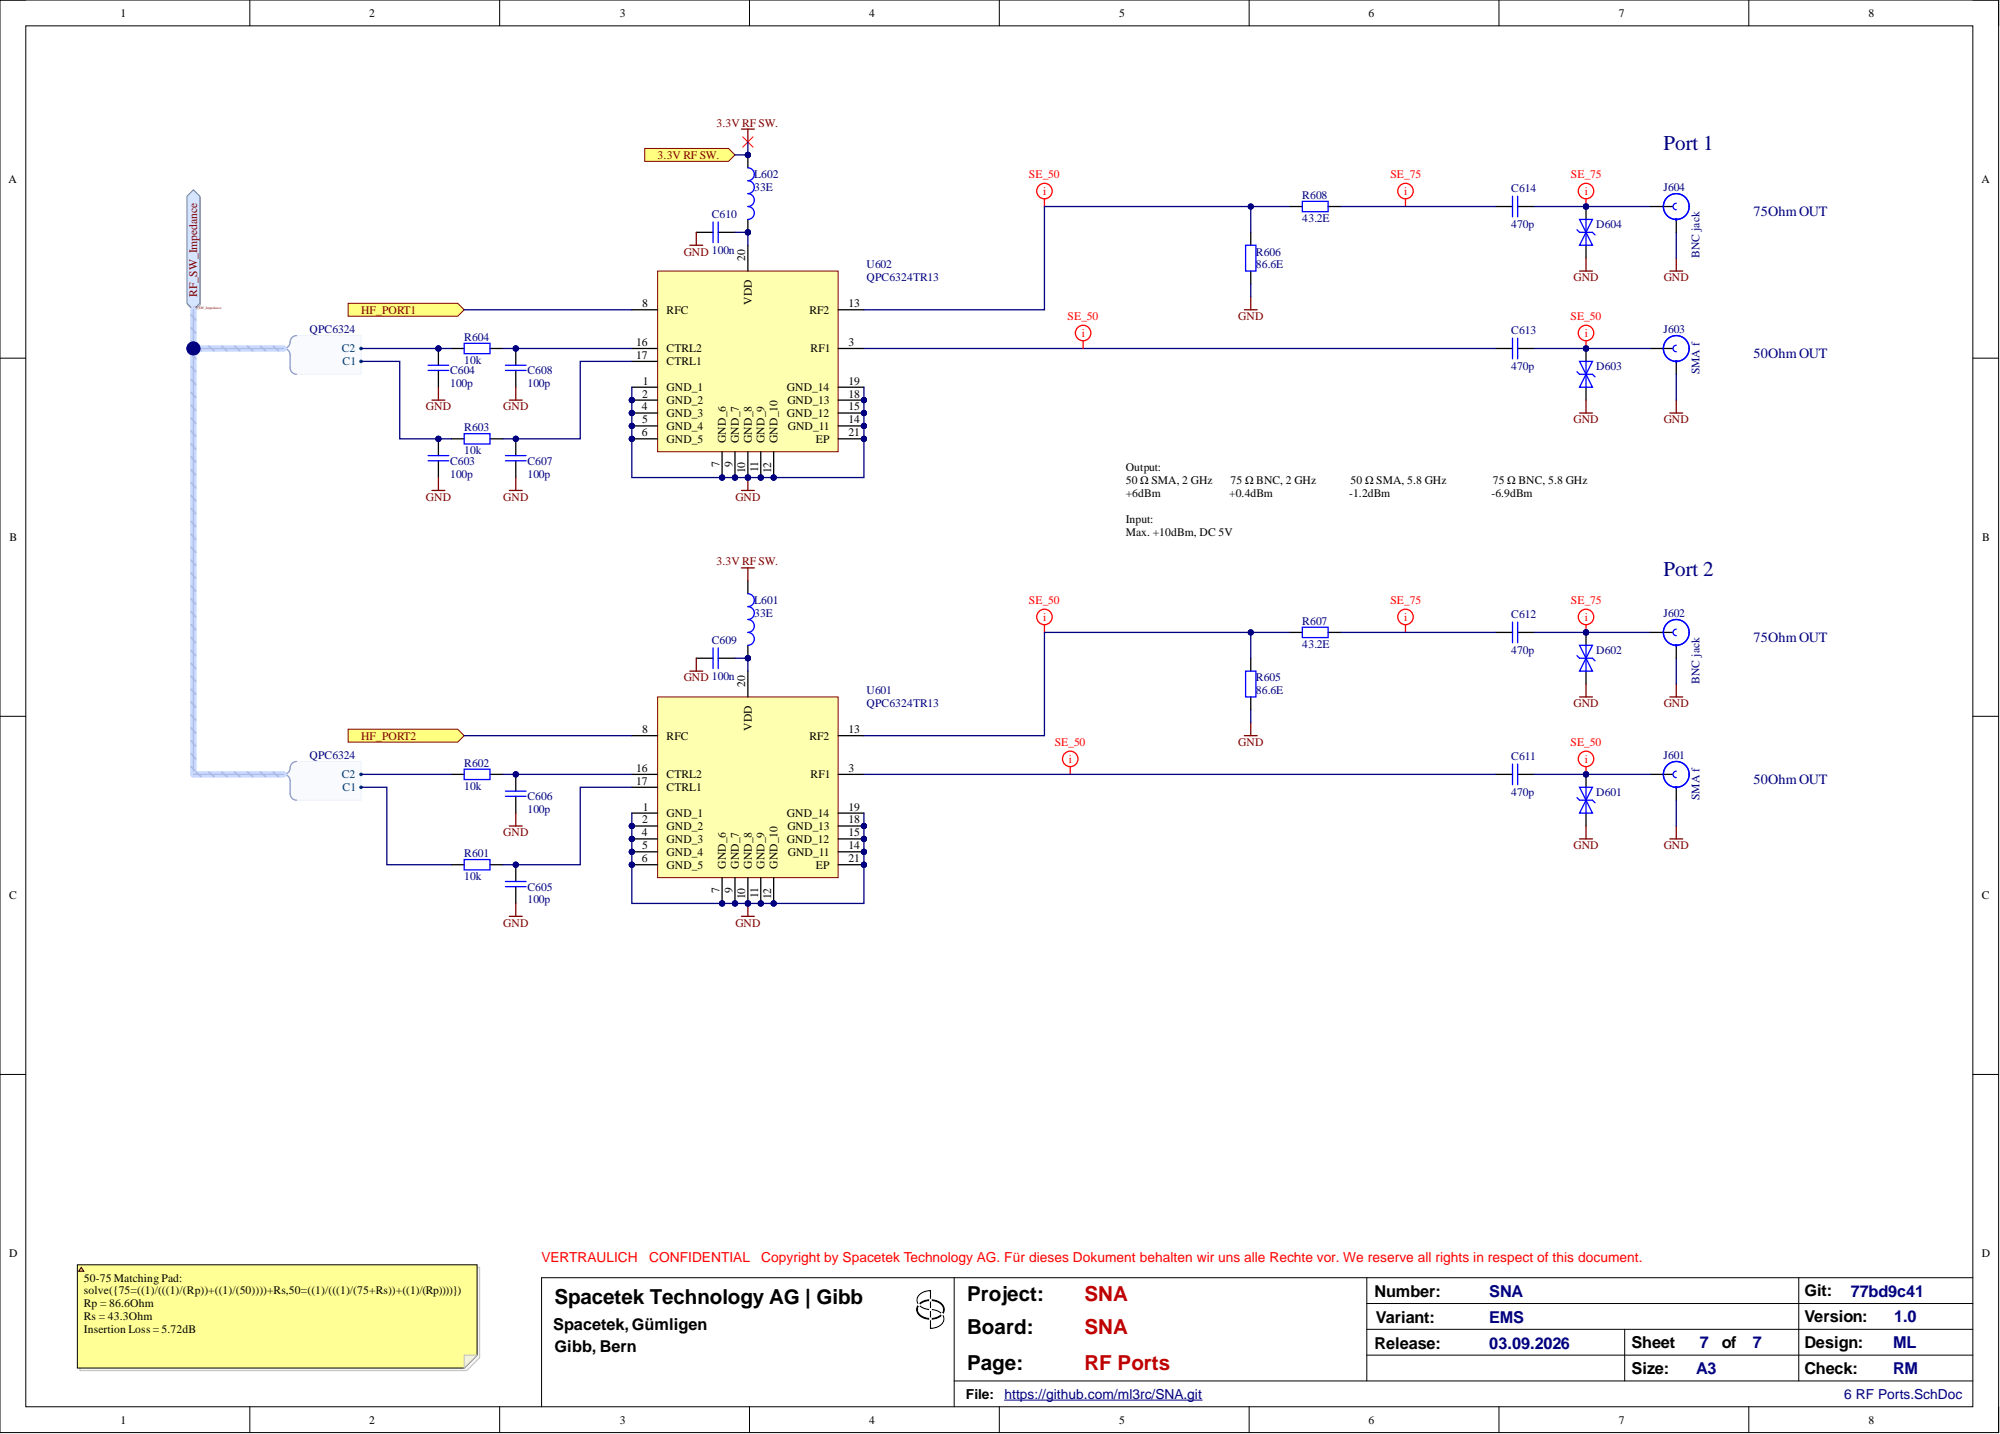
[picture p65: page 7]

2 | 1 8
4 | 1 5
5 | 1 4
6 | 2 1

2 | | 1 8
4 | | 1 5
5 | | 1 4
6 | | 2 1

r dieses Dokument behalten wir uns alle Rechte vor. We reserve all rights in respect of this document.
Project:
