ml3rc/SNA/Altium/SNAPCBVersion-INT/SNAPCBVersion_SNA-Var_EMS_Draftsman-Documentation_Rev.PCBVersion1.0.PDF

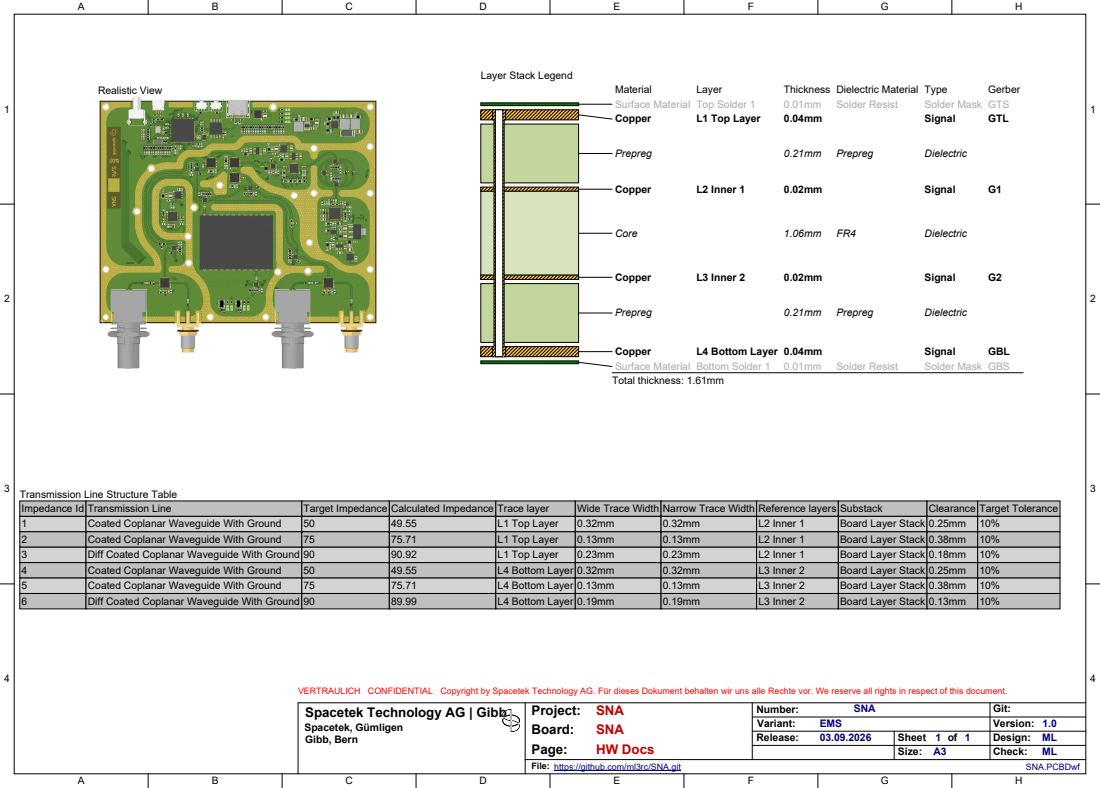
[picture p66: page 1]

Transmission Line Structure Table

Impedance Id | Transmission Line | Target Impedance | Calculated Impedance | Trace layer | Wide Trace Width | Narrow Trace Width | Reference layers | Substack | Clearance | Target Tolerance
1 | Coated Coplanar Waveguide With Ground | 50 | 49.55 | L1 Top Layer | 0.32mm | 0.32mm | L2 Inner 1 | Board Layer Stack | 0.25mm | 10%
2 | Coated Coplanar Waveguide With Ground | 75 | 75.71 | L1 Top Layer | 0.13mm | 0.13mm | L2 Inner 1 | Board Layer Stack | 0.38mm | 10%
3 | Diff Coated Coplanar Waveguide With Ground | 90 | 90.92 | L1 Top Layer | 0.23mm | 0.23mm | L2 Inner 1 | Board Layer Stack | 0.18mm | 10%
4 | Coated Coplanar Waveguide With Ground | 50 | 49.55 | L4 Bottom Layer | 0.32mm | 0.32mm | L3 Inner 2 | Board Layer Stack | 0.25mm | 10%
5 | Coated Coplanar Waveguide With Ground | 75 | 75.71 | L4 Bottom Layer | 0.13mm | 0.13mm | L3 Inner 2 | Board Layer Stack | 0.38mm | 10%
6 | Diff Coated Coplanar Waveguide With Ground | 90 | 89.99 | L4 Bottom Layer | 0.19mm | 0.19mm | L3 Inner 2 | Board Layer Stack | 0.13mm | 10%

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

File:
https://github.com/ml3rc/SNA.git
