ml3rc/SNA/Altium/SNAPCBVersion-INT/SNAPCBVersion_SNA-Var_EMS_Assembly_Rev.PCBVersion1.0.PDF

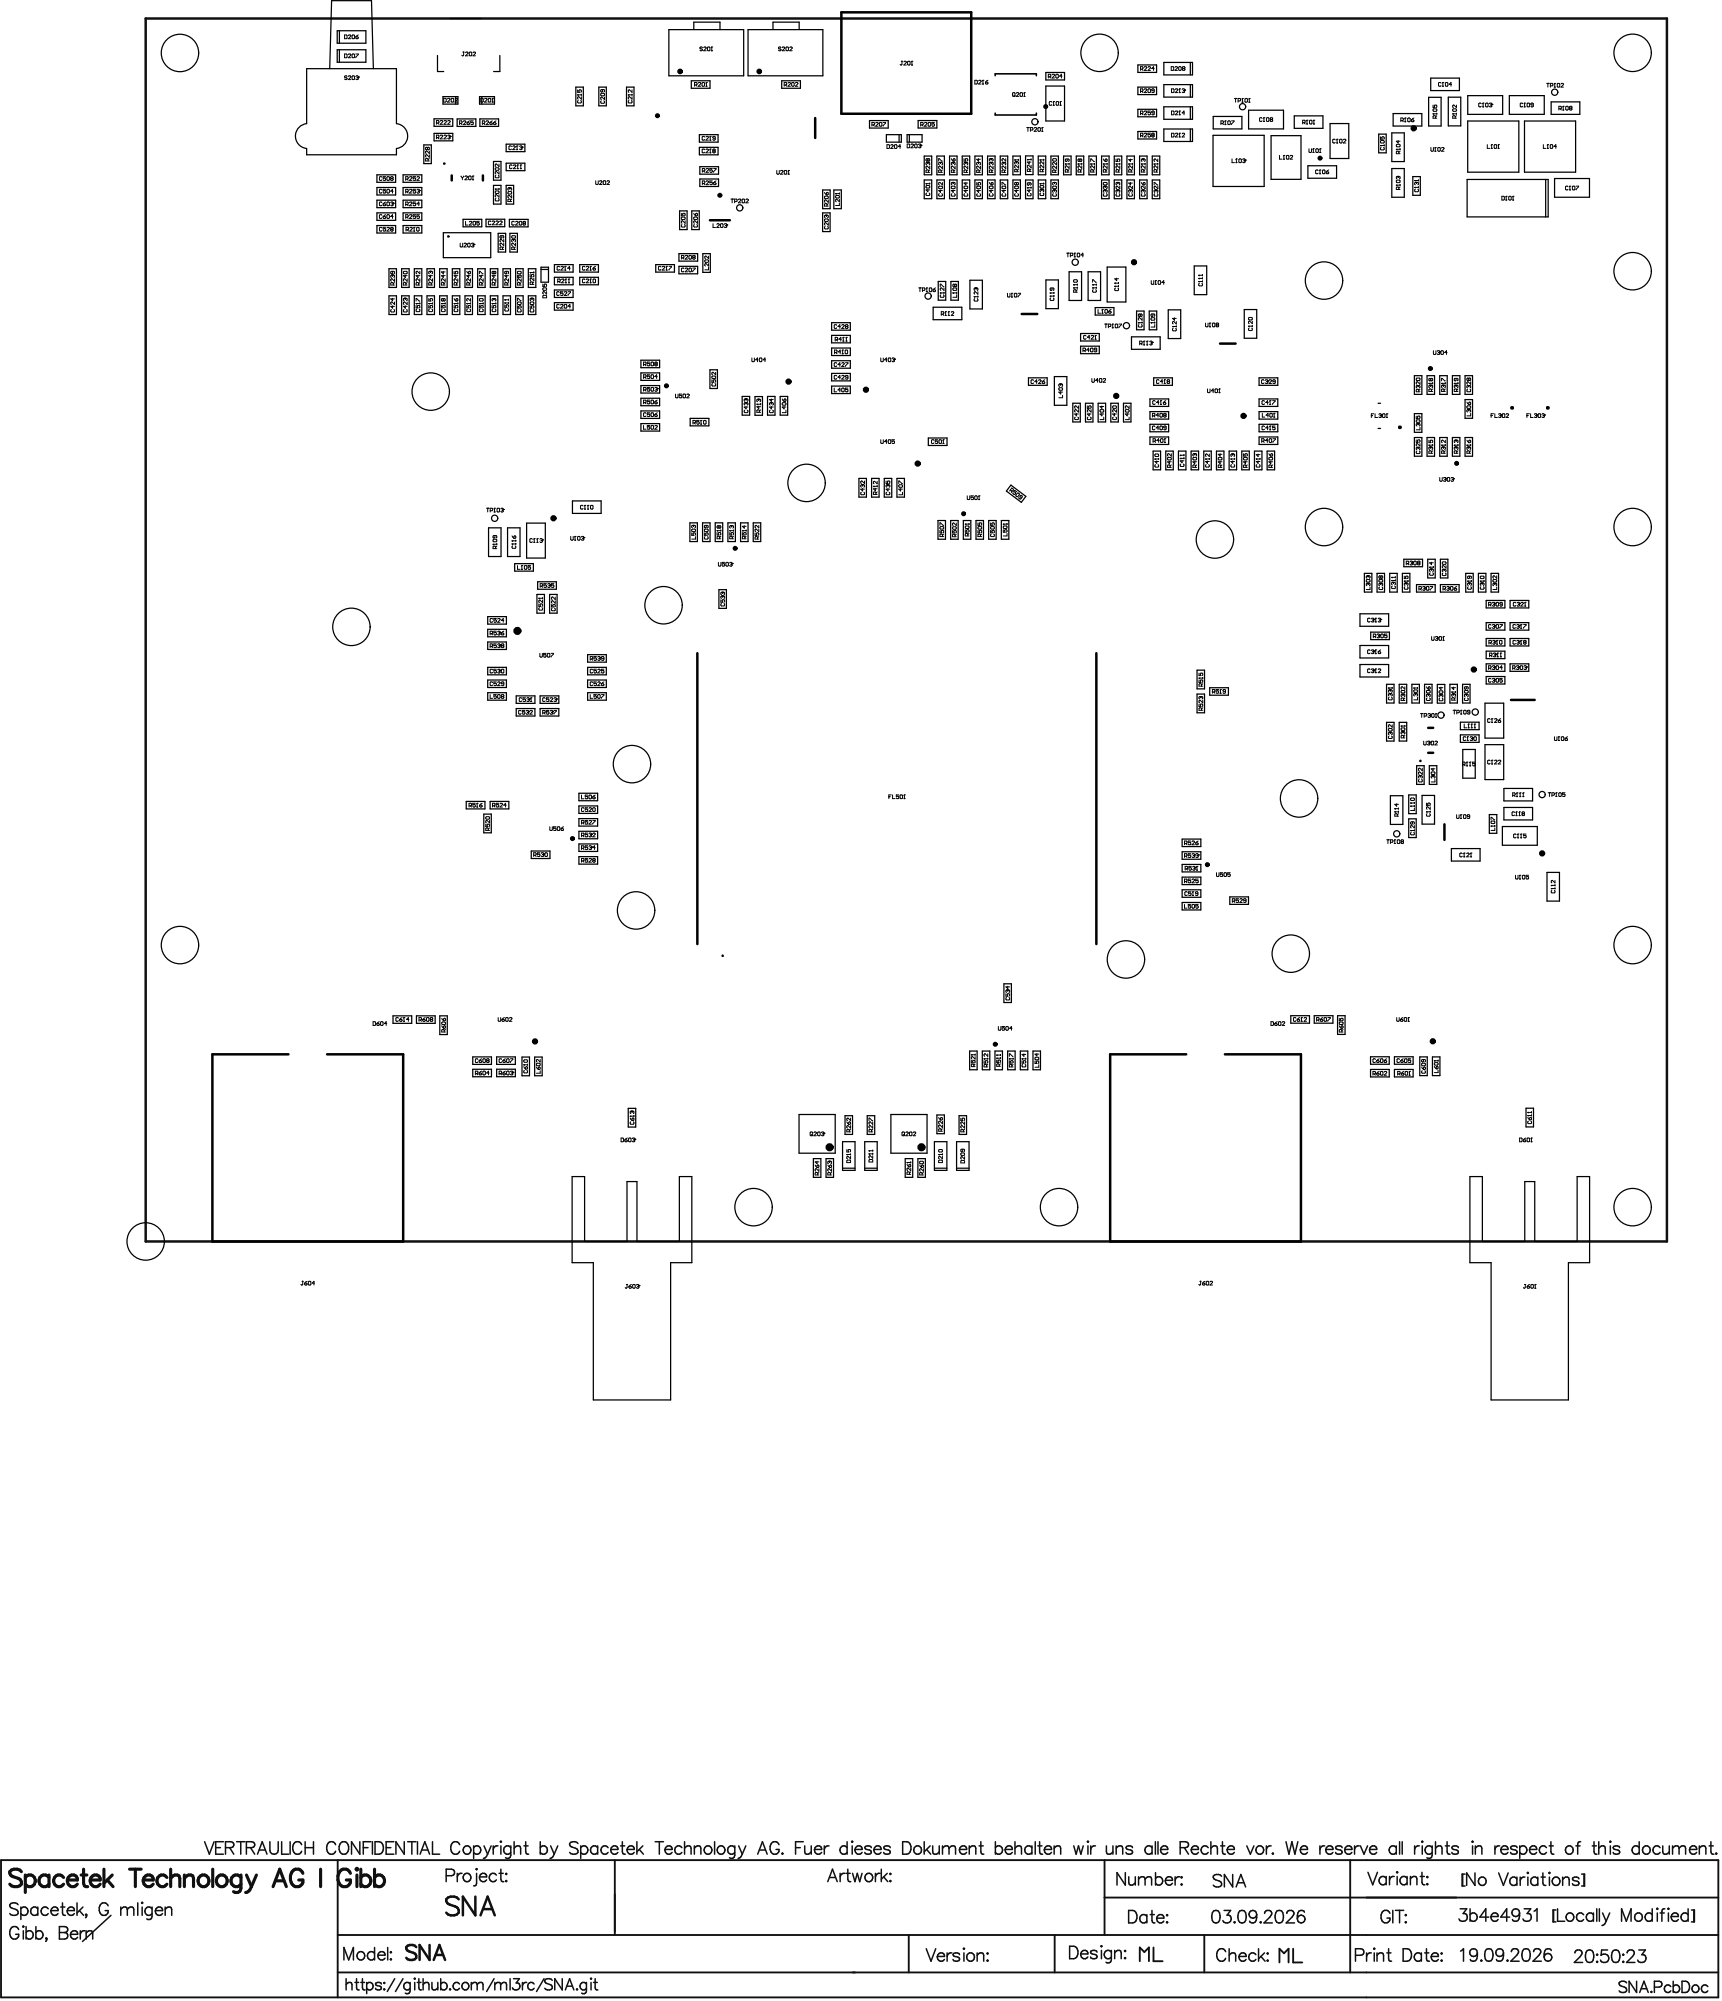
[picture p67: page 1]

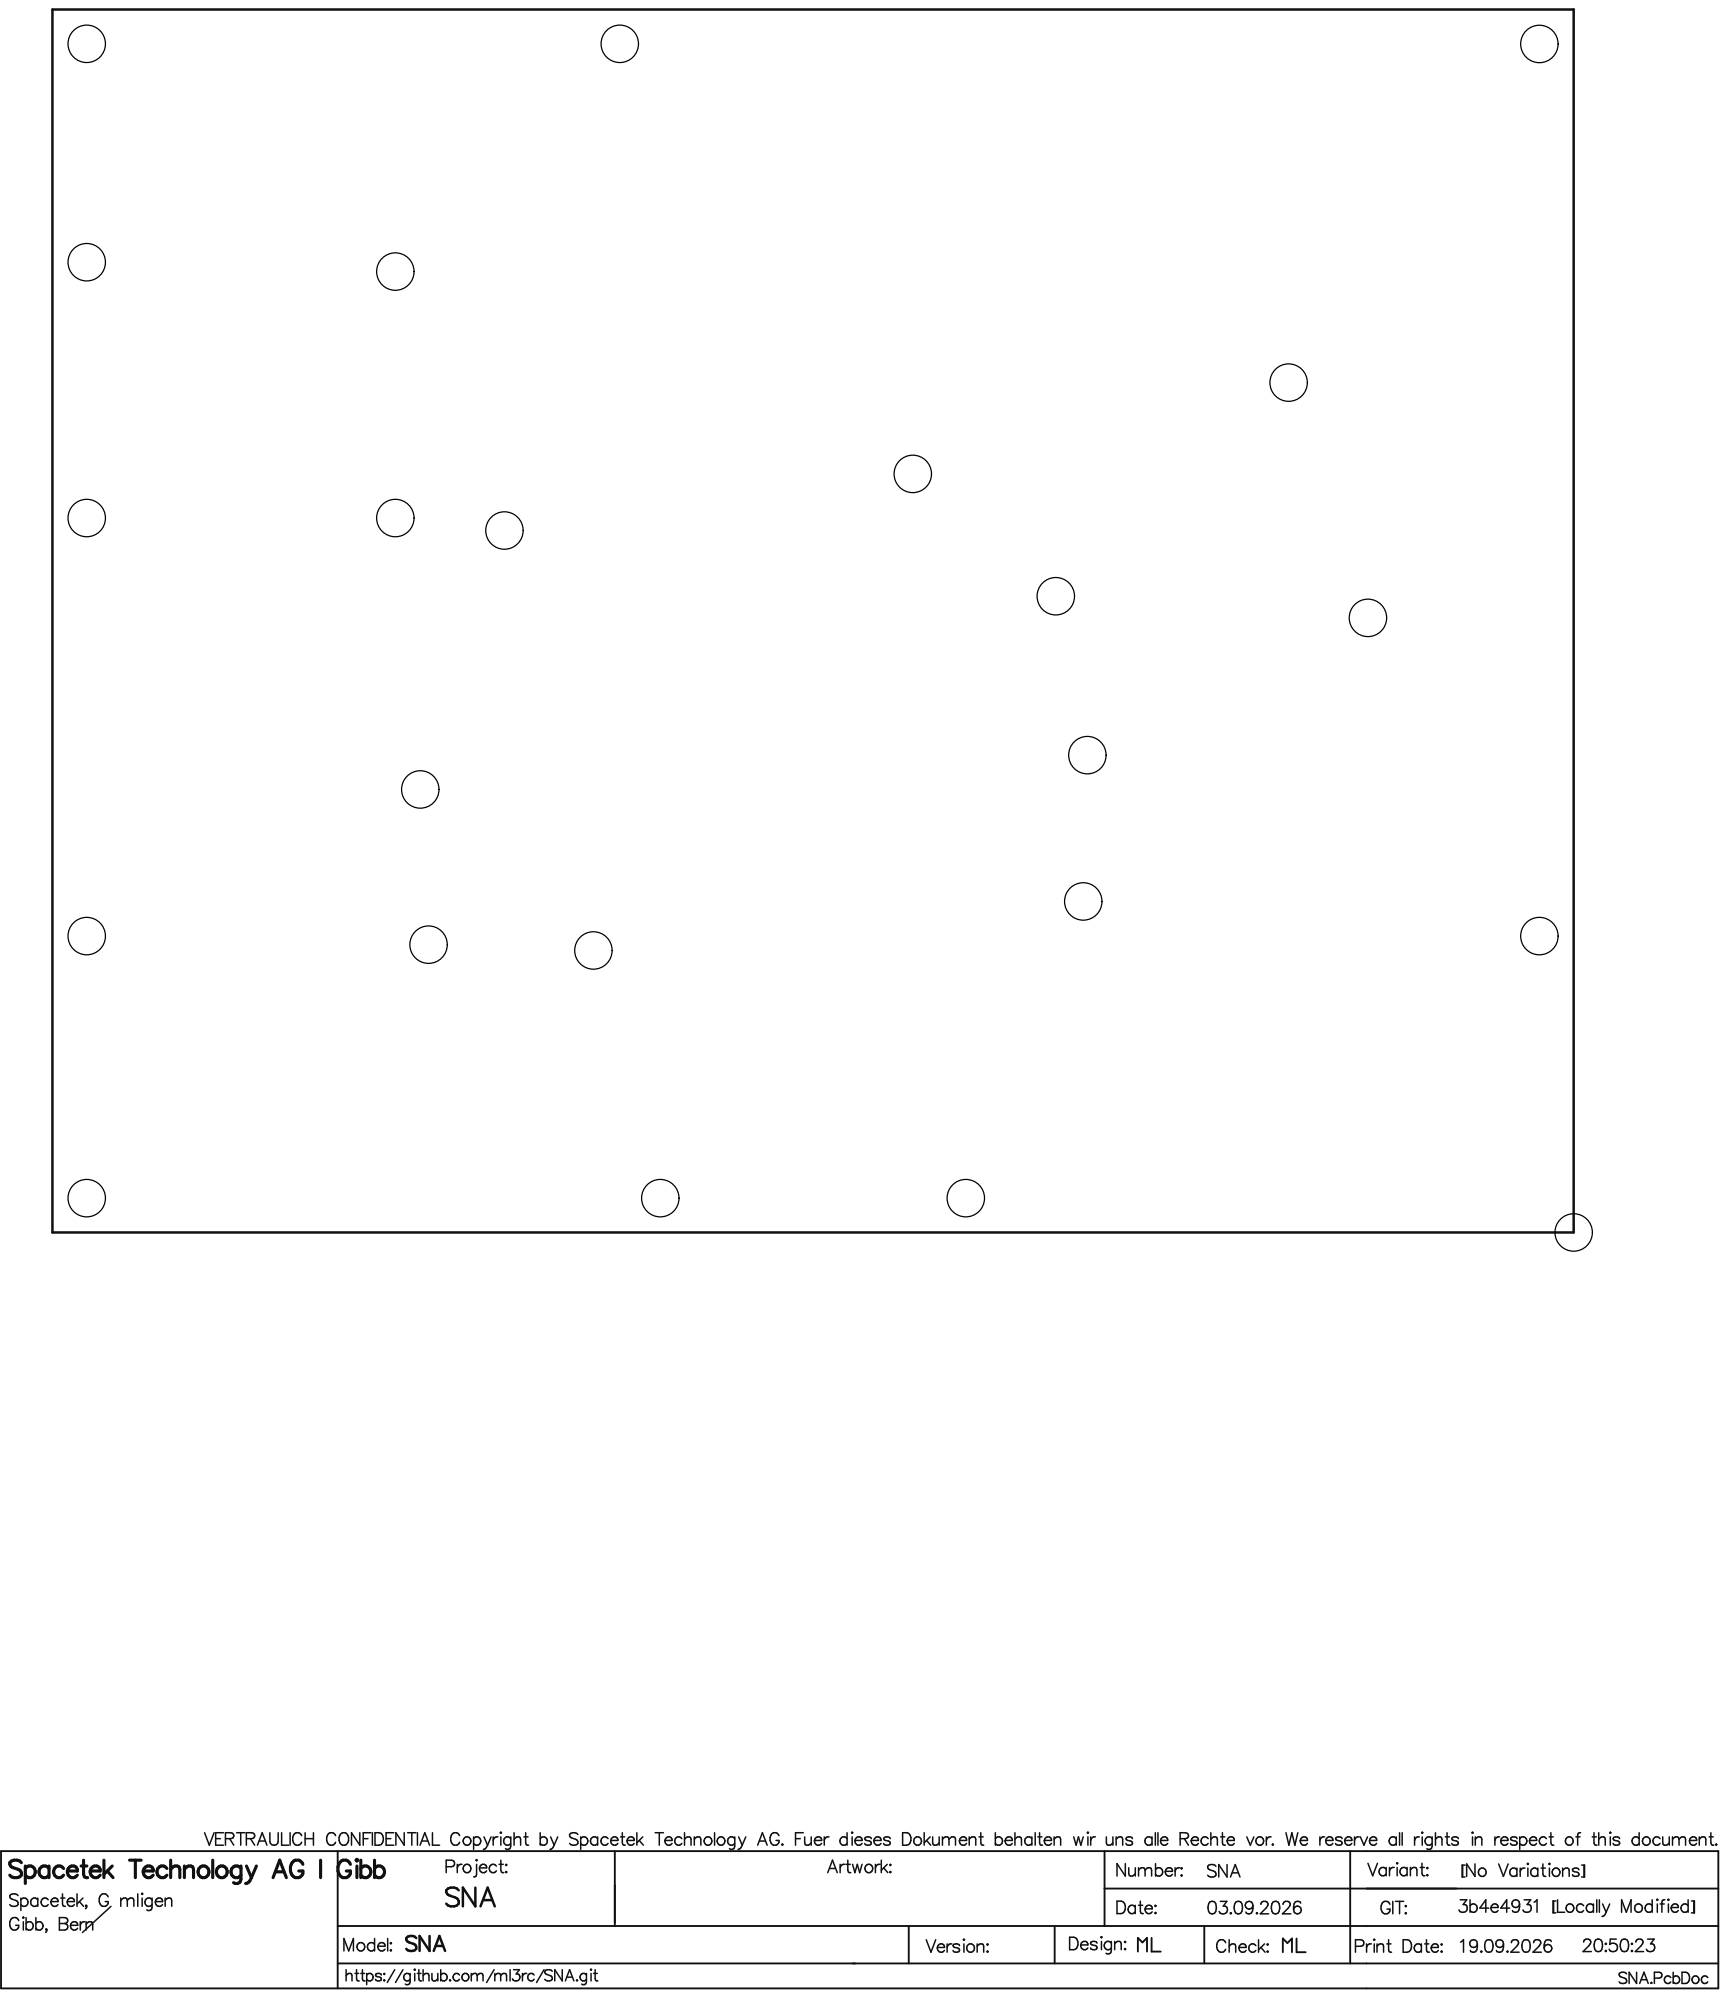
[picture p68: page 2]

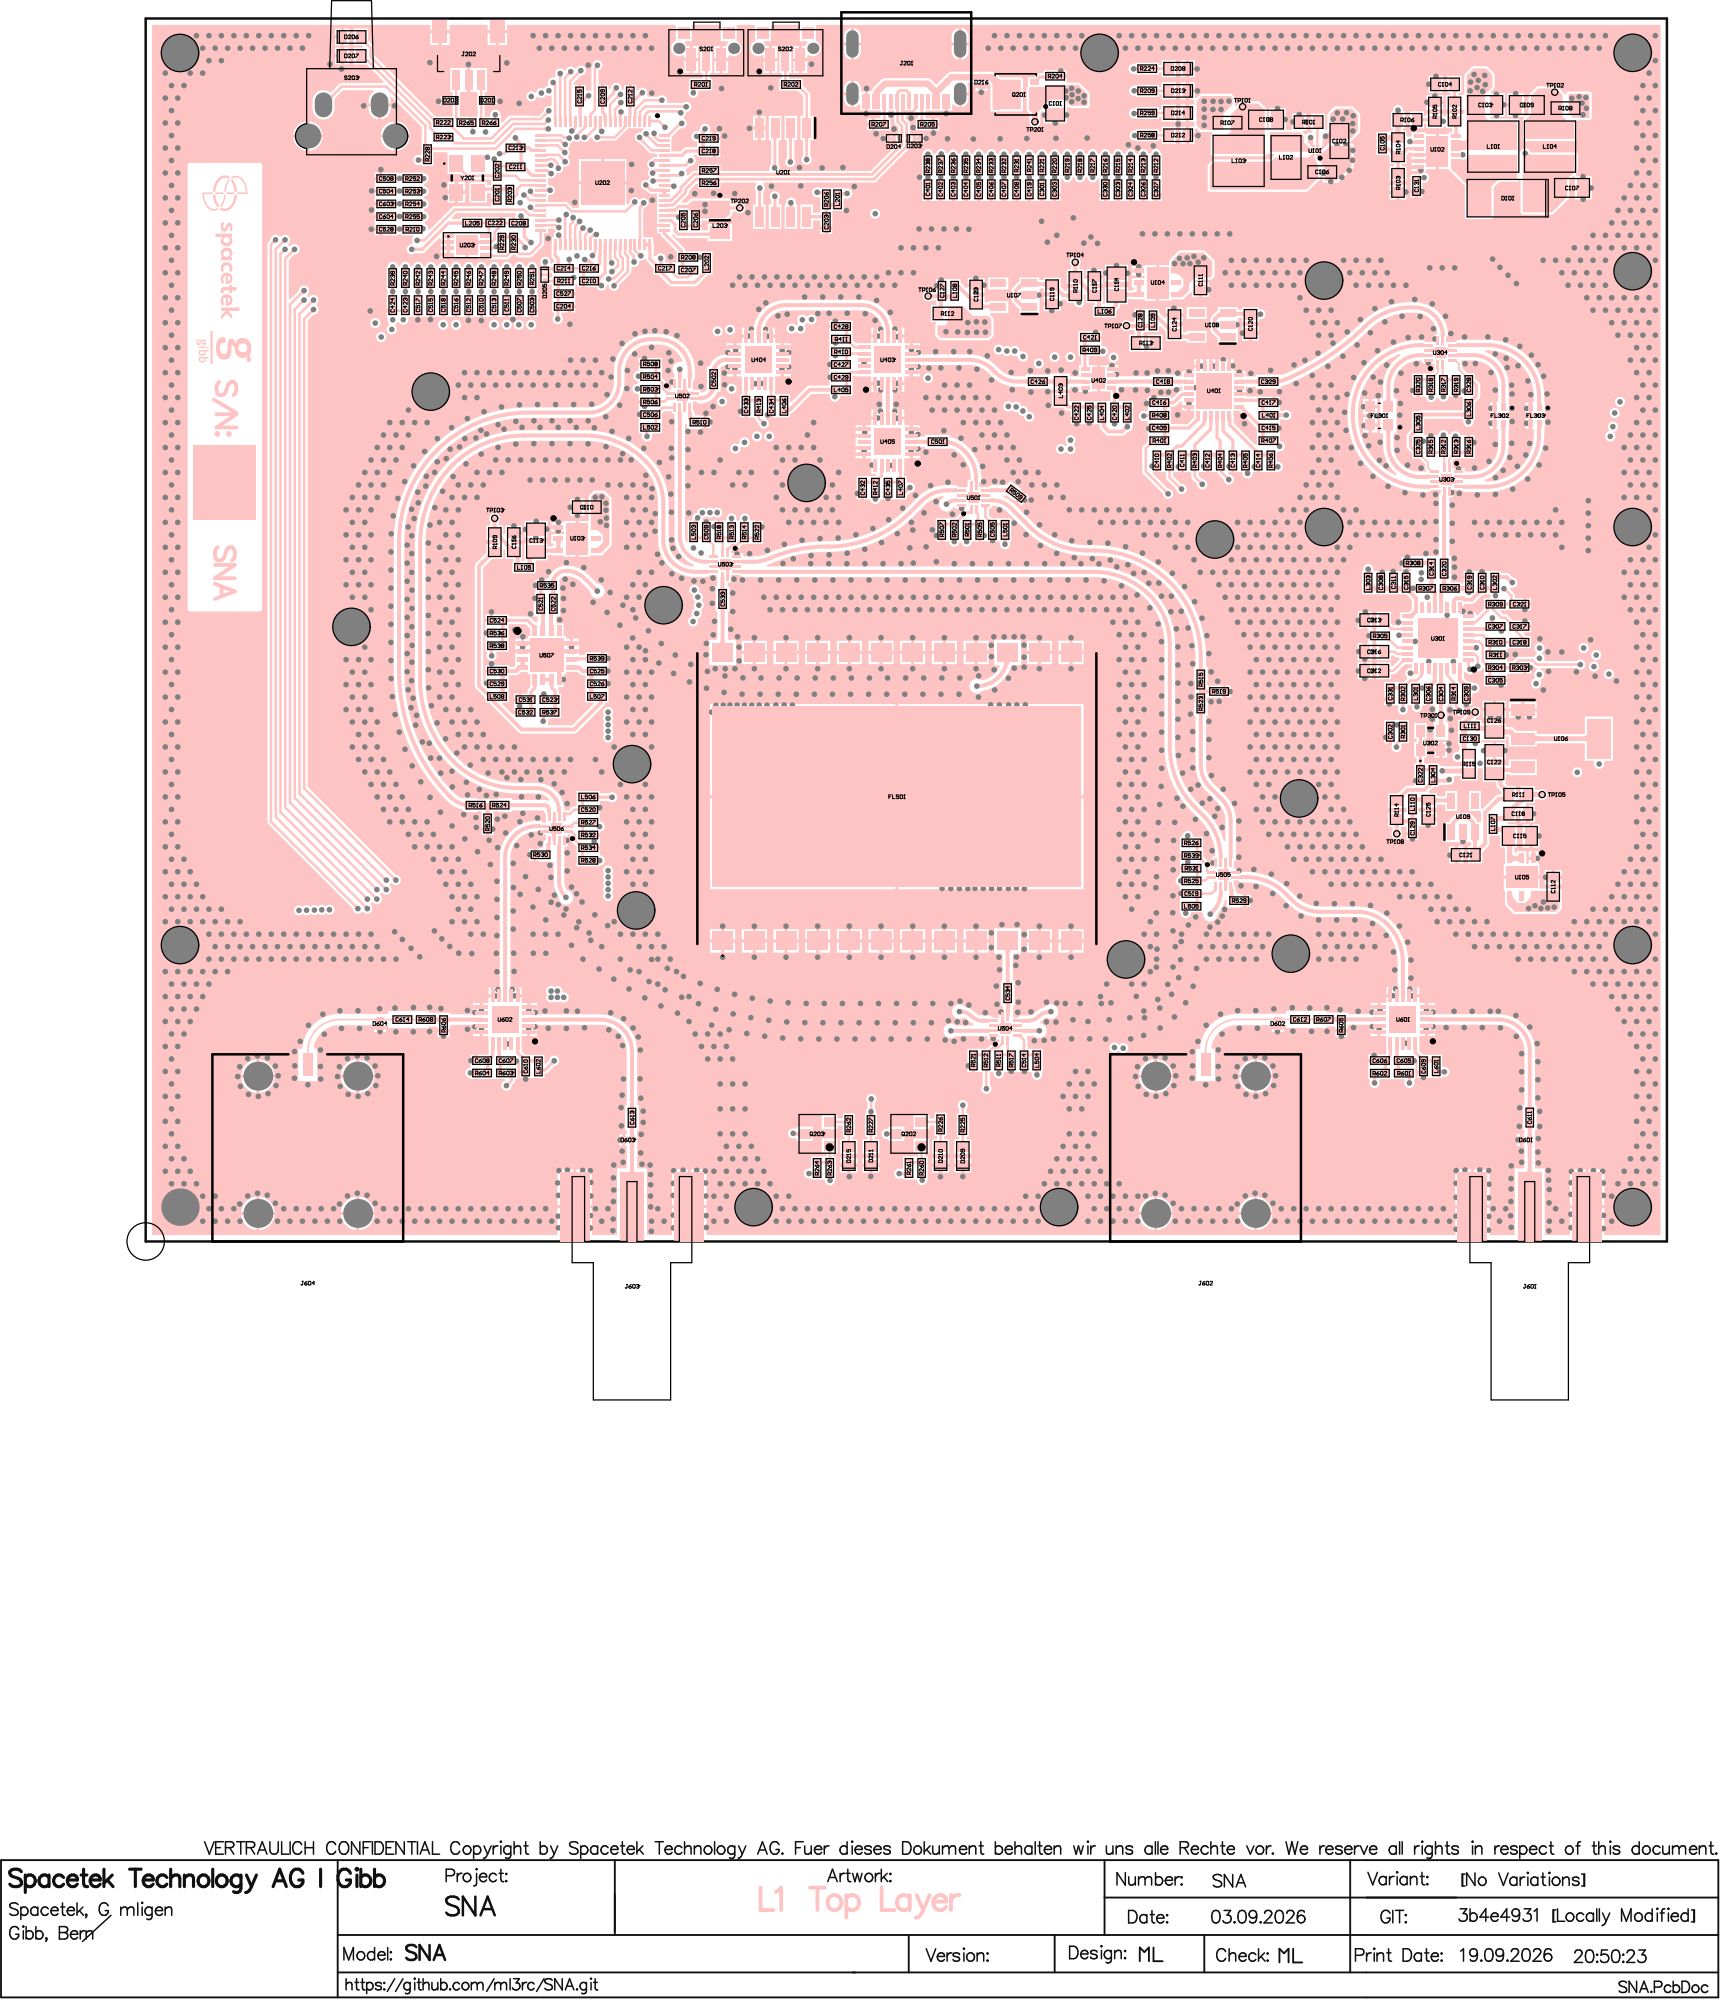
[picture p69: page 3]

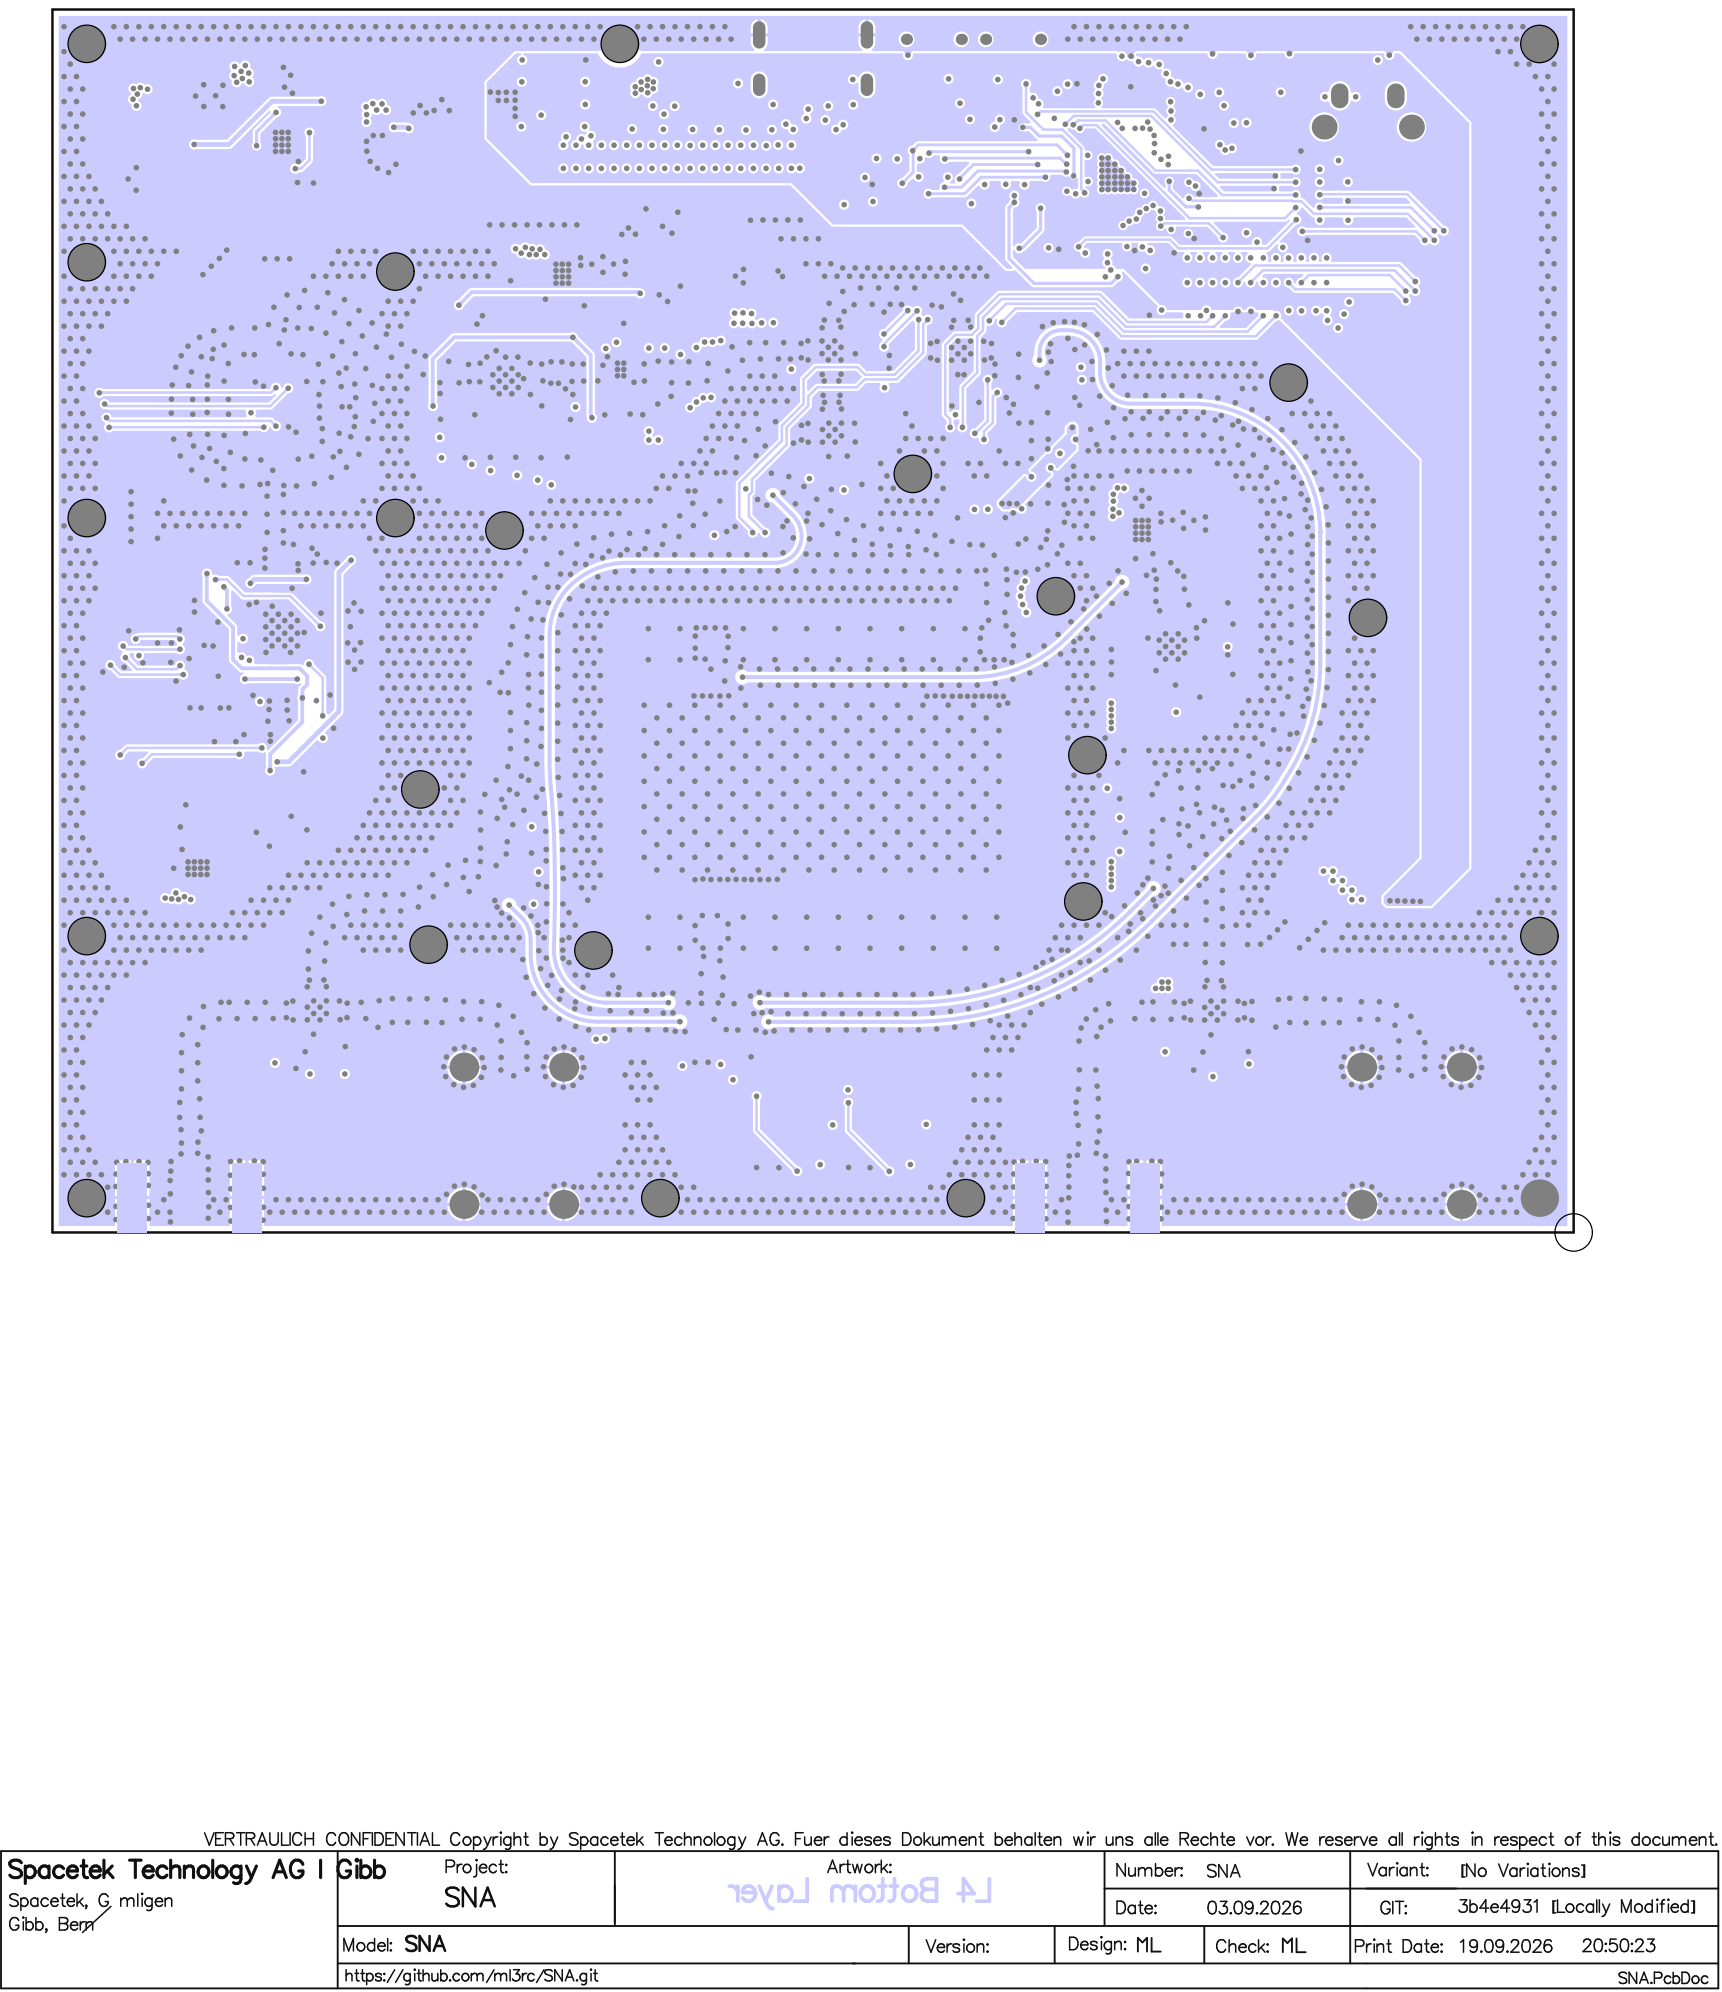
[picture p70: page 4]
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
