ml3rc/SNA/Altium/SNAPCBVersion-INT/SNAPCBVersion_SNA-Var EMS_Layout_Rev.PCBVersion1.0.PDF

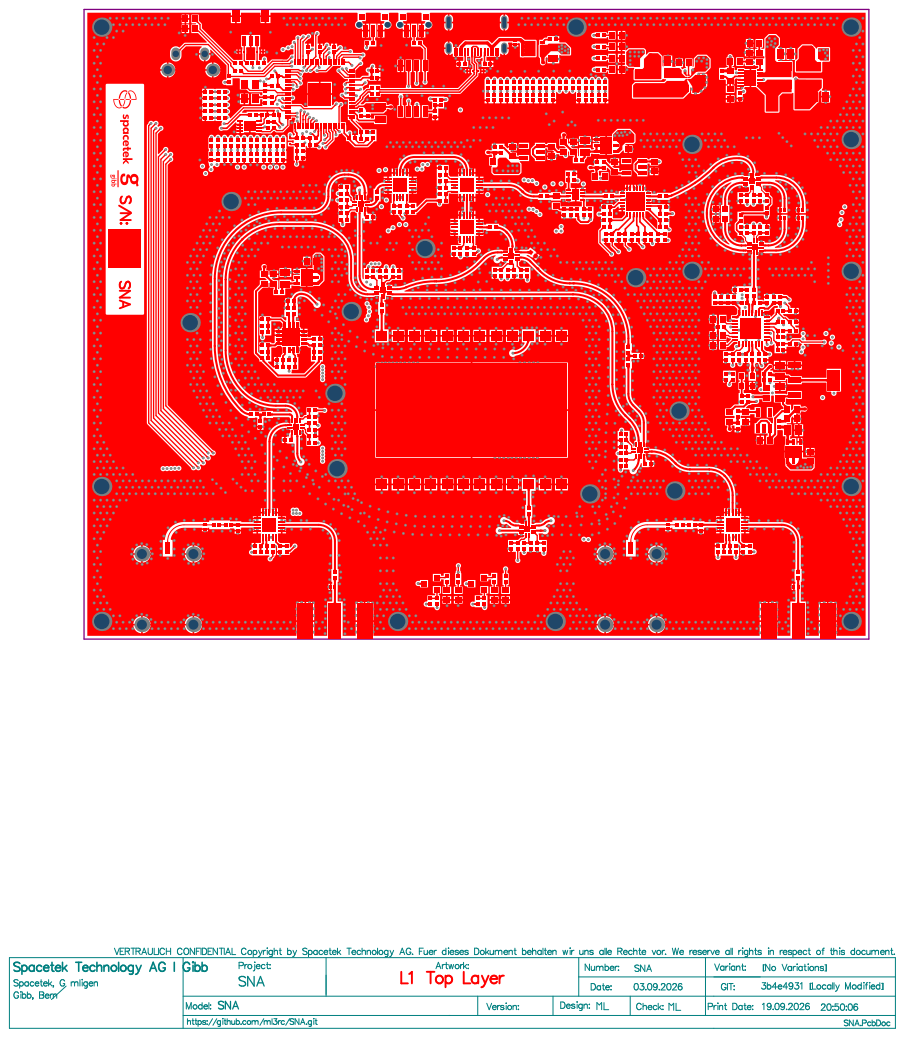
[picture p71: page 1]

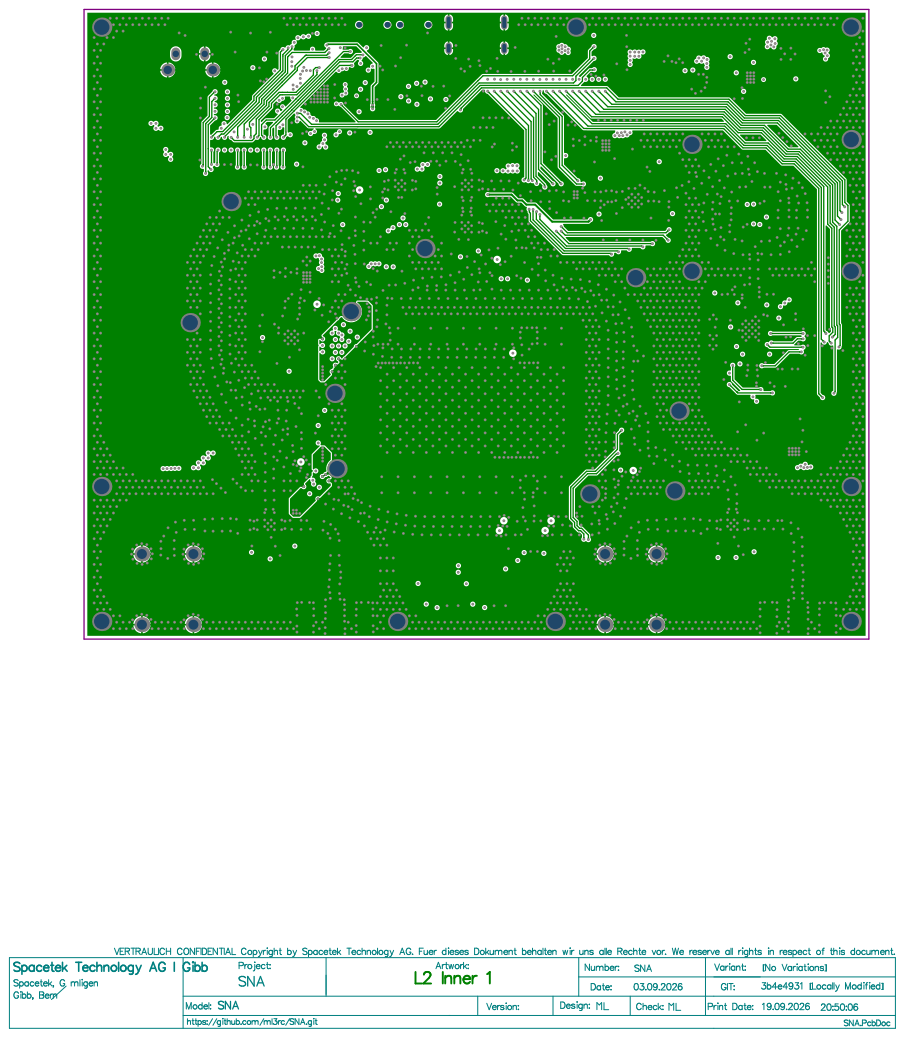
[picture p72: page 2]

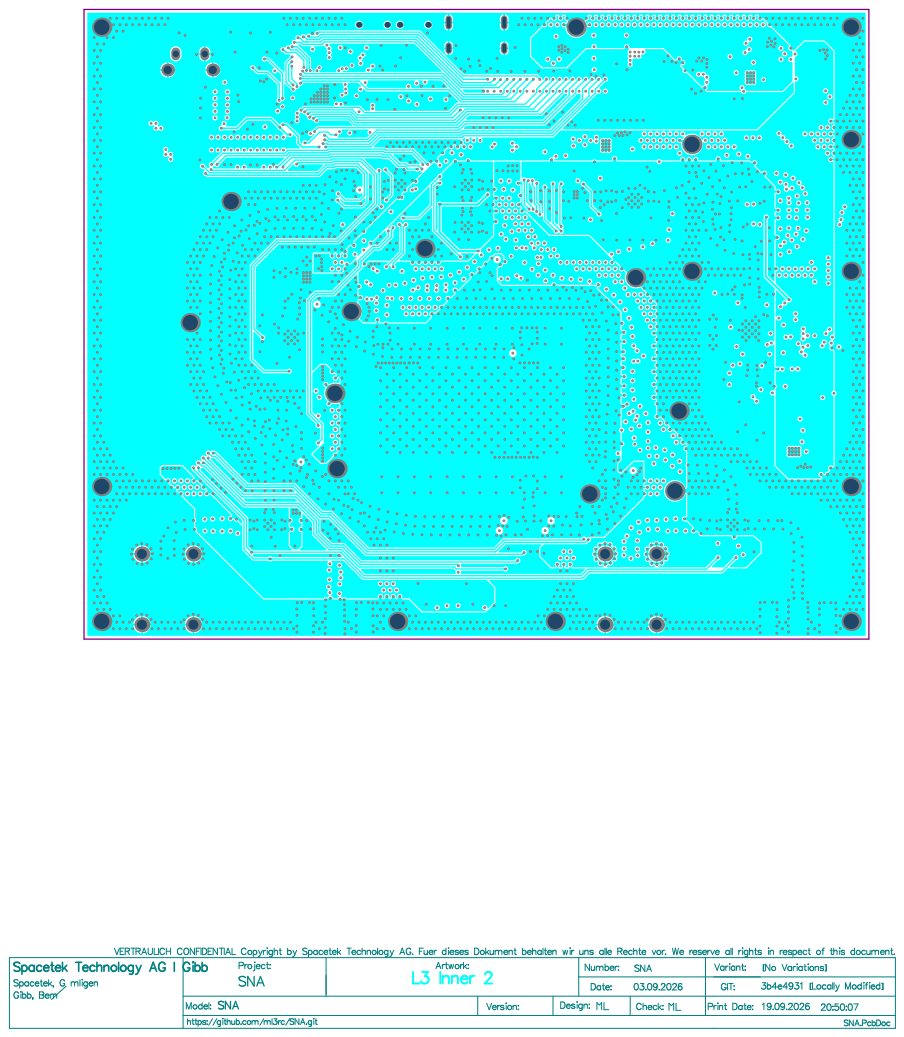
[picture p73: page 3]

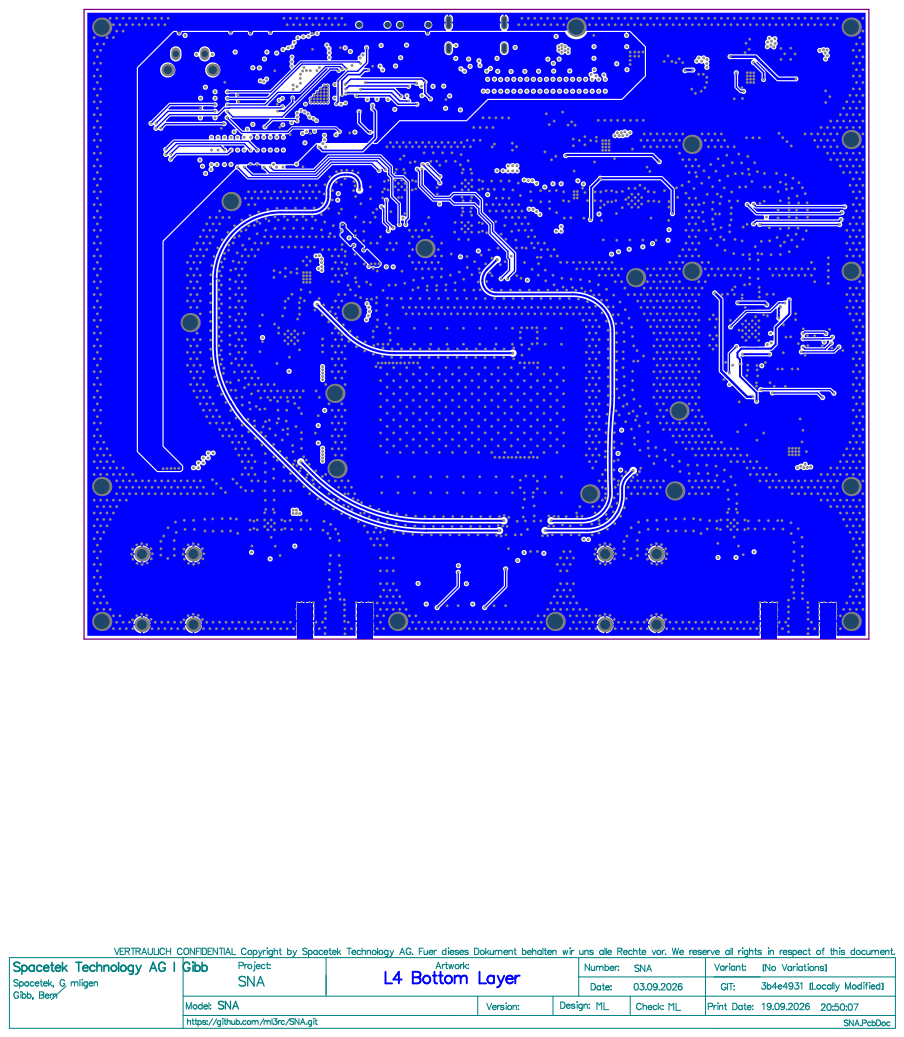
[picture p74: page 4]

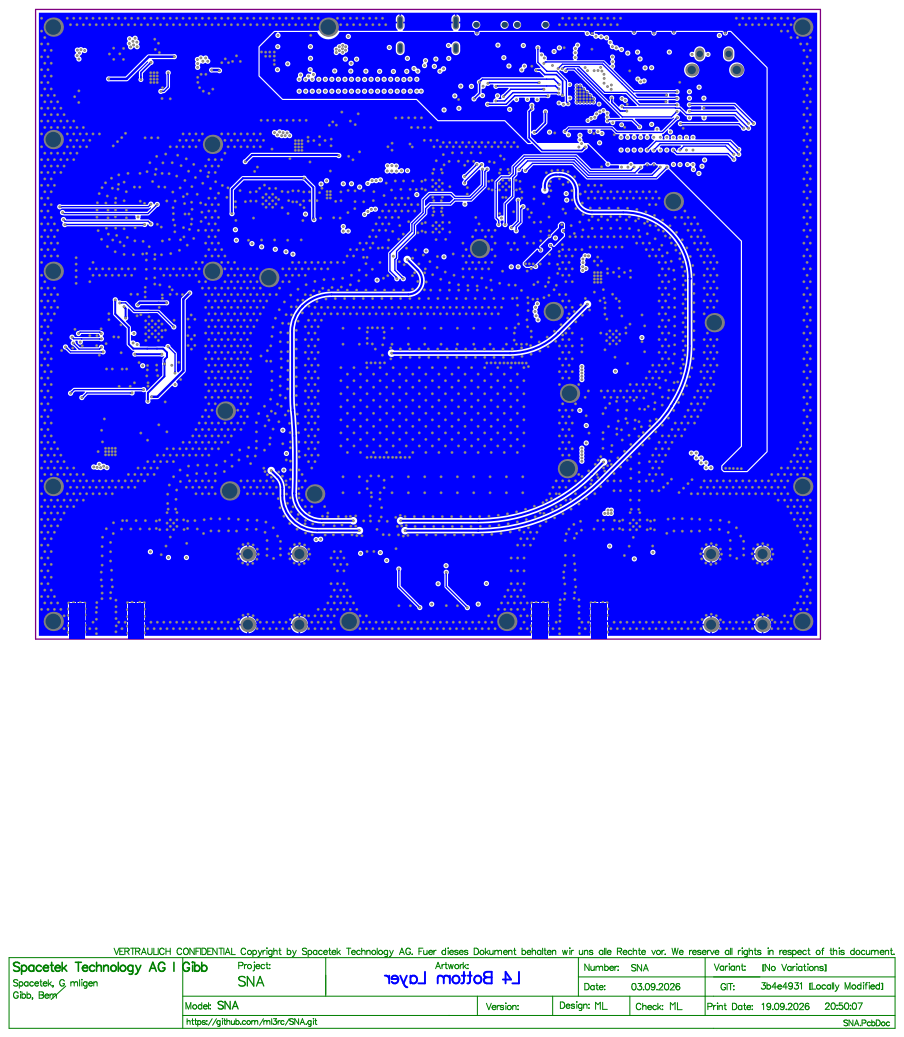
[picture p75: page 5]

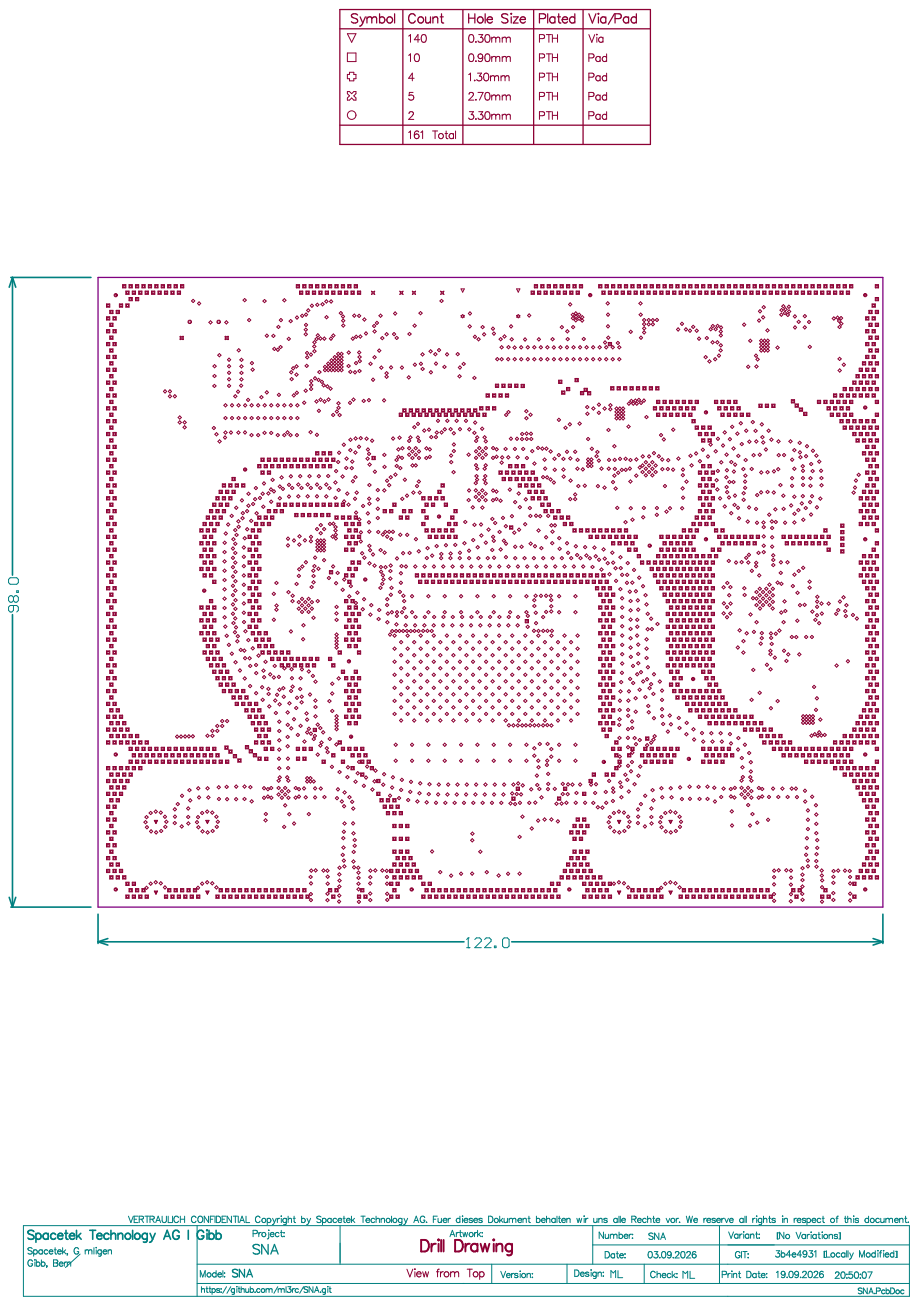
[picture p76: page 6]
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
