ml3rc/SNA/Fusion360/exp/plan.pdf

98 122

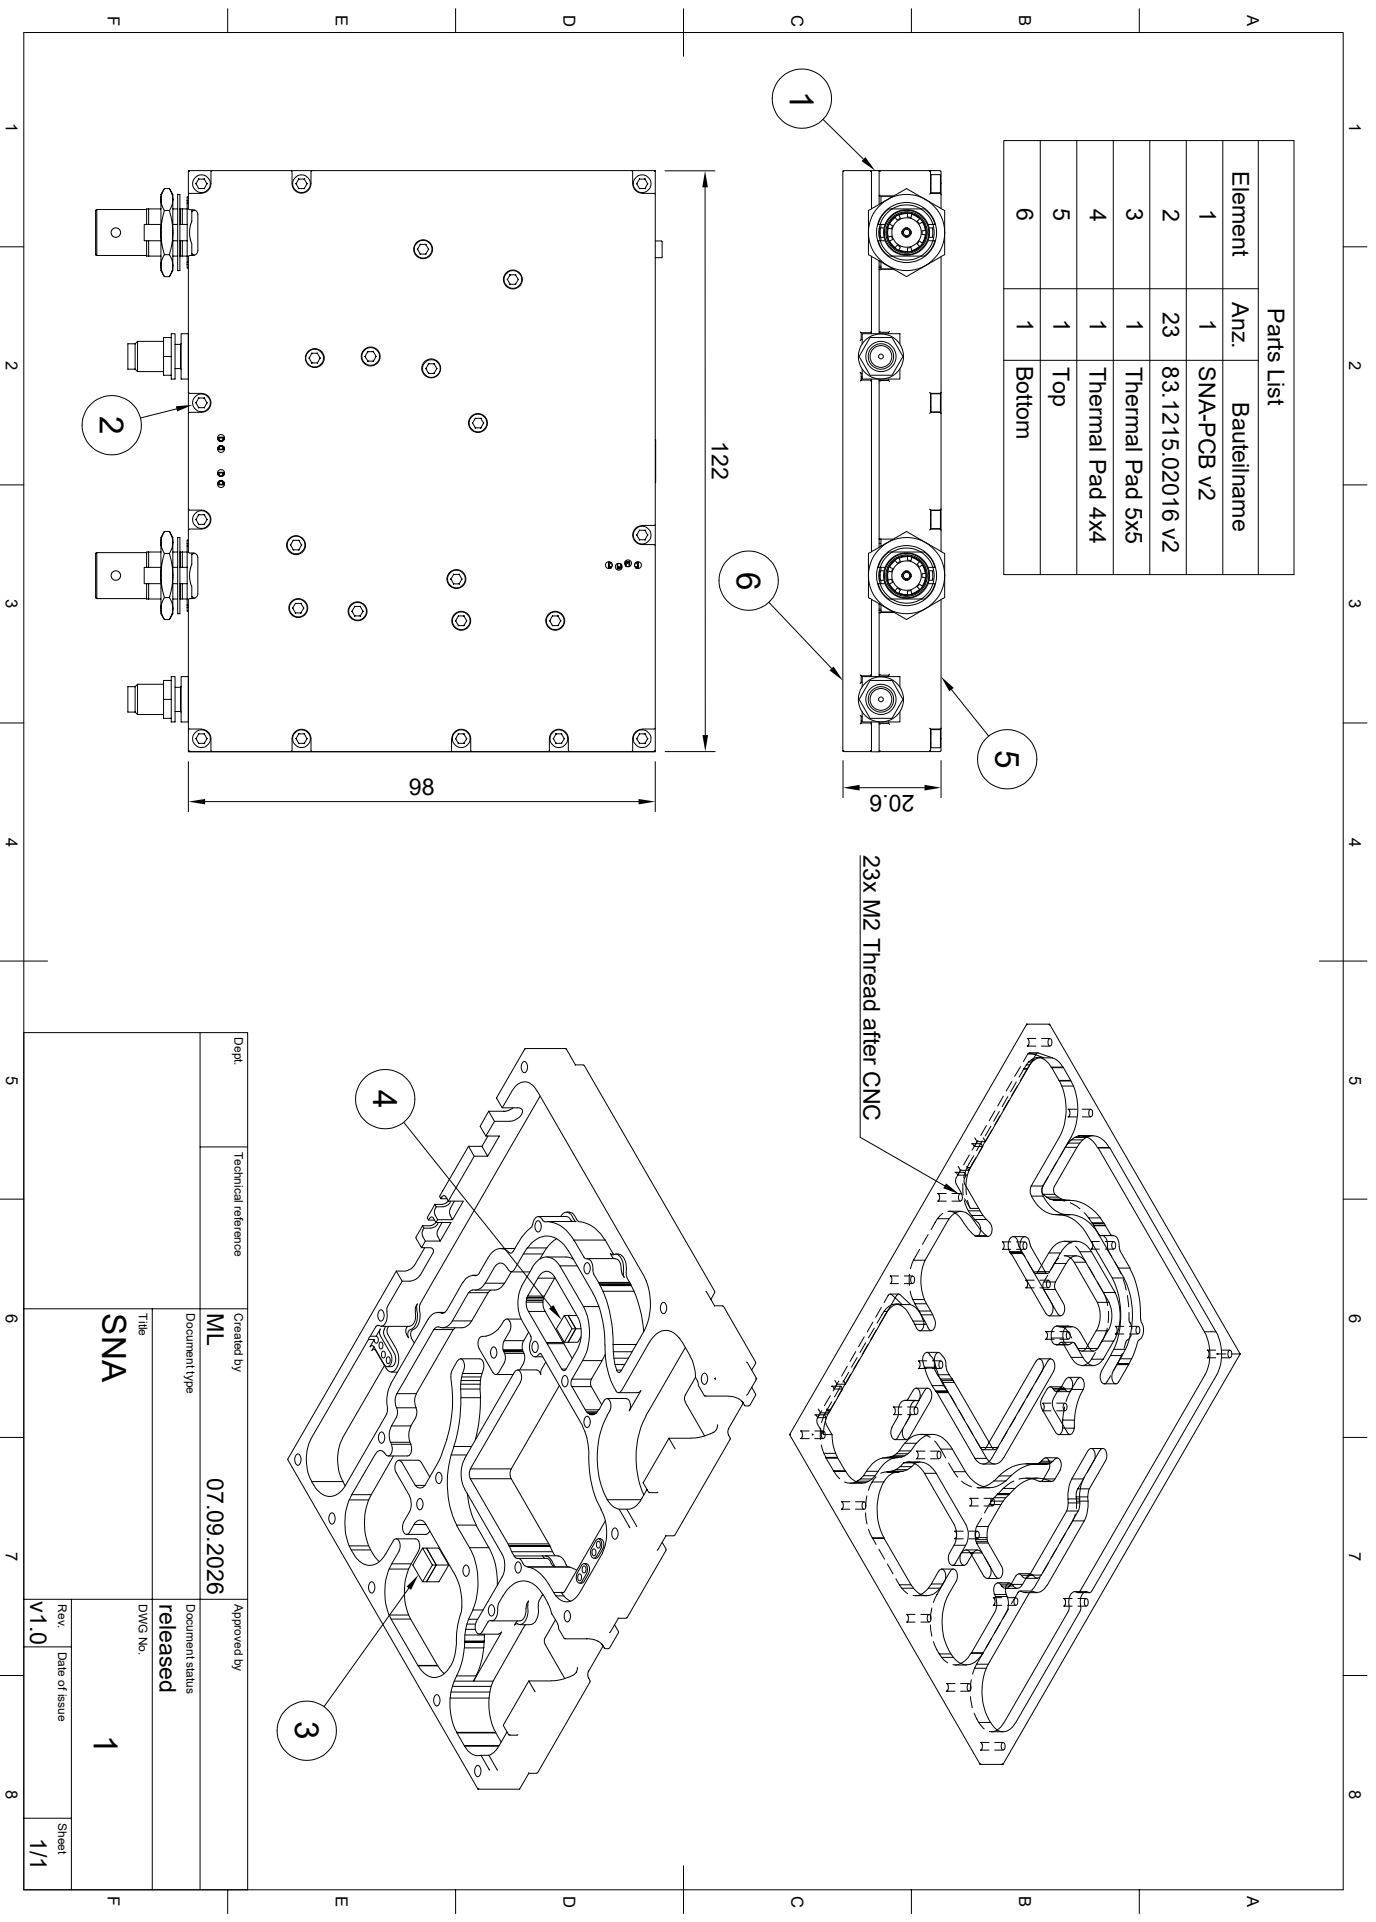
[picture p77: page 1]

1 A 2 3 4 5 6 7 8 1 2 3 4 5 6 7 8 FEDCB FEDCBA Dept. Technical reference Created by Approved by Title DWG No. Document type Document status v1.0 Rev. Date of issue Sheet released 07.09.2026 1/1 1 SNA ML
