ml3rc/SNA/(list of files, drawings)

Other design files:
Altium/0 Overview.SchDoc
Altium/1 Power.SchDoc
Altium/2 MCU.SchDoc
Altium/3 RF Source.SchDoc
Altium/4 RF Attenuation Amp.SchDoc
Altium/5 RF Directional Coupler.SchDoc
Altium/6 RF Ports.SchDoc
Altium/Overview.SchDoc
Altium/Sheet.SchDoc
Altium/SNA.PcbDoc
Altium/SNA.PrjPcb
Altium/Title.PrjPcb
