ml3rc/SNA/Software/docs/presentation/i18n_de.py

"""German strings for the presentation diagrams and animations (SNA_LANG=de). Keys are the exact English source
strings (whole label, or one line of it). Decimal points between digits become commas automatically (i18n.py), so
values keep the English number format. Part numbers, signal names, commands and JSON stay as they are."""

PATTERNS = [
    (r"measure point (\d+)", r"Punkt \1 messen"),
    (r"send (\d+)", r"Punkt \1 senden"),
]

DE = {
    # --- shared words / short labels -------------------------------------------------------------------------------
    "Legend": "Legende",
    "yes": "ja",
    "no": "nein",
    "Device": "Gerät",
    "Source": "Quelle",
    "source": "Quelle",
    "Coupler": "Koppler",
    "coupler": "Koppler",
    "Power": "Stromversorgung",
    "Reference": "Referenz",
    "reference": "Referenz",
    "Calibration": "Kalibrierung",
    "Power meter": "Leistungsmesser",
    "POWER METER": "LEISTUNGSMESSER",
    "MANUAL": "MANUELL",
    "SWEEPING": "MESSEN",
    "SHOWING": "ANZEIGEN",
    "Raw sweep": "Roh-Sweep",
    "Diagnostics": "Diagnose",
    "Console": "Konsole",
    "SDI test": "SDI-Test",
    "hardware": "Hardware",
    "Amplifier": "Verstärker",
    "Attenuator": "Dämpfungsglied",
    "attenuator": "Dämpfungsglied",
    "switch": "Schalter",
    "switches": "Schalter",
    "detector": "Detektor",
    "Detector": "Detektor",
    "directional": "Richt-",
    "termination": "Abschluss",
    "cable": "Kabel",
    "harmonics": "Oberwellen",
    "level": "Pegel",
    "time": "Zeit",
    "chart": "Diagramm",
    "Request": "Anfrage",
    "request": "Anfrage",
    "Reply": "Antwort",
    "reply": "Antwort",
    "done": "fertig",
    "again": "nochmals",
    "nothing": "nichts",
    "measured": "gemessen",
    "measures": "misst",
    "sends": "sendet",
    "raw": "roh",
    "retune": "umstimmen",
    "Retune": "Umstimmen",
    "missed": "verpasst",
    "press": "drücken",
    "launch": "Start",
    "convert": "umrechnen",
    "median": "Median",
    "atomic": "atomar",
    "PC client": "PC-Client",
    "Kotlin app": "Kotlin-App",
    "transport": "Transport",
    "all values in dB": "alle Werte in dB",
    # code-font lines (exact match only)
    "rf_state_set_source(OFF | PARKED | ON)  ← the only way to change it":
        "rf_state_set_source(OFF | PARKED | ON)  ← der einzige Weg, ihn zu ändern",
    "(1871 − 1500) / −30.4  = −12.2 dB": "(1871 − 1500) / −30,4  = −12,2 dB",
    "−12.2 dB − cal(1 GHz) 0.1 = −12.3 dB": "−12,2 dB − Kal.(1 GHz) 0,1 = −12,3 dB",
    "synthesizer": "Synthesizer",
    "synth": "Synth",
    "buck": "Buck",
    "boost + LDOs": "Boost + LDOs",
    "port 1 / 2": "Port 1 / 2",
    "port 1 ↔ 2": "Port 1 ↔ 2",
    "port 1": "Port 1",
    "port 2": "Port 2",
    "backpressure": "Backpressure",
    "watchdog": "Watchdog",
    "event": "Event",
    "settle": "warten",
    '{"id":4,"ok":true, …}   or   {"id":4,"ok":false,"error":"busy"}': '{"id":4,"ok":true, …}   oder   {"id":4,"ok":false,"error":"busy"}',
    "logarithmic": "logarithmisch",
    "signal": "Signal",
    "reset": "Reset",
    "USB / ports": "USB / Ports",

    # --- hw-01 system overview -----------------------------------------------------------------------------------------
    "SNA — system overview": "SNA — Systemübersicht",
    "2-port scalar network analyzer · 50 MHz – 6 GHz · 50 Ω SMA / 75 Ω BNC":
        "Skalarer 2-Port-Netzwerkanalysator · 50 MHz – 6 GHz · 50 Ω SMA / 75 Ω BNC",
    "SNA board — 4-layer PCB in a milled aluminium case": "SNA-Platine — 4-Lagen-PCB in gefrästem Aluminiumgehäuse",
    "USB 5 V → boost 6 V → LDOs for RF  ·  buck 3.3 V for digital":
        "USB 5 V → Boost 6 V → LDOs für HF  ·  Buck 3.3 V für Digital",
    "RF source": "HF-Quelle",
    "MAX2871 PLL → LPF bank → attenuator → amplifier": "MAX2871 PLL → Tiefpassbank → Dämpfungsglied → Verstärker",
    "Port + coupler switching": "Port- und Kopplerumschaltung",
    "3× SPDT port select · 6× SP4T coupler bank": "3× SPDT Portwahl · 6× SP4T Kopplerbank",
    "50 / 75 Ω switch": "50/75-Ω-Umschalter",
    "AD8318 log detector": "AD8318 Log-Detektor",
    "RF power → DC voltage": "HF-Leistung → Gleichspannung",
    "Device under test": "Messobjekt (DUT)",
    "SDI cable, filter, amp …": "SDI-Kabel, Filter, Verstärker …",
    "LEDs + SDI button": "LEDs + SDI-Taster",
    "on the PCB · through holes in the case": "auf der Platine · durch Bohrungen im Gehäuse",
    "coupled wave": "ausgekoppelte Welle",
    "RF signal": "HF-Signal",
    "measured / coupled wave": "gemessene / ausgekoppelte Welle",
    "RF control": "HF-Steuerung",
    "digital bus": "Digitalbus",
    "supply rails": "Versorgungsschienen",
    "Measures how much RF power a device reflects (S11, S22) and lets through (S21, S12) — magnitude only, no phase.":
        "Misst, wie viel HF-Leistung ein Messobjekt reflektiert (S11, S22) und durchlässt (S21, S12) — nur Betrag, "
        "keine Phase.",

    # --- hw-02 power tree ----------------------------------------------------------------------------------------------
    "Power tree": "Spannungsversorgung",
    "Everything from USB (≤ 500 mA) · boost + LDOs keep the RF rails quiet":
        "Alles aus USB (≤ 500 mA) · Boost + LDOs halten die HF-Schienen ruhig",
    "LC filter": "LC-Filter",
    "LDL212 · RF ctrl": "LDL212 · HF-Steuerung",
    "LDL212 · detector": "LDL212 · Detektor",
    "NCP702 · PLL charge pump": "NCP702 · PLL-Ladungspumpe",
    "NCP702 · attenuator + amp": "NCP702 · Dämpfung + Verstärker",
    "NCP702 · RF switches": "NCP702 · HF-Schalter",
    "MAX2871 charge pump": "MAX2871 Ladungspumpe",
    "RF switches": "HF-Schalter",
    "RP2350B · flash · EEPROM · LEDs": "RP2350B · Flash · EEPROM · LEDs",
    "RP2350B · flash · EEPROM": "RP2350B · Flash · EEPROM",
    "Why this structure": "Warum diese Struktur",
    "• Boost to 6 V gives every LDO headroom": "• Boost auf 6 V gibt jedem LDO Reserve",
    "• LDOs sit next to their circuit": "• LDOs sitzen direkt bei ihrer Schaltung",
    "• Ferrite bead after every LDO": "• Ferrit nach jedem LDO",
    "• 0 Ω link per rail for bring-up": "• 0-Ω-Brücke pro Schiene für die Inbetriebnahme",
    "• Digital switcher kept away from the RF rails": "• Digitaler Schaltregler fern von den HF-Schienen",

    # --- hw-03 MCU -----------------------------------------------------------------------------------------------------
    "All 48 GPIOs used · every GPIO has a series resistor to soften edges":
        "Alle 48 GPIOs belegt · jeder GPIO hat einen Serienwiderstand gegen steile Flanken",
    "ESD diodes · reverse-polarity FET": "ESD-Dioden · Verpolschutz-FET",
    "SWD header": "SWD-Stecker",
    "debug / flashing (J202)": "Debug / Flashen (J202)",
    "12 MHz crystal": "12-MHz-Quarz",
    "on the PCB · 7 LEDs · 1 button": "auf der Platine · 7 LEDs · 1 Taster",
    "MAX2871 synthesizer": "MAX2871 Synthesizer",
    "HMC1119 attenuator": "HMC1119 Dämpfungsglied",
    "7 bit parallel + LE · 8 pins": "7 Bit parallel + LE · 8 Pins",
    "TRF37A73 amplifier": "TRF37A73 Verstärker",
    "power-down · 1 pin": "Power-down · 1 Pin",
    "LPF 4 · coupler 12 · port 2 · Z 2 pins": "LPF 4 · Koppler 12 · Port 2 · Z 2 Pins",
    "AD8318 detector": "AD8318 Detektor",
    "ADC input + enable · 2 pins": "ADC-Eingang + Enable · 2 Pins",
    "SPI + CE, LD, MUX, RF_EN · 7 pins": "SPI + CE, LD, MUX, RF_EN · 7 Pins",
    "W25Q128 flash": "W25Q128 Flash",
    "QSPI · firmware (boot)": "QSPI · Firmware (Boot)",
    "I2C · calibration, SDI test": "I2C · Kalibrierung, SDI-Test",
    "+ internal 1.1 V core buck": "+ interner 1.1-V-Core-Buck",
    "core 0: USB, JSON, calibration": "Kern 0: USB, JSON, Kalibrierung",
    "core 1: all RF hardware": "Kern 1: gesamte HF-Hardware",

    # --- hw-04 RF chain ------------------------------------------------------------------------------------------------
    "RF chain": "HF-Kette",
    "One source routed to port 1 or 2 · one directional coupler measures every direction":
        "Eine Quelle auf Port 1 oder 2 · ein Richtkoppler misst jede Richtung",
    "Signal generation": "Signalerzeugung",
    "100 MHz reference": "100-MHz-Referenz",
    "LPF bank — removes harmonics": "Tiefpassbank — entfernt Oberwellen",
    "Port select": "Portwahl",
    "SPDT, absorptive": "SPDT, absorbierend",
    "source → port 1 or 2": "Quelle → Port 1 oder 2",
    "other port → 50 Ω": "anderer Port → 50 Ω",
    "Coupler bank — 6× RFSW6042 SP4T": "Kopplerbank — 6× RFSW6042 SP4T",
    "−5.6 dB pad": "−5.6-dB-Pad",
    "5.6 dB pad": "5.6-dB-Pad",
    "directional coupler": "Richtkoppler",
    "Switches put the coupler into the measured port (either direction); the other port takes the matching pad.":
        "Die Schalter legen den Koppler in den gemessenen Port (beide Richtungen); der andere Port erhält das "
        "passende Pad.",
    "pad −5.7 dB": "Pad −5.7 dB",
    "log detector · −55 … 0 dBm": "Log-Detektor · −55 … 0 dBm",
    "12 bit · median of 16": "12 Bit · Median aus 16",
    "Core 1 firmware": "Firmware Kern 1",
    "dB = ΔADC / slope": "dB = ΔADC / Steigung",

    # --- hw-05 PLL -----------------------------------------------------------------------------------------------------
    "Turns a fixed 100 MHz reference into any frequency from 23.5 MHz to 6 GHz":
        "Macht aus einer festen 100-MHz-Referenz jede Frequenz von 23.5 MHz bis 6 GHz",
    "Phase / freq.": "Phasen-/Frequenz-",
    "Charge": "Ladungs-",
    "pump": "pumpe",
    "Loop filter": "Schleifenfilter",
    "external RC": "externes RC",
    "450 kHz BW": "450 kHz Bandbreite",
    "frac-N, M = 4095": "Frac-N, M = 4095",
    "RF out": "HF-Ausgang",
    "Lock detect": "Lock-Erkennung",
    "LD pin → MCU": "LD-Pin → MCU",
    "tune voltage": "Abstimmspannung",
    "feedback": "Rückkopplung",
    "MAX2871 — fractional-N PLL": "MAX2871 — Fractional-N-PLL",
    "Example 1 GHz:  VCO = 100 MHz · 40 = 4 GHz,  DIV = 4": "Beispiel 1 GHz:  VCO = 100 MHz · 40 = 4 GHz,  DIV = 4",
    "Loop locks when the divided VCO matches the reference in phase. Firmware waits for LD (stable 500 µs) before measuring.":
        "Die Schleife rastet ein, wenn der geteilte VCO phasengleich mit der Referenz ist. Die Firmware wartet vor "
        "dem Messen auf LD (500 µs stabil).",

    # --- hw-06 coupler paths -------------------------------------------------------------------------------------------
    "How one coupler measures S11 and S21": "Wie ein Koppler S11 und S21 misst",
    "Source on port 1 · three readings per frequency · all values in dB":
        "Quelle an Port 1 · drei Messwerte pro Frequenz · alle Werte in dB",
    "P1_FWD — wave going out of port 1": "P1_FWD — Welle, die Port 1 verlässt",
    "P1_BWD — wave reflected by the DUT": "P1_BWD — vom DUT reflektierte Welle",
    "P2_BWD — wave transmitted through the DUT": "P2_BWD — durch das DUT übertragene Welle",
    "port switch": "Portschalter",
    "→ forward": "→ vorwärts",
    "← backward": "← rückwärts",
    "cable · filter": "Kabel · Filter",
    "incident / transmitted wave": "einfallende / übertragene Welle",
    "reflected wave": "reflektierte Welle",
    "coupled sample → reading": "Koppelanteil → Messwert",
    "Source on port 2 is the mirror image: S22 = P2_BWD − P2_FWD,  S12 = P1_BWD − P2_FWD.  The pad gives the unused side the same loss as switches + coupler.":
        "Quelle an Port 2 ist spiegelbildlich: S22 = P2_BWD − P2_FWD,  S12 = P1_BWD − P2_FWD.  Das Pad gibt der "
        "unbenutzten Seite dieselbe Dämpfung wie Schalter + Koppler.",

    # --- hw-07 pads ----------------------------------------------------------------------------------------------------
    "Resistive pads": "Widerstands-Pads",
    "Matching 50 Ω to 75 Ω and balancing path losses — chosen values, checked by calculation":
        "50 Ω an 75 Ω anpassen und Pfadverluste angleichen — gewählte Werte, rechnerisch geprüft",
    "50 Ω → 75 Ω minimum-loss pad (each port)": "50 Ω → 75 Ω Minimum-Loss-Pad (jeder Port)",
    "50 Ω side": "50-Ω-Seite",
    "75 Ω side": "75-Ω-Seite",
    "Looking in from 50 Ω side: 86.6 ∥ (43.2 + 75) =": "Von der 50-Ω-Seite gesehen: 86.6 ∥ (43.2 + 75) =",
    "Looking in from 75 Ω side: 43.2 + (86.6 ∥ 50) =": "Von der 75-Ω-Seite gesehen: 43.2 + (86.6 ∥ 50) =",
    "Insertion loss:": "Einfügedämpfung:",
    "(the price of a resistive match)": "(der Preis einer resistiven Anpassung)",
    "5.6 dB T-pad (coupler bank, unused port)": "5.6-dB-T-Pad (Kopplerbank, unbenutzter Port)",
    "Input impedance: 15.4 + 71.5 ∥ 65.4 =": "Eingangsimpedanz: 15.4 + 71.5 ∥ 65.4 =",
    "Attenuation:": "Dämpfung:",
    "= loss of 2 switches + coupler": "= Verlust von 2 Schaltern + Koppler",
    "→ both ports see the same path loss, readings stay comparable":
        "→ beide Ports sehen denselben Pfadverlust, Messwerte bleiben vergleichbar",
    "0.1 % thin-film resistors (0402) keep the match accurate up to 6 GHz.":
        "0.1-%-Dünnschichtwiderstände (0402) halten die Anpassung bis 6 GHz genau.",

    # --- hw-08 stackup -------------------------------------------------------------------------------------------------
    "PCB — stackup and RF layout rules": "PCB — Lagenaufbau und HF-Layoutregeln",
    "JLCPCB JLC04161H-7628 · 4 layers · 1.6 mm · ENIG": "JLCPCB JLC04161H-7628 · 4 Lagen · 1.6 mm · ENIG",
    "Signal + GND  ·  RF lines, components": "Signal + GND  ·  HF-Leitungen, Bauteile",
    "GND  ·  unbroken reference plane": "GND  ·  durchgehende Referenzfläche",
    "Power + signal  ·  rails, slow digital": "Versorgung + Signal  ·  Schienen, langsame Digitalsignale",
    "Signal + GND  ·  digital, LEDs": "Signal + GND  ·  Digital, LEDs",
    "Core · 1.07 mm": "Kern · 1.07 mm",
    "Grounded coplanar waveguide (cross-section)": "Koplanarleitung mit Massefläche (Querschnitt)",
    "L2 GND plane": "L2 GND-Fläche",
    "50 Ω SE (SMA side) · 75 Ω SE (BNC side) · 90 Ω differential (USB)":
        "50 Ω SE (SMA-Seite) · 75 Ω SE (BNC-Seite) · 90 Ω differenziell (USB)",
    "widths from the JLCPCB impedance calculator, vias from Saturn PCB Toolkit":
        "Breiten aus dem JLCPCB-Impedanzrechner, Vias aus dem Saturn PCB Toolkit",
    "Layout rules": "Layoutregeln",
    "• Never route RF or USB over a gap in the L2 ground plane": "• HF und USB nie über eine Lücke in der L2-Massefläche führen",
    "• GND via next to every signal via → short return path (also for the SPI bus)":
        "• GND-Via neben jedem Signal-Via → kurzer Rückstrompfad (auch für den SPI-Bus)",
    "• Via fence along RF lines": "• Via-Zaun entlang der HF-Leitungen",
    "• ESD diodes right at the connectors with a short ground return":
        "• ESD-Dioden direkt an den Steckern mit kurzer Masseanbindung",
    "• RF section shielded by the milled aluminium case (pockets per section)":
        "• HF-Teil durch das gefräste Aluminiumgehäuse geschirmt (Taschen pro Bereich)",

    # --- hw-09 sheets --------------------------------------------------------------------------------------------------
    "Schematic — 6 sheets + overview": "Schema — 6 Blätter + Übersicht",
    "Altium project SNA.PrjPcb · sheets connected with harnesses": "Altium-Projekt SNA.PrjPcb · Blätter über Harnesses verbunden",
    "3  RF Source": "3  HF-Quelle",
    "LMK6C 100 MHz reference": "LMK6C 100-MHz-Referenz",
    "MAX2871 PLL + loop filter": "MAX2871 PLL + Schleifenfilter",
    "LPF bank: 2× RFSW6042,": "Tiefpassbank: 2× RFSW6042,",
    "4  RF Attenuation / Amp": "4  HF-Dämpfung / Verstärker",
    "3× QPC6324 port select": "3× QPC6324 Portwahl",
    "5  RF Directional Coupler": "5  HF-Richtkoppler",
    "SEDC-10-63+ coupler": "SEDC-10-63+ Koppler",
    "5.6 dB pads": "5.6-dB-Pads",
    "6  RF Ports": "6  HF-Ports",
    "50→75 Ω pads": "50→75-Ω-Pads",
    "SMA + BNC per port": "SMA + BNC pro Port",
    "RF ESD diodes": "HF-ESD-Dioden",
    "RP2350B · W25Q128 flash · 24AA32A EEPROM · 12 MHz crystal": "RP2350B · W25Q128 Flash · 24AA32A EEPROM · 12-MHz-Quarz",
    "USB-C + ESD + reverse polarity · SWD · LEDs + buttons": "USB-C + ESD + Verpolschutz · SWD · LEDs + Taster",
    "1  Power": "1  Stromversorgung",
    "MIC2253 boost 6 V · 3× LDL212 5 V · AP2114 + 3× NCP702 3.3 V": "MIC2253 Boost 6 V · 3× LDL212 5 V · AP2114 + 3× NCP702 3.3 V",
    "TPS62802 buck 3.3 V (digital) · ferrite beads · 0 Ω bring-up links":
        "TPS62802 Buck 3.3 V (digital) · Ferrite · 0-Ω-Brücken",
    "control (SPI / GPIO)": "Steuerung (SPI / GPIO)",
    "detector voltage → ADC": "Detektorspannung → ADC",
    "Every rail and every GPIO is RC / ferrite filtered at the sheet boundary.":
        "Jede Schiene und jeder GPIO ist an der Blattgrenze RC- / Ferrit-gefiltert.",

    # --- fw-01 dual core -----------------------------------------------------------------------------------------------
    "Firmware — two cores, one job each": "Firmware — zwei Kerne, je eine Aufgabe",
    "RP2350B · bare metal C11 · Pico SDK + TinyUSB · no RTOS": "RP2350B · Bare Metal C11 · Pico SDK + TinyUSB · kein RTOS",
    "USB CDC · JSON lines": "USB CDC · JSON-Zeilen",
    "Core 0 — communication": "Kern 0 — Kommunikation",
    "CDC line reader / writer": "CDC-Zeilen lesen / schreiben",
    "parse · validate · reply": "parsen · prüfen · antworten",
    "ADC counts → dB − calibration": "ADC-Werte → dB − Kalibrierung",
    "I2C · cal curves in RAM": "I2C · Kal.-Kurven im RAM",
    "LEDs · SDI button · watchdog": "LEDs · SDI-Taster · Watchdog",
    "Core 1 — RF hardware": "Kern 1 — HF-Hardware",
    "rf_task loop": "rf_task-Schleife",
    "one request": "eine Anfrage",
    "or one sweep point": "oder ein Sweep-Punkt",
    "per step": "pro Schritt",
    "application  rf_app_*": "Anwendung  rf_app_*",
    "state  rf_state_*": "Zustand  rf_state_*",
    "blocks  rf_ctrl_*": "Blöcke  rf_ctrl_*",
    "RF": "HF",
    "request queue": "Anfrage-Queue",
    "8 entries": "8 Einträge",
    "cancel counter": "Abbruchzähler",
    "reply queue": "Antwort-Queue",
    "only link between cores": "einzige Verbindung der Kerne",
    "Core 1 owns every RF chip in every mode → no shared state, no locks.   Core 0 never waits for RF → USB answers status / abort even mid-sweep.":
        "Kern 1 besitzt jeden HF-Chip in jedem Modus → kein geteilter Zustand, keine Locks.   Kern 0 wartet nie auf "
        "HF → USB beantwortet status / abort auch mitten im Sweep.",

    # --- fw-02 layers --------------------------------------------------------------------------------------------------
    "Core 1 — four layers": "Kern 1 — vier Schichten",
    "Each layer only calls the one directly below it": "Jede Schicht ruft nur die direkt darunter auf",
    "Application": "Anwendung",
    "State": "Zustand",
    "Blocks": "Blöcke",
    "modes, measurements, boot self-test": "Modi, Messungen, Boot-Selbsttest",
    "current configuration · safe order of every change": "aktuelle Konfiguration · sichere Reihenfolge jeder Änderung",
    "one RF block each: source · coupler · detector · ports": "je ein HF-Block: Quelle · Koppler · Detektor · Ports",
    "one driver per chip: registers and pins": "ein Treiber pro Chip: Register und Pins",
    "Example: retune to f": "Beispiel: auf f umstimmen",
    "MAX2871 · HMC1119 · TRF37A73 · RFSW6042 / QPC6324 switches · AD8318 + ADC":
        "MAX2871 · HMC1119 · TRF37A73 · RFSW6042 / QPC6324 Schalter · AD8318 + ADC",
    "Safety rules (port switch order, double register write after power-up) live in one place: the state layer.":
        "Sicherheitsregeln (Reihenfolge der Portschalter, doppeltes Registerschreiben nach dem Einschalten) stehen "
        "an einer Stelle: in der Zustandsschicht.",

    # --- fw-03 modes ---------------------------------------------------------------------------------------------------
    "Modes — the host borrows the RF hardware": "Modi — der Host leiht sich die HF-Hardware",
    "mode_enter only from IDLE · mode_exit (or USB disconnect) cancels what runs and parks the output":
        "mode_enter nur aus IDLE · mode_exit (oder USB-Trennung) bricht alles ab und parkt den Ausgang",
    "output parked": "Ausgang geparkt",
    "source running": "Quelle läuft",
    "sweep — S-parameters or raw paths": "sweep — S-Parameter oder Rohpfade",
    "any number of sweeps · status / set / abort allowed mid-sweep":
        "beliebig viele Sweeps · status / set / abort während des Sweeps erlaubt",
    "CW signal on port 1 or 2 · level changes live": "CW-Signal an Port 1 oder 2 · Pegel live änderbar",
    "external power at a port · streamed events": "externe Leistung an einem Port · gestreamte Events",
    "single blocks for bench diagnostics": "einzelne Blöcke für die Labordiagnose",
    "Any time, any mode": "Jederzeit, in jedem Modus",
    "Only requests that would endanger the hardware are refused — everything else is the host's call.":
        "Abgelehnt wird nur, was die Hardware gefährden würde — alles andere entscheidet der Host.",

    # --- fw-04 sweep sequence ------------------------------------------------------------------------------------------
    "A sweep, end to end": "Ein Sweep, von Anfang bis Ende",
    "Points stream while they are measured · core 1 measures point i+1 while core 0 sends point i":
        "Punkte streamen während der Messung · Kern 1 misst Punkt i+1, während Kern 0 Punkt i sendet",
    "Core 0": "Kern 0",
    "Core 1": "Kern 1",
    "core 1": "Kern 1",
    "RF hardware": "HF-Hardware",
    "validate · load cal curves into RAM": "prüfen · Kal.-Kurven ins RAM laden",
    "SWEEP request  (request queue)": "SWEEP-Anfrage  (Anfrage-Queue)",
    "park · set z + level · tune f0 · wait lock": "parken · z + Pegel · f0 abstimmen · Lock abwarten",
    "loop · every point": "Schleife · jeder Punkt",
    "tune f · route source · read coupler paths": "f abstimmen · Quelle schalten · Kopplerpfade lesen",
    "ADC medians": "ADC-Mediane",
    "point reply: raw codes  (reply queue)": "Punkt-Antwort: Rohwerte  (Antwort-Queue)",
    "dB − interpolated calibration": "dB − interpolierte Kalibrierung",
    "park output": "Ausgang parken",
    "final reply + status": "letzte Antwort + Status",

    # --- fw-05 sweep point ---------------------------------------------------------------------------------------------
    "One sweep point on core 1": "Ein Sweep-Punkt auf Kern 1",
    "≈ 2 ms with all four S-parameters": "≈ 2 ms mit allen vier S-Parametern",
    "Select LPF": "Tiefpass wählen",
    "for frequency f": "für Frequenz f",
    "MAX2871 registers": "MAX2871-Register",
    "Route source": "Quelle schalten",
    "switch port, then": "Port schalten, dann",
    "release attenuator": "Dämpfung freigeben",
    "Select path": "Pfad wählen",
    "first coupler path": "erster Kopplerpfad",
    "PLL locked": "PLL eingerastet",
    "within 20 ms?": "innerhalb 20 ms?",
    "Mark point": "Punkt markieren",
    "Detector settle": "Detektor einschwingen",
    "Read reference": "Referenz lesen",
    "Read DUT side": "DUT-Seite lesen",
    "requested?": "angefordert?",
    "Source → port 2": "Quelle → Port 2",
    "read P2_FWD, P2_BWD,": "P2_FWD, P2_BWD,",
    "Raw ADC medians": "ADC-Rohmediane",
    "→ reply queue → core 0": "→ Antwort-Queue → Kern 0",
    "Every reading": "Jede Messung",
    "select coupler path": "Kopplerpfad wählen",
    "settle 100 µs": "100 µs einschwingen",
    "16 ADC samples": "16 ADC-Samples",
    "The output stays routed between points; it is parked only when the sweep ends.":
        "Der Ausgang bleibt zwischen den Punkten geschaltet; geparkt wird erst am Ende des Sweeps.",

    # --- fw-06 timing --------------------------------------------------------------------------------------------------
    "Where the time goes": "Wohin die Zeit geht",
    "Estimated per point, all four S-parameters (from profiling of the earlier firmware)":
        "Geschätzt pro Punkt, alle vier S-Parameter (aus Messungen an der früheren Firmware)",
    "PLL lock + stable LD": "PLL-Lock + stabiles LD",
    "6 path reads": "6 Pfade lesen",
    "previous point: dB · cal · JSON · USB": "vorheriger Punkt: dB · Kal. · JSON · USB",
    "Pipelined over several points": "Pipeline über mehrere Punkte",
    "Speed levers (next steps)": "Hebel für mehr Tempo (nächste Schritte)",
    "1. Shorter LD stability wait (biggest fixed cost)": "1. Kürzere LD-Stabilitätswartezeit (größter Fixanteil)",
    "2. Characterize settle times on the bench": "2. Einschwingzeiten im Labor ausmessen",
    "3. Write only changed MAX2871 registers / faster SPI": "3. Nur geänderte MAX2871-Register schreiben / schnelleres SPI",
    "4. Less JSON per point": "4. Weniger JSON pro Punkt",

    # --- fw-07 source states -------------------------------------------------------------------------------------------
    "RF source — OFF · PARKED · ON": "HF-Quelle — OFF · PARKED · ON",
    "Every change goes through rf_state_set_source() so the order is always safe":
        "Jede Änderung läuft über rf_state_set_source(), so ist die Reihenfolge immer sicher",
    "synth + amp powered down": "Synth + Verstärker aus",
    "running · output terminated": "läuft · Ausgang abgeschlossen",
    "routed to port 1 or 2": "auf Port 1 oder 2 geschaltet",
    "port switch → port": "Portschalter → Port",
    "attenuator → 127 (max)": "Dämpfung → 127 (max)",
    "switch → 50 Ω": "Schalter → 50 Ω",
    "power up → registers written": "Einschalten → Register geschrieben",
    "twice, ≥ 20 ms apart": "zweimal, ≥ 20 ms Abstand",
    "park first, then power down": "erst parken, dann ausschalten",
    "Why the order matters": "Warum die Reihenfolge zählt",
    "The amplifier delivers about 12–15 dBm at 0 dB attenuation. Switching to the termination first would dump that into the switch's 50 Ω resistor.":
        "Der Verstärker liefert bei 0 dB Dämpfung etwa 12–15 dBm. Zuerst auf den Abschluss zu schalten würde das "
        "in den 50-Ω-Widerstand des Schalters leiten.",
    "So: attenuate fully before terminating, and route before releasing the attenuator.":
        "Also: vor dem Abschließen voll dämpfen, und vor dem Freigeben der Dämpfung schalten.",
    "Between sweeps the source stays PARKED and running: stable temperature, fast retune, no repeated power-up.":
        "Zwischen Sweeps bleibt die Quelle PARKED und läuft: stabile Temperatur, schnelles Umstimmen, kein "
        "wiederholtes Einschalten.",

    # --- fw-08 calibration ---------------------------------------------------------------------------------------------
    "The client does the math · the device stores, interpolates and subtracts":
        "Der Client rechnet · das Gerät speichert, interpoliert und subtrahiert",
    "Client — calibration wizard (per impedance)": "Client — Kalibrier-Assistent (pro Impedanz)",
    "S11 curve": "S11-Kurve",
    "S22 curve": "S22-Kurve",
    "S21 + S12 curves": "S21- + S12-Kurven",
    "average of Open + Short (port 1)": "Mittel aus Open + Short (Port 1)",
    "average of Open + Short (port 2)": "Mittel aus Open + Short (Port 2)",
    "Thru reading directly": "Thru-Messung direkt",
    "Device EEPROM — 8 curves": "Geräte-EEPROM — 8 Kurven",
    "240 points": "240 Punkte",
    "one shared frequency grid · 0.01 dB per step (int16)": "ein gemeinsames Frequenzraster · 0.01 dB pro Stufe (int16)",
    "cal_set over USB": "cal_set über USB",
    "upload the computed curve, not the raw sweeps": "lädt die berechnete Kurve hoch, nicht die Roh-Sweeps",
    "every point:": "jeder Punkt:",
    "curve(f) linearly interpolated between the two nearest of the 240 stored points · outside the stored range the point is sent with \"cal\": false":
        "curve(f) linear interpoliert zwischen den zwei nächsten der 240 gespeicherten Punkte · außerhalb des "
        "Bereichs wird der Punkt mit \"cal\": false gesendet",

    # --- fw-09 EEPROM --------------------------------------------------------------------------------------------------
    "EEPROM map — 24AA32A, 4096 bytes": "EEPROM-Belegung — 24AA32A, 4096 Bytes",
    "Fits because the 8 curves share one frequency grid and store only int16 dB values":
        "Passt, weil die 8 Kurven ein Frequenzraster teilen und nur int16-dB-Werte speichern",
    "Whole device, to scale": "Ganzer Baustein, maßstäblich",
    "Zoom: first 244 bytes (0x000 – 0x0F3)": "Zoom: erste 244 Bytes (0x000 – 0x0F3)",
    "Cal grid": "Kal.-Raster",
    "magic · format · hw rev · serial": "Magic · Format · HW-Rev. · Seriennr.",
    "up to 15 points: f · threshold · S-param · < or >": "bis 15 Punkte: f · Schwelle · S-Param. · < oder >",
    "Why it fits": "Warum es passt",
    "8 curves × 240 points × 2 bytes =": "8 Kurven × 240 Punkte × 2 Bytes =",
    "Frequencies are not stored per point: point k sits at f0 + (f1 − f0)·k / 239":
        "Frequenzen werden nicht pro Punkt gespeichert: Punkt k liegt bei f0 + (f1 − f0)·k / 239",
    "Values are int16 in 0.01 dB → ±327 dB range, 0.01 dB resolution":
        "Werte sind int16 in 0.01 dB → ±327 dB Bereich, 0.01 dB Auflösung",
    "Total used:": "Belegt:",
    "4084 of 4096 bytes": "4084 von 4096 Bytes",

    # --- fw-10 boot ----------------------------------------------------------------------------------------------------
    "Boot and LEDs": "Boot und LEDs",
    "Self-test at power-up · result on the LEDs and in status.init_errors · LEDs and button sit on the PCB, seen through holes in the case":
        "Selbsttest beim Einschalten · Ergebnis auf den LEDs und in status.init_errors · LEDs und Taster sitzen "
        "auf der Platine, sichtbar durch Bohrungen im Gehäuse",
    "GPIO init": "GPIO-Init",
    "BOOTED fast blink": "BOOTED blinkt schnell",
    "Launch core 1": "Kern 1 starten",
    "EEPROM init": "EEPROM-Init",
    "USB start": "USB-Start",
    "Wait for ready": "Auf Bereitschaft warten",
    "+ error bits": "+ Fehlerbits",
    "Heartbeat": "Herzschlag",
    "or red error code": "oder roter Fehlercode",
    "RF init": "HF-Init",
    "source off 1 s → power up → tune 1 GHz (double write) → lock wait ≤ 2 s → parked detector check":
        "Quelle 1 s aus → einschalten → 1 GHz abstimmen (doppelt schreiben) → Lock ≤ 2 s → Detektortest geparkt",
    "ready + error bits": "bereit + Fehlerbits",
    "Blink codes (red LED)": "Blinkcodes (rote LED)",
    "EEPROM not readable / writable": "EEPROM nicht lesbar / beschreibbar",
    "synthesizer did not lock": "Synthesizer rastet nicht ein",
    "detector reading implausible": "Detektorwert unplausibel",
    "LEDs while running": "LEDs im Betrieb",
    "1 short pulse per second = firmware alive": "1 kurzer Puls pro Sekunde = Firmware läuft",
    "brightness = load of both cores (PWM)": "Helligkeit = Last beider Kerne (PWM)",
    "set by core 1 together with the switches": "von Kern 1 zusammen mit den Schaltern gesetzt",
    "one green / red blink per test point": "ein grünes / rotes Blinken pro Testpunkt",

    # --- api-01 / api-02 -----------------------------------------------------------------------------------------------
    "API — JSON lines over USB": "API — JSON-Zeilen über USB",
    "USB CDC (virtual COM port) · one JSON object per line · no driver needed":
        "USB CDC (virtueller COM-Port) · ein JSON-Objekt pro Zeile · kein Treiber nötig",
    "or any serial terminal": "oder jedes serielle Terminal",
    "firmware 0.4": "Firmware 0.4",
    "protocol 3": "Protokoll 3",
    "Every request gets exactly one final reply with the same id · frequencies are integer Hz · errors carry a code (and the bad field)":
        "Jede Anfrage bekommt genau eine abschließende Antwort mit derselben id · Frequenzen in ganzen Hz · Fehler "
        "tragen einen Code (und das fehlerhafte Feld)",
    "API — commands by mode": "API — Befehle nach Modus",
    "Enter a mode, use its commands, leave it again": "Modus betreten, seine Befehle nutzen, wieder verlassen",
    "Any mode": "Jeder Modus",
    "sweep (raw)": "sweep (roh)",
    "detector on paths": "Detektor auf Pfaden",
    "one reading": "ein Messwert",
    "→ power events": "→ Power-Events",

    # --- sw-01 client --------------------------------------------------------------------------------------------------
    "One code base for Windows/Linux desktop (JVM) and Android · Compose UI":
        "Eine Codebasis für Windows/Linux-Desktop (JVM) und Android · Compose UI",
    "one screen per tab": "ein Screen pro Tab",
    "state per connection": "Zustand pro Verbindung",
    "survives tab changes": "überlebt Tabwechsel",
    "SnaClient · coroutines": "SnaClient · Coroutinen",
    "id matching": "id-Zuordnung",
    "mode ownership": "Modus-Besitz",
    "desktop: jSerialComm": "Desktop: jSerialComm",
    "USB CDC → SNA device": "USB CDC → SNA-Gerät",

    # --- fw-11 request path --------------------------------------------------------------------------------------------
    "A request through the firmware": "Eine Anfrage durch die Firmware",
    "Core 0 answers what it can at once · RF work goes to core 1 and comes back as exactly one reply":
        "Kern 0 beantwortet sofort, was er kann · HF-Arbeit geht an Kern 1 und kommt als genau eine Antwort zurück",
    "JSON line": "JSON-Zeile",
    "from USB": "von USB",
    "parse + validate": "parsen + prüfen",
    "core 0 · protocol.c": "Kern 0 · protocol.c",
    "reply at once": "sofort antworten",
    "EEPROM commands · ping · errors": "EEPROM-Befehle · ping · Fehler",
    "pending table": "Pending-Tabelle",
    "8 slots · id → request": "8 Plätze · id → Anfrage",
    "mode check → rf_app_*": "Modusprüfung → rf_app_*",
    "runs the hardware": "steuert die Hardware",
    "sweep points stream first": "Sweep-Punkte streamen vorher",
    "raw codes → dB − calibration": "Rohwerte → dB − Kalibrierung",
    "JSON reply": "JSON-Antwort",
    "same id · to USB": "gleiche id · an USB",
    "no hardware involved": "ohne Hardware",
    "RF commands": "HF-Befehle",
    "While a sweep runs": "Während ein Sweep läuft",
    "allowed": "erlaubt",
    "mid-sweep?": "im Sweep?",
    "handled between two points": "zwischen zwei Punkten bearbeitet",
    "error: busy": "Fehler: busy",
    "Allowed mid-sweep:": "Im Sweep erlaubt:",
    "abort, mode_exit, a USB disconnect or a 2 s host stall cancel everything queued before them (cancel counter).":
        "abort, mode_exit, eine USB-Trennung oder 2 s Host-Stillstand brechen alles vorher Eingereihte ab "
        "(Abbruchzähler).",

    # --- fw-12 raw to dB -----------------------------------------------------------------------------------------------
    "Raw codes → calibrated dB": "Rohwerte → kalibrierte dB",
    "Done on core 0 for every point, while core 1 already measures the next one":
        "Auf Kern 0 für jeden Punkt, während Kern 1 schon den nächsten misst",
    "reference path": "Referenzpfad",
    "measured path": "Messpfad",
    "ratio in dB": "Verhältnis in dB",
    "(measured − reference) / slope": "(Messung − Referenz) / Steigung",
    "slope ≈ −30.4 counts / dB": "Steigung ≈ −30.4 Counts / dB",
    "cal curve": "Kal.-Kurve",
    "covers f?": "deckt f ab?",
    "− interpolated curve": "− interpolierte Kurve",
    "between the 2 nearest": "zwischen den 2 nächsten",
    "of 240 stored points": "von 240 gespeicherten Punkten",
    "uncorrected": "unkorrigiert",
    "sent with \"cal\": false": "gesendet mit \"cal\": false",
    "JSON point": "JSON-Punkt",
    "Frequency grid — computed, never sent": "Frequenzraster — berechnet, nie gesendet",
    "exact integer Hz": "exakte ganze Hz",
    "rounded to the Hz": "auf Hz gerundet",
    "Firmware and client compute the same grid, so the client can draw placeholders before the data arrives; missing points stay gaps.":
        "Firmware und Client berechnen dasselbe Raster, so zeichnet der Client Platzhalter, bevor die Daten da sind; "
        "fehlende Punkte bleiben Lücken.",

    # --- fw-13 SDI button + watchdog -----------------------------------------------------------------------------------
    "SDI button and watchdog": "SDI-Taster und Watchdog",
    "The button test works without a PC · the watchdog resets a stuck device":
        "Der Tastertest läuft ohne PC · der Watchdog setzt ein hängendes Gerät zurück",
    "SDI test button (on the PCB, pressed through the case)": "SDI-Testtaster (auf der Platine, durch das Gehäuse gedrückt)",
    "short orange blink": "kurzes oranges Blinken",
    "no points stored · nothing measured": "keine Punkte gespeichert · keine Messung",
    "short red blink": "kurzes rotes Blinken",
    "not idle (a host mode is active)": "nicht IDLE (ein Host-Modus ist aktiv)",
    "sweep mode · atten 0 · z 75": "Sweep-Modus · atten 0 · z 75",
    "green / red blink": "grünes / rotes Blinken",
    "per test point": "pro Testpunkt",
    "result shown → back to idle": "Ergebnis gezeigt → zurück zu IDLE",
    "abort / mode_exit from the host": "abort / mode_exit vom Host",
    "Test points (f, S-parameter, threshold, < or >) come from sdi_test_set and live in EEPROM.":
        "Testpunkte (f, S-Parameter, Schwelle, < oder >) kommen über sdi_test_set und liegen im EEPROM.",
    "With a host connected the result is also sent as an sdi_test_result event.":
        "Mit verbundenem Host kommt das Ergebnis zusätzlich als sdi_test_result-Event.",
    "core 0 main loop": "Hauptschleife Kern 0",
    "core 1 step": "Schritt Kern 1",
    "must finish < 6 s": "muss < 6 s dauern",
    "RP2350 hardware timer": "RP2350-Hardware-Timer",
    "device re-enumerates on USB": "Gerät meldet sich neu an USB an",
    "Every blocking wait is bounded (lock waits 2 s), so a healthy device never trips it.":
        "Jedes blockierende Warten ist begrenzt (Lock-Warten 2 s), ein gesundes Gerät löst ihn also nie aus.",

    # --- api-03 / api-04 -----------------------------------------------------------------------------------------------
    "API — two typical sessions": "API — zwei typische Sitzungen",
    "The client borrows a mode, uses it, gives it back": "Der Client leiht sich einen Modus, nutzt ihn, gibt ihn zurück",
    "Generator, then power meter": "Generator, dann Leistungsmesser",
    "every point": "jeder Punkt",
    "every interval": "jedes Intervall",
    "more sweeps … status / set / abort allowed meanwhile": "weitere Sweeps … status / set / abort dazwischen erlaubt",
    "park → tune → wait lock → route": "parken → abstimmen → Lock abwarten → schalten",
    "ok (level changes live)": "ok (Pegel ändert sich live)",
    "streamed point": "gestreamter Punkt",
    "API — how a request can fail": "API — wie eine Anfrage scheitern kann",
    "Checked in this order · the first failing check is the error code":
        "In dieser Reihenfolge geprüft · die erste fehlschlagende Prüfung ist der Fehlercode",
    "valid JSON +": "gültiges JSON +",
    "known cmd?": "bekannter Befehl?",
    "arguments": "Argumente",
    "right mode,": "richtiger Modus,",
    "not busy?": "nicht busy?",
    "+ result fields": "+ Ergebnisfelder",
    "Error reply — same id, a code, and the offending field for bad_args":
        "Fehlerantwort — gleiche id, ein Code und bei bad_args das fehlerhafte Feld",
    "Every code with its meaning: PROTOCOL.md, section Errors.": "Alle Codes mit Bedeutung: PROTOCOL.md, Abschnitt Errors.",

    # =================================================================================================================
    # --- animations ----------------------------------------------------------------------------------------------------
    "(the mean would be 1501.5, pulled by the spikes)": "(der Mittelwert wäre 1501.5, verzogen durch die Ausreißer)",
    "+13 dBm into the 50 Ω resistor!": "+13 dBm in den 50-Ω-Widerstand!",
    "+13 dBm out": "+13 dBm Ausgang",
    "+3 dBm out": "+3 dBm Ausgang",
    "−19 dBm out": "−19 dBm Ausgang",
    "≈ 2 ms per point": "≈ 2 ms pro Punkt",
    "≈ 500 mA total from USB": "≈ 500 mA gesamt aus USB",
    "→ efficient, digital only": "→ effizient, nur Digital",
    "→ quiet RF rails": "→ ruhige HF-Schienen",
    "← replies": "← Antworten",
    "… and take the middle: the spikes have no effect": "… und den mittleren nehmen: die Ausreißer wirken nicht",
    "…repeated for every frequency of the sweep: ≈ 2 ms per point":
        "…wiederholt für jede Frequenz des Sweeps: ≈ 2 ms pro Punkt",
    "1  The client sends one JSON line over USB": "1  Der Client sendet eine JSON-Zeile über USB",
    "1. boost 5 V → 6 V": "1. Boost 5 V → 6 V",
    "1.8 GHz low-pass filter": "1.8-GHz-Tiefpass",
    "1216 counts": "1216 Counts",
    "1520 counts": "1520 Counts",
    "12-bit ADC: −30.4 counts/dB": "12-Bit-ADC: −30.4 Counts/dB",
    "16 samples → median": "16 Samples → Median",
    "2  Core 0 checks it and queues a request for core 1": "2  Kern 0 prüft sie und reiht eine Anfrage für Kern 1 ein",
    "2. … then release the attenuator to the requested level": "2. … dann die Dämpfung auf den gewünschten Pegel freigeben",
    "2. … then switch to the termination: it only gets a weak signal":
        "2. … dann auf den Abschluss schalten: er bekommt nur ein schwaches Signal",
    "2. 5 V LDOs per area": "2. 5-V-LDOs pro Bereich",
    "3  Core 1 sets up the RF path for 1 GHz": "3  Kern 1 richtet den HF-Pfad für 1 GHz ein",
    "3. one LDO per RF circuit": "3. ein LDO pro HF-Schaltung",
    "4  The RF wave travels to the cable, part of it is reflected":
        "4  Die HF-Welle läuft zum Kabel, ein Teil wird reflektiert",
    "4. digital: its own buck": "4. Digital: eigener Buck",
    "5  The coupler samples the forward wave, then the reflected wave":
        "5  Der Koppler tastet die Vorwärtswelle ab, dann die reflektierte",
    "50 → 75 Ω pad": "50 → 75 Ω Pad",
    "50 Ω and 75 Ω on every port": "50 Ω und 75 Ω an jedem Port",
    "50 Ω mode: straight to the SMA jack": "50-Ω-Modus: direkt zur SMA-Buchse",
    "50 Ω termination": "50-Ω-Abschluss",
    "6  Raw codes go back to core 0 through the reply queue": "6  Rohwerte gehen über die Antwort-Queue zurück zu Kern 0",
    "75 Ω mode: through the pad to the BNC jack": "75-Ω-Modus: über das Pad zur BNC-Buchse",
    "7  Core 0 turns the two codes into dB and applies the calibration":
        "7  Kern 0 macht aus den zwei Werten dB und wendet die Kalibrierung an",
    "8  One JSON line per point goes back to the client": "8  Pro Punkt geht eine JSON-Zeile zurück an den Client",
    "A 100 MHz crystal oscillator is the reference": "Ein 100-MHz-Quarzoszillator ist die Referenz",
    "A command of another mode during the sweep is refused": "Ein Befehl eines anderen Modus wird während des Sweeps abgelehnt",
    "a power ratio is just the difference of two readings — no logarithm needed":
        "ein Leistungsverhältnis ist einfach die Differenz zweier Messwerte — kein Logarithmus nötig",
    "A sweep, point by point": "Ein Sweep, Punkt für Punkt",
    "After a power-up (OFF → PARKED) the MAX2871 needs its registers written twice":
        "Nach dem Einschalten (OFF → PARKED) braucht der MAX2871 seine Register zweimal",
    "at the same time": "gleichzeitig",
    "Atten + Amp": "Dämpfung + Verstärker",
    "Atten/Amp 3.3 V": "Dämpfung/Verst. 3.3 V",
    "between sweeps the source stays PARKED and running (stable temperature, fast retune)":
        "zwischen Sweeps bleibt die Quelle PARKED und läuft (stabile Temperatur, schnelles Umstimmen)",
    "cal_set uploads each curve as 240 points (0.01 dB steps) into the EEPROM":
        "cal_set lädt jede Kurve als 240 Punkte (0.01-dB-Stufen) ins EEPROM",
    "CE on": "CE an",
    "Charge pump + loop filter turn the phase error into a tuning voltage":
        "Ladungspumpe + Schleifenfilter machen aus dem Phasenfehler eine Abstimmspannung",
    "Charge pump": "Ladungspumpe",
    "Client wizard: 5 raw sweeps with known standards (per impedance)":
        "Client-Assistent: 5 Roh-Sweeps mit bekannten Standards (pro Impedanz)",
    "Closing the loop: the VCO is pulled onto N × f_PFD": "Die Schleife schließt sich: der VCO wird auf N × f_PFD gezogen",
    "core 0: dB + calibration + JSON + USB ≈ 0.5–0.8 ms": "Kern 0: dB + Kalibrierung + JSON + USB ≈ 0.5–0.8 ms",
    "Core 1 measures one point (all four S-parameters)": "Kern 1 misst einen Punkt (alle vier S-Parameter)",
    "corrected = cable": "korrigiert = Kabel",
    "corrected = raw − correction  →  only the cable is left": "korrigiert = roh − Korrektur  →  nur das Kabel bleibt",
    "correction": "Korrektur",
    "Coupler moves to port 2: it catches what went through the DUT":
        "Koppler wechselt an Port 2: er fängt ein, was durch das DUT ging",
    "datasheet requirement: the VCO needs time to settle after power-up":
        "Datenblattvorgabe: der VCO braucht nach dem Einschalten Zeit zum Einschwingen",
    "Detector 5 V": "Detektor 5 V",
    "device → PC": "Gerät → PC",
    "Directional coupler: seeing one direction": "Richtkoppler: sieht nur eine Richtung",
    "done once per power-up; normal retunes write the registers once":
        "einmal pro Einschalten; normales Umstimmen schreibt die Register einmal",
    "e.g. cable": "z. B. Kabel",
    "EEPROM 24AA32A · 4 KB · 8 curves × 240 points": "EEPROM 24AA32A · 4 KB · 8 Kurven × 240 Punkte",
    "Enter the sweep mode": "In den Sweep-Modus wechseln",
    "Every point travels through a reply queue with 8 places": "Jeder Punkt läuft durch eine Antwort-Queue mit 8 Plätzen",
    "Forward wave (source → DUT): a −10 dB copy reaches CPL": "Vorwärtswelle (Quelle → DUT): eine −10-dB-Kopie erreicht CPL",
    "Fractional N (F/M) gives fine frequency steps; the SNA sweeps 50 MHz – 6 GHz":
        "Fractional N (F/M) ergibt feine Frequenzschritte; der SNA misst 50 MHz – 6 GHz",
    "frequency 0 – 6 GHz": "Frequenz 0 – 6 GHz",
    "from coupler bank": "von der Kopplerbank",
    "If USB stalls, the queue fills up and core 1 waits: no point is lost":
        "Stockt USB, füllt sich die Queue und Kern 1 wartet: kein Punkt geht verloren",
    "input power (dBm)": "Eingangsleistung (dBm)",
    "LD: high → locked": "LD: high → eingerastet",
    "lock ✓": "Lock ✓",
    "locked ✓": "eingerastet ✓",
    "log detector": "Log-Detektor",
    "Log detector: power → voltage": "Log-Detektor: Leistung → Spannung",
    "LPF bank": "Tiefpassbank",
    "matched both ways — price: 5.7 dB insertion loss (removed by calibration)":
        "in beide Richtungen angepasst — Preis: 5.7 dB Einfügedämpfung (durch Kalibrierung entfernt)",
    "MAX2871: PLL frequency synthesis": "MAX2871: PLL-Frequenzsynthese",
    "Measuring a cable: the raw S21 contains the cable AND the analyzer's loss":
        "Ein Kabel messen: das rohe S21 enthält das Kabel UND den Verlust des Analysators",
    "median = 1500": "Median = 1500",
    "median of 16 ADC samples each": "jeweils Median aus 16 ADC-Samples",
    "Minimum-loss pad: 50 Ω ↔ 75 Ω": "Minimum-Loss-Pad: 50 Ω ↔ 75 Ω",
    "mode_exit → back to IDLE": "mode_exit → zurück zu IDLE",
    "mode_exit cancels the running sweep and returns to IDLE": "mode_exit bricht den laufenden Sweep ab, zurück zu IDLE",
    "mode_exit stops the output and frees the hardware again": "mode_exit stoppt den Ausgang und gibt die Hardware frei",
    "Modes and commands": "Modi und Befehle",
    "more power → lower voltage": "mehr Leistung → kleinere Spannung",
    "Noise and single spikes (red) disturb individual ADC readings":
        "Rauschen und einzelne Ausreißer (rot) stören einzelne ADC-Werte",
    "ON: full power goes out of port 1": "ON: volle Leistung geht aus Port 1",
    "One coupler, six SP4T switches": "Ein Koppler, sechs SP4T-Schalter",
    "One measurement point": "Ein Messpunkt",
    "One mode owns the RF hardware at a time": "Immer nur ein Modus besitzt die HF-Hardware",
    "Open / Short: all power is reflected → ideal S11 = 0 dB": "Open / Short: alle Leistung wird reflektiert → ideal S11 = 0 dB",
    "output (V)": "Ausgang (V)",
    "P1_BWD  ·  source on port 1": "P1_BWD  ·  Quelle an Port 1",
    "P1_BWD = reflected": "P1_BWD = reflektiert",
    "P1_FWD  ·  source on port 1": "P1_FWD  ·  Quelle an Port 1",
    "P1_FWD = reference": "P1_FWD = Referenz",
    "P2_BWD  ·  source on port 1": "P2_BWD  ·  Quelle an Port 1",
    "P2_BWD = transmitted": "P2_BWD = übertragen",
    "Parking the right way: 1. attenuator to 127 (−31.75 dB) …": "Richtig parken: 1. Dämpfung auf 127 (−31.75 dB) …",
    "Parking the WRONG way: switch to the termination first …": "FALSCH parken: zuerst auf den Abschluss schalten …",
    "PC → device": "PC → Gerät",
    "phase detector": "Phasendetektor",
    "phase error": "Phasenfehler",
    "PLL lock": "PLL-Lock",
    "port 2: Open + Short → S22 correction (the same way)": "Port 2: Open + Short → S22-Korrektur (genauso)",
    "Port switch": "Portschalter",
    "power up": "einschalten",
    "Power: clean rails for the RF part": "Stromversorgung: saubere Schienen für den HF-Teil",
    "queue full → wait": "Queue voll → warten",
    "range: 3 GHz ÷ 128 = 23.4 MHz   …   6 GHz ÷ 1 = 6 GHz": "Bereich: 3 GHz ÷ 128 = 23.4 MHz   …   6 GHz ÷ 1 = 6 GHz",
    "Ratios become subtractions": "Verhältnisse werden zu Differenzen",
    "Raw S11 with Open and with Short: real paths have loss and ripple":
        "Rohes S11 mit Open und mit Short: reale Pfade haben Verlust und Welligkeit",
    "ref  = 1500": "Ref  = 1500",
    "reference  (P1_FWD)": "Referenz  (P1_FWD)",
    "Reference: the wave going out of port 1": "Referenz: die Welle, die Port 1 verlässt",
    "reflected  (P1_BWD)": "reflektiert  (P1_BWD)",
    "Reflected wave (DUT → source): coupled into the internal 50 Ω, CPL stays dark":
        "Reflektierte Welle (DUT → Quelle): geht in den internen 50 Ω, CPL bleibt dunkel",
    "removing the analyzer's own losses": "die eigenen Verluste des Analysators entfernen",
    "reply queue (8)": "Antwort-Queue (8)",
    "requests →": "Anfragen →",
    "RF switch 3.3 V": "HF-Schalter 3.3 V",
    "Routing is the reverse: 1. switch to the port while still attenuated …":
        "Schalten ist umgekehrt: 1. auf den Port schalten, solange noch gedämpft …",
    "S11 (dB) over frequency": "S11 (dB) über der Frequenz",
    "S11 = (1520 − 1216) ÷ (−30.4 counts/dB) =": "S11 = (1520 − 1216) ÷ (−30.4 Counts/dB) =",
    "S11 at 1 GHz, from click to chart": "S11 bei 1 GHz, vom Klick bis zum Diagramm",
    "S11 correction = average of Open and Short: the ripple cancels":
        "S11-Korrektur = Mittel aus Open und Short: die Welligkeit hebt sich auf",
    "S11 correction": "S11-Korrektur",
    "S21 / S12 correction = the Thru reading itself": "S21-/S12-Korrektur = die Thru-Messung selbst",
    "S21 correction": "S21-Korrektur",
    "Same pattern for the other modes, e.g. the signal generator":
        "Gleiches Muster für die anderen Modi, z. B. den Signalgenerator",
    "seen from the 50 Ω side:": "von der 50-Ω-Seite gesehen:",
    "seen from the 75 Ω side:": "von der 75-Ω-Seite gesehen:",
    "Settings like the output level can be changed in every mode, even live":
        "Einstellungen wie der Ausgangspegel sind in jedem Modus änderbar, auch live",
    "slope −24.5 mV/dB": "Steigung −24.5 mV/dB",
    "Sort the 16 values …": "Die 16 Werte sortieren …",
    "source on port 2 (mirrored):  S22 = P2_BWD − P2_FWD    S12 = P1_BWD − P2_FWD":
        "Quelle an Port 2 (gespiegelt):  S22 = P2_BWD − P2_FWD    S12 = P1_BWD − P2_FWD",
    "Start a sweep: the points stream back as they are measured":
        "Sweep starten: die Punkte streamen zurück, sobald sie gemessen sind",
    "sweep point between two stored points": "Sweep-Punkt zwischen zwei gespeicherten Punkten",
    "Switches flip the coupler: now it sees what comes back from port 1":
        "Die Schalter drehen den Koppler: jetzt sieht er, was von Port 1 zurückkommt",
    "Switching the RF source safely": "Die HF-Quelle sicher schalten",
    "synth off · terminated · atten 127": "Synth aus · abgeschlossen · atten 127",
    "synth running · routed to a port · atten = level": "Synth läuft · auf Port geschaltet · atten = Pegel",
    "synth running · terminated · atten 127": "Synth läuft · abgeschlossen · atten 127",
    "target: N × f_PFD = 40 × 100 MHz = 4.000 GHz": "Ziel: N × f_PFD = 40 × 100 MHz = 4.000 GHz",
    "The device interpolates the stored curve at every sweep frequency":
        "Das Gerät interpoliert die gespeicherte Kurve bei jeder Sweep-Frequenz",
    "the host enters a mode, uses it, leaves it": "der Host betritt einen Modus, nutzt ihn, verlässt ihn",
    "the order of two steps matters": "die Reihenfolge zweier Schritte zählt",
    "The other port gets a pad with the same loss as switches + coupler":
        "Der andere Port bekommt ein Pad mit demselben Verlust wie Schalter + Koppler",
    "The output divider reaches the low frequencies": "Der Ausgangsteiler erreicht die tiefen Frequenzen",
    "The phase detector compares reference and feedback": "Der Phasendetektor vergleicht Referenz und Rückkopplung",
    "The sweep finishes, the client draws the whole curve": "Der Sweep endet, der Client zeichnet die ganze Kurve",
    "The VCO frequency is divided by N and fed back": "Die VCO-Frequenz wird durch N geteilt und zurückgeführt",
    "Three source states": "Drei Quellenzustände",
    "Thru: all power arrives at the other port → ideal S21 = 0 dB":
        "Thru: alle Leistung kommt am anderen Port an → ideal S21 = 0 dB",
    "tune 1 GHz": "1 GHz abstimmen",
    "two CPU cores work in a pipeline": "zwei CPU-Kerne arbeiten als Pipeline",
    "usable: −55 … 0 dBm": "nutzbar: −55 … 0 dBm",
    "USB busy": "USB belegt",
    "wait ≥ 20 ms": "≥ 20 ms warten",
    "wait for PLL lock …": "auf PLL-Lock warten …",
    "While core 1 measures point N+1, core 0 sends point N": "Während Kern 1 Punkt N+1 misst, sendet Kern 0 Punkt N",
    "write R5 … R0": "R5 … R0 schreiben",
    "Z switch": "Z-Schalter",
}
