ml3rc/SNA/(commit log)

2026-08-20 schematic sheets
2026-08-21 power schematic
2026-08-25 schematic done(not checked)
2026-08-26 pcb rules
2026-08-26 pcb component grouping
2026-08-27 routing pcb
2026-08-29 pcb routing hf
2026-08-29 pcb routing digital
2026-09-01 pcb almost done
2026-09-02 finallizing pcb
2026-09-03 output data and solder dxf files
2026-09-04 case design and file exports
2026-09-05 corrected top case min hole size
2026-09-07 added assembly drawing
2026-09-19 fix bottom solder mistake
